110-kenichi/A1200LineDoubler/work/handoff_pending/README.txt

未検証の入力同期候補です。v0.27の基準ファイルではありません。V_IN/H_IN_3V3/V_IN_3V3が未完了。監査は未実行。修正後にwork/route_sync_in.pyで再生成し、.kicad_proを揃えてwork/audit_sync_in.pyで検査してください。
