110-kenichi/A1200LineDoubler/outputs/amiga_scandoubler/fab/v030wip/README.md

# 製造データ v0.30wip（2026-09-29）

**発注用の確定版ではない。** JLC などへのアップロードはしていない（CLAUDE.md の規則）。

## 中身
| ファイル | 内容 | 作り方 |
|---|---|---|
| `gerber/*.gtl .g2 .g3 .gbl` | 銅箔4層（F / In1=GND / In2=3V3 / B） | `kicad-cli pcb export gerbers`（KiCad 7.0.11、Protel 拡張子、Value を除外、シルクからマスク開口を削る） |
| `gerber/*.gts .gbs .gtp .gbp .gto .gbo .gm1` | マスク、ペースト、シルク、外形 | 同上 |
| `gerber/*-PTH.drl`, `*-NPTH.drl`, `*_map.svg` | ドリル（Excellon、mm、PTH と NPTH を分割）と穴位置の図 | `kicad-cli pcb export drill --excellon-separate-th --generate-map` |
| `cpl_raw.csv` | KiCad の部品位置データ（上面139点） | `kicad-cli pcb export pos --side front` |
| `jlc_cpl.csv`, `jlc_bom.csv` | JLC 形式の CPL と BOM（37行） | `work/v030wip/w30/scripts/r10_fab.py` |
| `parts_to_select.csv` | LCSC 番号が未選定の部品（32行、132点） | 同上 |
| `fab_check.json` | ドリルのヒット数と基板の照合結果 | 同上 |
| `preview_top.png` | 上面のプレビュー（gerbv で描画） | gerbv |
| `bitstream/*.fs` | FPGA ビットストリーム（H_SAMPLES 1816 / 2048） | apycula `gowin_pack -d GW1N-4 --sspi_as_gpio`（v0.31 cst で配置配線した結果から） |
| `*SHA256SUMS` | 各ファイルのハッシュ | sha256sum |

## 検査（実測）
- 対象の基板：`hardware/amiga_scandoubler_v030wip.kicad_pcb`。
- DRC：エラー0件、未接続0件。
  - 残っている警告は、ライブラリ設定（lib_footprint_issues、クラウドにライブラリの設定がないため）と、USB コネクタ J3 の外形シルクが基板端にかかる2件。
- 監査 `audit_sync_in_k7.py`：PASS（139部品、600パッドのネット）。
- 回路図とネットリストと基板のネットは一致（接続のある570ノード。未接続ピン25は除く）。
- ドリル：PTH 323 ＝ ビア285 ＋ PTH パッド38、NPTH 2。基板と一致した（J1/J2 をスルーホール品にした後の値）。
- RTL シミュレーション：12本すべて PASS（`work/v031dac/sim/`）。

## 発注前に必要なこと（未完了）
1. ~~**部品選定**~~：完了（全139点に LCSC 番号、2026-09-29。下の「部品選定」の節と `parts_selection.csv`）。
2. **CPL の補正と、JLC の実装プレビューでの確認（必須、利用者側）**
   - EasyEDA（JLC のライブラリ）のフットプリントと照合し、回転と位置の補正を `jlc_cpl.csv` / `jlc_cpl_dnp_J1J2.csv` に入れた（2026-09-30）。U1/U3/U4/U5 +270°、U2 180→90°、U6 180°、J4 90→0°、J3 は位置を 1.571mm 補正。根拠と全数の表は `cpl_rotation_check.md`。
   - これは EasyEDA のデータとの照合結果で、JLC の実装機がどう解釈するかまでは保証しない。**支払いの前に、発注画面の部品配置プレビュー（上面）で次を確認する。**ずれていたら発注画面で直すか、`jlc_rotation_check.json` を直して `r10_fab.py` を再実行する。
     - **J3（USB-C）**：差し込み口が基板の下端に来ること。4本の固定脚が長穴4個（x 43.18 / 51.82、y 88.22 / 92.40）に、2本の位置決めピンが穴2個（44.61 / 50.39, 88.75）に重なること。CPL の座標は KiCad の値から y 方向に 1.571mm 基板の内側へずらしてある（`cpl_raw.csv` の Mid Y −91.350 → `jlc_cpl` −89.779）。脚が長穴から外れていたら、この補正の解釈が違う。
     - **U1（TQFP-100）**：1番ピンが左上（18.35, 36.00）。CPL 回転 270°。
     - **U2（QFN-88）**：1番ピンが**右下**（54.95, 46.20）。基板上で 180° 回転している。CPL 回転 90°。
     - U3（左上）、U4/U5/U6、Y1（**左下**）、J4、U7–U9：`cpl_rotation_check.md` の「JLC のプレビューで確かめること」の表のとおり。
3. **ビアの処理：U1/U2 の中央パッド（EP）内のビアは「Epoxy Filled & Capped」（樹脂充填＋銅キャップ、POFV）を指定する（必須）**
   - 対象：U1 の EP（pad 101、6.2mm 角、中心 26.0, 42.0）に9個、U2 の EP（pad 89、6.8mm 角、中心 50.0, 42.0）に9個、計18個。すべて GND、外径 0.5mm／穴 0.3mm（2026-10-01 に 0.6mm から変更）。
     - U1：(24.0/25.5/27.0, 40.0/41.5/43.0) の 3×3。
     - U2：(48.0/50.0/52.0, 40.0/42.0/44.0) の 3×3。
     - ほかにパッドの中にあるビアはない（全285個を照合、2026-10-01）。
   - JLC の「**Plugged**」は、ソルダーレジスト（インク）でビアを埋める処理で、両面ともレジストの開口がないビアが対象（JLC の PCB capabilities の記載）。EP はレジストが開いているので**使えない**。「Tented」（レジストで覆うだけ）も EP 内では覆えない。どちらを選んでも、リフローではんだがビアに吸い込まれ、EP の接合不良（放熱・GND 不良）の原因になる。
   - JLC の「Epoxy Filled & Capped」は、ビアを樹脂で埋めて銅めっきでふたをする「via-in-pad」用の処理。6層以上では標準だが、この基板は4層なので、**注文画面の Via Covering で明示して選ぶ**。対応する径は「via diameters 0.15–0.55mm」（同じ記載）。JLC は「via diameter」を外径の意味でも使うため、EP 内の18個は外径を 0.5mm に下げた（穴 0.3mm のまま）。穴径・外径のどちらの意味でも範囲内。
     - 注意：外径 0.5／穴 0.3mm はランド幅 0.10mm で、JLC の DFM で「Annular ring」の警告が出る可能性がある（以前の DFM では 0.10mm 以下が危険の表示）。EP の中にあり、銅キャップで覆われるので、機能上は問題ない。
     - ほかのビアは外径 0.55mm（120個）と 0.6mm（146個）。Via Covering が基板全体に効き、かつ上限が外径の意味なら、0.6mm のものが範囲を外れる。発注画面で確認する。
   - 注文画面の Via Covering は基板全体に対する指定と思われる（未確認）。その場合、ほかのビア（267個）も同じ処理になるが、問題はない。費用の増加は発注画面で確認する。
   - 「Copper paste Filled & Capped」（銅ペースト充填）も使えるが、必須ではない。
4. **層構成**：インピーダンス制御は指定していない。JLC の標準4層（1.6mm）を想定。
5. **ビットストリーム**：
   - apycula のオープンソースツールで生成したもので、実機でも Gowin 純正ツールでも未検証。
   - 生成時に apycula が「IOLOGIC の INIT が未処理」と表示した（ODDR の初期値）。
   - H_SAMPLES 1816/2048 は暫定値で、PAL/NTSC の確定値ではない。
6. ~~**ERC**~~：KiCad 9 CLI で実行済み（2026-09-29）。除外（`hardware/erc_exclusions.json`）を適用して残り0件。詳細は revision_0.30wip.md。

## 部品選定（2026-09-29、JLCPCB の部品検索 API で在庫・価格を取得）
- スクリプト：`work/v030wip/w30/scripts/r11_select.py`（選定）→ `r11_apply.py`（manifest、回路図、ネットリストへ反映）。
  - 仕様は `r11_parts_spec.json`。API の呼び出しは `tools/jlcsel.py`（読み取りのみ。注文はしていない）。
- 結果は `parts_selection.csv` / `.json`：LCSC 番号、基本/拡張の区分、在庫、5枚分の数量での単価、代替2件。
- 選定の規則：
  - パッケージと仕様（容量、耐圧、誘電体、抵抗値、許容差、0.1% は薄膜）が一致するもの。
  - 基本部品 → 優先拡張部品 → 在庫の多いもの、の順。
  - 在庫は必要数の20倍以上を優先する。
- 確定したもの：37行中 35行（135点）。
  - 基本部品 15行、拡張部品 22行。
  - 部品代の目安は約 60.7 USD/枚（取得時点の単価。拡張部品の手数料と基板代は含まない）。
- 耐圧：C55/57/59（5V 入力）と C47/C54 は 25V の 10uF（CL21A106KAYNNNE、C15850）。回路図の値の表記「10V」は最低定格の意味として残した。
- **2026-09-29 追記（利用者の判断）**：
  - 製作は **2枚**。選定の数量も2枚分でやり直した（`BOARDS=2`）。
    - JLCPCB の PCBA は Economic・Standard とも最少2枚（公式の capabilities ページで確認）。
  - **Y1 を YXC OT2EL4C4JI-111OLP-27M（C5203549）に置き換えた**（`scripts/r12_y1.py`）。フットプリントは同じ。
  - U1 TVP7002（C3824085）はそのまま使う。在庫4個で、必要数2個に対して余裕は小さい。
  - J1/J2 は CONEC 33DSMT1-E15SNCT（C3146802、在庫0、0.76mm ピッチの SMD）から、**HOAUC HYC06-HDR15B-060（C711364、在庫2230、スルーホール）に置き換えた**（下の節）。
- 全139点の LCSC 番号がそろった。部品代の目安は約 44.6 USD/枚（2枚分の数量での単価。拡張部品の手数料、基板代は含まない。J1/J2 の2点分を含む。置き換え前は約 60.3 USD/枚）。

## J1・J2（DE-15 メス）：HOAUC HYC06-HDR15B-060、手はんだ（2026-09-29、利用者の判断）
- 部品：HOAUC HYC06-HDR15B-060（LCSC C711364、JLC 拡張部品、在庫2230、0.21 USD）。3列 HD-15 メス、90°曲げ、スルーホール。
  - データシート（2013-09-20 版）で寸法を確認：端子穴 φ1.09 の3列が基板の端から 3.08 / 5.06 / 7.04mm、横ピッチ 2.29mm。固定金具の PTH φ3.2 が2つ、25mm 間隔（中段と同じ列）。本体は基板の端から 8.9mm まで、前方に 5.9mm はみ出す。
  - フットプリント：`hardware/Amiga.pretty/DE15_HOAUC_HYC06-HDR15B-060.kicad_mod`（穴 1.1mm／ランド 1.7mm、固定金具 3.2mm／4.0mm、GND ＝ pad16）。
  - ピンの並びは DE-15 の規格どおり（部品面から見て pin1・pin6 が右側。KiCad 標準フットプリントと同じ）。データシートの穴配置図には「Top View」とあり、この並びと一致する。
- 発注：`jlc_bom_dnp_J1J2.csv`（36行）、`jlc_cpl_dnp_J1J2.csv`（137点）で J1・J2 を除き、ほかの部品を JLCPCB で実装する。J1・J2 は LCSC で別に買って手はんだで付ける。
  - JLC にスルーホール実装も任せる場合は、元の `jlc_bom.csv` / `jlc_cpl.csv`（139点）を使う（在庫あり）。
- 付け方の目安（推定）：端子15本・固定金具2本とも、はんだごてで1本ずつ付けられる。固定金具は熱容量が大きいので、こて先は太めを使う。付けたあと、テスターで隣どうしの短絡と、J1/J2 の各ピン ↔ 相手（J1：R15〜R18・R20、J2：R11〜R13・R22・R23）の導通を確認する。
- 旧 CONEC 品は Global Sourcing が必要だったが、その手配は不要になった。

## JLCPCB の DFM と発注画面への対応（2026-09-30）

- 詳細は `revision_0.30.md` の追記。基板を変更し、製造データを出し直した。
- ビアを31個動かした（パッドに近すぎる・パッドの中にあるもの）。J3 の長穴を 0.8mm に広げた。部品番号を50個置き直した。
- L1〜L3 を Taiyo Yuden NRS4018T2R2MDGJ（C92959）に変更（旧品は EasyEDA にフットプリントがなく、配置画面に出なかった）。
- C47/C54/C55/C57/C59 の値を「10uF 25V」にそろえ、BOM を1行にした。
- U1（在庫4）：発注画面の実装数を **2枚** にする。
- DFM で残るもの（対応不要と判断）：U2/U3 のピン間 0.2mm、0.5/0.3mm のビア1個（リング 0.10mm）、C18.1 とビアの隙間 0.05mm（同じネット）、同じネットの配線とマスク開口の近さ、ビアのリング 0.125mm（橙）。
- 2026-09-30 追記：IC のピンとピンの間を通っていた配線（U1 の11組・U3 の3組・U5.5）を撤去し、つなぎ直した。JLC DFM の「Solder mask opening exposing trace」の危険1件（U1.84/85）の原因。
- 2026-09-30 追記：同じネットで重なっていた配線（44組）と行き止まりの配線を削除し、U1.93/94・C27・C28 周りの配線を整えた（電気的な接続は変わらない）。
- 2026-10-01 追記：C27–U1 間の GND の配線、C21 の 3V3 ビアの位置、U4.5–C51 の配線を整えた（電気的な接続は変わらない）。
- 2026-10-01 追記：ルーターが残した細かい段差（短い斜め線と水平・垂直線の繰り返し）をならし、不要な GND の回り込みを削除した（電気的な接続は変わらない）。
- 2026-10-01 追記：EP 内ビアの指定を「Plugged」から「Epoxy Filled & Capped（POFV）」に訂正し、対象18個を明記した。JLC のプレビューで確かめる項目（J3 の位置、U1/U2 の1番ピン）を具体的に書いた（利用者の指摘）。
- 2026-10-01 追記：U1/U2 の EP 内のビア18個の外径を 0.6mm から 0.5mm に変えた（穴 0.3mm のまま、`scripts/ep_via05.py`）。
- 2026-10-01 追記：配線の角のはみ出しを直した（5V 幹線と C55/C57/C59 の縦線の幅をそろえ、C59 側の延び過ぎを削った。U3.31・U1.15 の GND の端）。
- 2026-10-01 追記：JLC の DFM（発注画面）の指摘を直した（シルクとパッド・穴、C27 付近の配線）。U2 の1番ピンの印を少し移し、「REV 0.30」の文字を Y1 の右へ移した。残る危険3項目（Pad spacing・Annular ring・Via to pad）は許容と判断した（revision_0.30.md）。
