110-kenichi/A1200LineDoubler/outputs/amiga_scandoubler/hardware/footprint_review.md

# フットプリントの確認記録

2026-09-09。回路図に対応する部品実装パターンの検討版。配線済み基板ではない。

## FPGA：GW1N-LV4QN88C6/I5

ローカルライブラリー`Amiga.pretty`に`QFN-88_GW1N4_10x10_P0.4_EP6.8`を作成した。GOWIN UG103-2.9.6Eの図4-25・図4-26（冊子108–109ページ、PDF122–123ページ）を確認した。

- 本体10mm角、信号88端子、ピッチ0.4mm。
- メーカー推奨ランドは0.85 × 0.20mm、対向する列の中心間隔9.90mm。
- 中央の銅箔ランドは6.8mm角、回路図の89番（GND）へ接続する。
- 前版の名称にあったEP6.7を訂正した。パッケージ側の公称6.74mmとPCB推奨ランドの6.8mmを区別する。
- ペーストは1.4mm角×16窓、1.6mmピッチの案。中央銅箔に対する面積比は約67.8%。これは製造側と調整する設計値で、メーカー図面の指定値ではない。

## ADC：TVP7002PZP

`TQFP-100_TVP7002_14x14_P0.5_EP6.2`を作成した。TI資料末尾の機械図4146929/Cと放熱パッド図4206333-3/Lを確認した。

- 本体14mm角、端子ピッチ0.5mm、外形はリードを含め約16mm角。
- 放熱パッド図の寸法範囲は4.69–6.20mm。前版で仮指定した9.5mm角はこの図面に一致せず、使用を取りやめた。
- 中央銅箔は6.2mm角、101番（GND）。これは実パッケージの放熱パッドを常に6.2mm角と断定するものではない。
- 外周ランドは1.5 × 0.30mm、対向列の中心間隔15.3mmとした。メーカーのリード寸法から選んだ案で、専用推奨ランドの転載ではない。
- 中央ペーストは1.0mm角×16窓、1.15mmピッチ。窓全体は4.45mm角に収め、最小パッド寸法を考慮した。接合面積、放熱性能、ステンシル厚は実装条件と合わせて確認が必要。

## 電源：TPS62160DSGR

KiCad標準`WSON-8-1EP_2x2mm_P0.5mm_EP0.9x1.6mm`をTIのDSG0008A基板例と照合した。外周8端子は0.5 × 0.25mm、ピッチ0.5mm、対向列の中心間隔1.9mm、中央パッドは0.9 × 1.6mmで一致した。

## DE-15：33DSMT1-E15SNCT

メーカー図C041003Aを確認した。信号パッド15個は単純な1～15順ではなく、図面の左から`6,11,1,7,12,2,8,13,3,9,14,4,10,15,5`となる。固定穴は直径3.05mmが2個、位置決め穴は直径1.50mmが2個。間隔はそれぞれ24.99mm、15.46mm。

v0.4で仮フットプリントを作成した。信号パッドは0.30×3.70mm、穴の中心線に対しパッド中心を0.65mmずらした。0.76mmピッチを採用しているため、信号列の両端中心間は10.64mmとなり、図面の全幅10.68mmとの丸め差は未解決事項として残す。本体の表示は保守的な配置予約範囲。基板端との位置、固定脚の実装は未確定であり、製造承認済みのフットプリントではない。

## v0.4追加：発振器・インダクター・USB

ECS-3225MVLCは推奨ランド1.3×1.1mm、中心間隔2.3×1.9mm、端子1を上面視の左下として専用パターンを作成した。TDK VLS4012CX用には1.3×4.0mmの2ランド、ランド間の空き1.4mmのパターンを作成した。

USBにはKiCad標準のHRO TYPE-C-31-M-12用パターンを使用する。メーカーの2020-12-08図面を参照し、端子の対応を確認した。標準パターンと図面では一部の公称寸法・クリアランスが一致しないため、注文時の図面改版と現物への適合確認を残す。

## 検査と残る作業

作成した2パターンはKiCadの基板ライブラリー読込で検査し、89端子／101端子の番号、ピッチ、中央パッド寸法を照合した。結果は`footprint_report.txt`。

中央パッドにサーマルビアはまだ組み込んでいない。基板の銅箔・電源配置と併せて設計する。v0.4では全134部品に配置用のフットプリントを割り当てたが、全品の実装条件を検証済みという意味ではない。BOM/CPLの発注用出力や配線後の基板DRCも未完了。

資料：

- [GOWIN UG103 Package and Pinout](https://cdn.gowinsemi.com.cn/UG103E.pdf)
- [TI TVP7002データシート](https://www.ti.com/lit/ds/symlink/tvp7002.pdf)
- [TI TPS62160データシート](https://www.ti.com/lit/gpn/tps62160)
- [CONECメーカー図C041003A](https://mm.digikey.com/Volume0/opasdata/d220001/medias/docus/1039/33DSMT1-E15SNCT_Dwg.PDF)
