110-kenichi/A1200LineDoubler/revision_0.28.md

# v0.28 入力同期配線（2026-09-27, Claude）

基準：v0.27 `amiga_scandoubler_sync_out.kicad_pcb` → ChatGPT作業途中の入力同期候補（`work/handoff_pending/`）→ 本版。
成果基板：`hardware/amiga_scandoubler_sync_in.kicad_pcb`（KiCad 7形式 version 20221018 のまま。テキスト編集で追記し、KiCad 10で保存していない）。
**製造可能な完成品ではない。未接続146件。**

## 変更内容

| 対象 | 内容 |
|---|---|
| H_IN, H_IN_BUF, V_IN_BUF, U4/C51電源, R19/R21プルアップ | 候補の生成結果をそのまま採用（独立監査で合格） |
| B_IN | J1.3出口の縦配線をx=7.8→8.6mmへ移動（45°ジョグ）。長さ16.33mmで不変。V_IN引出しの通路確保のため |
| V_IN | J1.14 → F.Cu 2.35mm → ビア(8.0,44.28) → B.Cu → ビア(11.5,58.4) → R20.1。総長18.99mm、ビア2 |
| ADC_1V9PLL | U1上辺内側を囲っていたF.Cu冗長ループ（FB3右側→y=35.4の内周）を削除し、ビア(30.9,32.0)を追加してC25側F.Cuと既存In2.Cu経路を接続。総長51.5→38.6mm。C25→U1.84/85は In2経由 約5.5mm＋ビア2（旧：F.Cu約13mm） |
| H_IN_3V3 | U1.81 → QFP内周F.Cu(x=29.45) → ビア(29.45,45.7) → B.Cu斜行 → ビア(18.75,57.35) → U4.6。28.41mm、ビア2 |
| V_IN_3V3 | U1.78 → QFP内周F.Cu(x=31.0) → ビア(27.65,46.3) → B.Cu斜行 → ビア(17.5,56.45) → U4本体下F.Cu → U4.4。33.20mm、ビア2 |
| In1.Cu GND面 | KiCad 10で再充填した充填形状をKiCad 7形式へ移植（再充填なしのDRCでも同結果） |

配線はクラウドで作成した格子A*ルーター（F/B層＋貫通ビア、0.05mm格子、全層・穴間隔・基板端0.5mmを考慮）で探索し、下記の予約領域を与えた。

## 予約・設計上の配慮

- **REF_27M（U1.80）用の脱出路を予約**：ピン80内側F.Cu x=30.0、ビア候補(30.05,37.1)、B.Cu右向き通路y=37.1。H/Vはこれを避けた。
- **U1露出パッド下（22.4–29.6 × 38.4–45.6mm）のB.Cuとビアを予約**：将来のサーマルビア用。H/VのB.Cu配線は露出パッド外。
- U4本体下へのビア配置、SMDパッド上ビア（via-in-pad）を禁止。
- ADCデータが出る下辺・右辺の外側F.Cuは使わない（下辺外側F.Cuを禁止して探索）。

## 独立検査（KiCad 10.0.4）

- `work/audit_sync_in.py`（KiCad 10対応に最小修正：DRCはkicad-cli `--refill-zones`）：**PASS**。既存57接続、電源75・GND80検査、592パッドのネット照合、PLL 4ネットはF.Cuのみ・ビア0を維持。
- 入力同期6ネット・出力同期6ネットとも全端子導通。
- DRC：短絡・クリアランス・穴間隔・配線端/ビア未接続 **0件**。未接続 160→146（v0.27比で減少のみ、増えたネットなし：3V3 17→13、GND 36→34、入力同期6ネット各0）。
- 残る指摘：シルク関連（文字高さ135、シルクと銅箔103、シルク同士25、基板端2）と `lib_footprint_mismatch` 127。後者はKiCad 10付属ライブラリとの差分照合で、基板の電気的不良ではない。

## 未解決・要再評価

1. ADC_1V9PLLのデカップリング経路が変わった（C25→84/85がIn2＋ビア2）。PLL電源品質は再評価が必要。
2. H/V_IN_3V3のB.Cu斜行はU1左下の下側を通る。下辺ピン（ADC_CLK, ADC_B7–B0）をB.Cuで逃がす場合の制約になる。
3. V_IN_3V3はU4本体下を通過（DRC合格、実装上の問題は想定しないが目視確認推奨）。
4. KiCad 7で開いた際の確認は未実施（形式・構文は既存行と同一）。
