110-kenichi/A1200LineDoubler/outputs/amiga_scandoubler/revision_0.30.md

# v0.30 全配線完了・製造データ一次版（2026-09-29, Claude）

基準：v0.29 `hardware/amiga_scandoubler_u2rot.kicad_pcb`（未接続143件）→ 本版 `hardware/amiga_scandoubler_v030wip.kicad_pcb`（KiCad 7 形式 `(version 20221018)` のまま）。
ファイル名の `v030wip` は作業中の名前をそのまま使っている。**この版の内容が v0.30 である。**
作業の詳細な経過は `revision_0.30wip.md`（日付順の作業ログ）にある。

**発注用の確定版ではない。** 発注・アップロードはしていない。実機での検証もしていない。

## 概要

- 全ネットを配線した。DRC エラー0件、未接続0件（v0.29 は143件）。
- FPGA の DAC 側のピン割当を変えた（v0.31 cst）。U2→U3 のバスが交差なしの扇形になった。
- 全139部品に LCSC 番号を付け、JLC 形式の製造データ一式を出した。
- J1/J2 をスルーホールの DE-15 メスに替えた（利用者が手はんだで付ける）。
- ERC を実行した。利用者が決めた除外を適用すると、残りは0件。

## 変更内容

| 対象 | 内容 |
|---|---|
| U1 周り | U1 下辺のパスコンを並べ直し、EP に GND サーマルビアを追加した |
| ADC バス（24本） | 全部 F.Cu でビアなし（R：45°の入れ子、G/B：U 字の帯）。ADC_CLK はビア2個 |
| ADC_HS/VS | 南回りの B.Cu。各ビア4個 |
| 制御線 | I²C・RESET・PWDN（U1↔U2）、プルアップ R37–R40 を 0402 に変更、POWER_GOOD、DAC_PSAVE_N、JTAG 系・設定ピン（4–10番） |
| 1V2 のリンク | U2 の左右とも、B.Cu から In2.Cu へ移した |
| FPGA のピン割当（v0.31） | DAC R0=47、R1–R7=42–36、G=35–28、BLANK=27、B0/B1=26/25、B2–B7=20–15、H/V_OUT=14/13、DAC_CLK=3（ODDR は X0Y1）。RTL は変更なし |
| DAC バス（24本＋BLANK） | 全部 F.Cu で交差なし。ビアは R0 の2個だけ。C42（COMP）を 0402 に変更 |
| H/V_OUT・DAC_CLK | U5・U6・R41–R43 へ配線 |
| 電源 | 浮いていたパッド28個に面ビアを追加。アナログ電源（ADC_3V3A、ADC_1V9PLL、DAC_3V3）を個別に接続 |
| アナログ入力 | RIN/GIN/BIN/SOGIN の残り7本（実際に使う RIN_1 12.1mm、BIN_1 10.0mm、GIN_1 20.1mm） |
| 配線レビューへの対策 | C70/C71（U2 の VCCO のパスコン）、In2 の引き直し（GIN_1 の基準面の切れ目 4.9→4.5mm）、C72/C73（REF_27M のビアの近くのパスコン） |
| シルク | 部品番号を 0.8mm にそろえ、自動で置き直した。R15 だけ非表示（F.Fab には残る） |
| 部品 | 139点（C70–C73 を追加）。Y1 を YXC OT2EL4C4JI-111OLP-27M（C5203549）に変更 |
| J1/J2 | CONEC 33DSMT1-E15SNCT（SMD、在庫0）→ HOAUC HYC06-HDR15B-060（C711364、スルーホール）。新フットプリント `Amiga.pretty/DE15_HOAUC_HYC06-HDR15B-060.kicad_mod` |
| ERC | 9本の電源ネットに PWR_FLAG を追加（05_power）。U3.27/31/33 は `hardware/erc_exclusions.json` で除外 |

## 検査（実測）

- DRC（KiCad 7.0.11、ゾーン再充填後）：エラー0件、未接続0件。
  - 警告は、J3 の外形シルクが基板端にかかる2件と、ライブラリ設定の lib_footprint_issues（クラウドにライブラリ表がないため）だけ。
- 監査 `audit_sync_in_k7.py`：PASS（既存57接続、電源75・GND80の検査、139部品、600パッドのネット）。
- 回路図から書き出したネットリストと基板：接続のある570ノードで一致（ほかに未接続ピンが25）。
- ERC（KiCad 9.0.9 CLI、読み取りのみ、`tools/erc_k9.sh`）：720件。除外（グリッド外717件、U3 の反転出力3件）を適用して残り0件（`tools/erc_check.py`）。
- 製造データ：ドリルのヒット数は PTH 323（ビア285＋PTH パッド38）、NPTH 2 で、基板と一致した。
- FPGA（nextpnr、v0.31 cst）：1816/2048 とも全クロック PASS（2048：video 89.50MHz、adc 310.75MHz、clk_ref 72.61MHz）。verify_phase180 も PASS。
- RTL シミュレーション（Icarus Verilog 12）：12本すべて PASS（82件）。

## 推定値（合格判定ではない）

- ADC 取り込みの余裕：+4.285ns（High 52%、SDF の欠落分を仮定で補った値）。基板上のずれは −0.11〜+0.15ns。
- DAC：データ線 29.6–48.9mm、クロック経路 32.5mm。基板上の差は −21〜+118ps。U2 のパッド遅延が SDF にないため、確定ではない。
- 部品代：約 44.6 USD/枚（2枚分の数量、取得時点の単価。拡張部品の手数料と基板代は含まない）。

## 製造データ（`fab/v030wip/`、詳細は同フォルダーの README）

- Gerber（4層）、ドリル（PTH/NPTH）、CPL、JLC 形式の BOM/CPL、J1/J2 を除いた BOM/CPL（発注用）、プレビュー、SHA256SUMS。
- ビットストリーム：H_SAMPLES 1816/2048 の2種類（apycula で生成、実機未検証）。
- 基板ファイルの sha256：`c9bbe6a87b095d56ab82b0860cec024ec07e15e6281389af86d80c3ab0d01990`。

## 利用者の判断（この版で決めたこと）

- R37–R40 と C42 を 0402 に変更。C37/C31/R4/R9 の移動。
- DAC 側のピン割当の変更（v0.31）。
- 製作は2枚。U1 TVP7002 は在庫4のまま採用。Y1 を置き換え。
- J1/J2 は HYC06-HDR15B-060 にして手はんだで付ける。U1/U2 は JLC で実装する。
- ERC：PWR_FLAG を追加。U3.27/31/33 は回路をそのままにして除外。

## 残っている作業

発注の前：
1. JLC のプレビューで CPL の回転を全数確認する（利用者側）。特に J3 の位置（1.571mm 補正）と U1/U2 の1番ピン。
2. 発注時に、U1/U2 の EP 内のビア（計18個）を **Epoxy Filled & Capped（POFV）** に指定する。（2026-10-01 訂正：以前は「充填（plugged）」と書いていたが、JLC の Plugged はレジストで埋める別の処理で、EP には使えない。）

未評価・未検証：
- J1/J2 の実物のはまり具合（穴径、固定金具、ケースとの位置）。J1 の H/V は基板の端を回るため長くなった。
- C29/C35/C40 と C42 が電源ピン・COMP ピンから離れている点。DAC バスの信号品質とクロストーク。
- U3 の反転出力を GND に落とす使い方（ADV7125 のデータシートでの再確認ができていない）。
- PLL の実際の位相とジッター、hold と recovery/removal、DAC 端子での setup/hold、PSAVE が Low のときのアナログ出力。
- PAL/NTSC の実入力のプロファイル、長いラインと短いラインが続く場合。H_SAMPLES 1816/2048 は暫定値。
- ADC_1V9PLL のデカップリング経路の品質。V_IN_3V3 が U4 本体の下を通る点の目視確認。

## 追記（2026-09-30）CPL の回転の補正

- EasyEDA（JLC のライブラリ）のフットプリントと KiCad のフットプリントを、パッド番号ごとに照合した（`tools/jlc_rotcheck.py`、結果 `fab/v030wip/jlc_rotation_check.json`）。JLC で実装する137点のうち、L1〜L3 以外はすべて照合できた。
- 補正（`scripts/r10_fab.py` が CPL の出力時に適用）：U1/U3/U4/U5 +270°、U2 180→90°、U6 +180°（x −0.033mm）、J4 90→0°、J3 は位置を 1.571mm 基板の内側へ。2端子部品で 90° ずれるものは0件。
- J1/J2 の EasyEDA フットプリントは、信号ピンの並びがこの基板と同じだった（ピンの左右の向きの裏付け）。
- 基板・回路図は変更していない。プレビューでの確認は `fab/v030wip/cpl_rotation_check.md` の表で行う。

## 追記（2026-09-30）JLCPCB の DFM と発注画面への対応

利用者が JLCPCB の DFM（PCB DFM）と部品の画面で確認した結果への対応。基板を変更した。

### DFM の赤の項目と対応

| DFM の項目 | 原因（基板データで特定） | 対応 |
|---|---|---|
| Pad spacing（表面 赤10） | パッドと同じネットのビアの間隔 0.05〜0.063mm（C11/C18/C34/C43/C46/C5/C54、FB1〜FB4）。JLC はビアのランドもパッドとして数える | ビアを動かした（下記） |
| Via to pad（赤1） | U2.67 と 3V3 ビア (45.6, 47.6)。穴の縁からパッドまで 0.114mm | ビアを動かした |
| Annular ring（赤1・橙98） | 0.5/0.3mm の GND ビア (17.15, 46.45) のリング 0.10mm。橙は 0.55/0.3mm のビア（0.125mm） | 0.55mm に広げると U1.22 と ADC_1V9A の配線とのクリアランスが足りない（0.175mm）ので **そのまま**。JLC の製造能力の範囲内 |
| Slot width（赤4） | J3 の固定用の長穴4個、幅 0.6mm | **幅 0.8mm・パッド 1.2mm に広げた**（JLC/EasyEDA の C165948 のフットプリントと同じ幅）。新フットプリント `Amiga.pretty/USB_C_Receptacle_HRO_TYPE-C-31-M-12_Slot0.8.kicad_mod` |
| Solder mask opening exposing trace（赤7） | パッドにつながる同じネットの配線やビアが、パッドの開口の近くにある。別のネットの銅が開口から 0.15mm 以内にあるものは0件（実測） | 短絡の恐れはないので対応なし。ビアの移動で一部は解消 |
| Silkscreen to pad（赤36）／to hole（赤50） | 部品番号がパッドやビアの穴に近い | 50個の部品番号を置き直した。FB2/R16/R17 は置き場所がなく非表示（F.Fab には残る。R15 と合わせて4個） |

### DFM では出ていなかったが見つけた問題：受動部品のパッドの中のビア

- C56/C58/C60（22µF）、C59（10µF）の GND パッドと、C71（0402）の 3V3 パッドの中に、ビアの穴があった（穴の93〜100%）。はんだがビアに吸われ、C71 では部品が立つ不良（ツームストーン）の原因になる。
- 対応：すべて解消した（U1/U2 の EP 内のビアは意図どおりで対象外）。

### ビアの移動（`scripts/dfm_vias.py`、実測）

- パッドとの隙間が 0.1mm 未満、またはパッドにかかっていたビア36個のうち31個を動かした。つながる配線の端も一緒に動かす。隙間 0.15mm 以上（1個だけ 0.10mm 以上）。
- 動かせなかったもの：C70/C71.2 のビア（穴はパッドの外。ランドが接しているだけ）、C18.1 の ADC_1V9A ビア（隙間 0.05mm、同じネット、周りが混んでいる）。
- C71 は `scripts/dfm_fix2.py` で x を +0.4mm ずらして 3V3 ビアの穴をパッドの外に出した。C29 もコートヤードが重ならないよう +0.4mm。GND ビア (55.55, 36.3) → (55.55, 36.45)。

### 部品（発注画面の指摘）

- **L1〜L3**：C7413169（TDK VLS4012CX-2R2M-1）は EasyEDA にフットプリントがなく、JLC の配置画面に出なかった。→ **Taiyo Yuden NRS4018T2R2MDGJ（C92959）** に変更。2.2µH、Isat 3A、定格 2.2A、DCR 42mΩ、在庫 10,752。EasyEDA のランド（1.2×4.0mm、±1.4mm）は今のランド（1.3×4.0mm、±1.35mm）とほぼ同じで、フットプリントは変えていない。高さが 1.2→1.8mm になる。
- **C47/C54/C55/C57/C59**：同じ C15850 なのに値の表記（「10uF」「10uF 10V」）が違い、BOM の2行に分かれていた。JLC の画面ではこれが数量0・未選択になっていた。→ 値を「10uF 25V」にそろえて1行にした。C15850 の在庫は十分にある（API で確認）。
- **U1（TVP7002）**：在庫4個。発注画面の実装数が5枚になっていたため1個不足。**実装数を2枚にすれば足りる**（PCB を5枚作り、2枚だけ実装することもできる）。部品の変更はしていない。

### 検査（実測）

- DRC：エラー0件、未接続0件（既知の警告のみ）。未接続の比較（`uncmp.py`）：0→0。
- 監査 `audit_sync_in_k7.py`：PASS（139部品、600パッドのネット）。
- ERC（KiCad 9 CLI）：除外を適用して残り0件。回路図と基板のネットは 570 ノードで一致、値とフットプリント名も全部品で一致。
- 製造データを出し直した：BOM 36行（J1/J2 抜きは35行+ヘッダー）、ドリル PTH 323・NPTH 2 で基板と一致。CPL の回転補正を取り直した（L1〜L3 も照合できた）。

### 修正（2026-09-30、利用者の指摘）C59 の GND 配線の切断と、ループの台形

- **不具合**：コミット 41883af の基板で、C59 の GND パッドとビアをつなぐ 0.6mm の配線が長さ0になり、パッドの角をかすめる 0.2mm の配線だけでつながっていた（DRC の未接続には出なかった）。原因は `dfm_vias.py` が、ビアの円の内側に両端がある 0.25mm の短い線まで、ビアと一緒に動かしたこと。
- **対策**（`dfm_vias.py`）：
  - 端がパッドの上にある短い線は動かさない。
  - ビアに接していた同じネットのパッドのうち、移動する配線でつながらないものには、パッドの中心から新しいビアまで、同じ太さの線を新しく引く。
  - ビアの内側だけに収まる極短の線は、長さ0にしてからテキスト編集で削除する（27本）。
  - ビアを動かす方向は、縦・横・45°を優先する。
- **台形**：ビアの移動で斜めになった 0.6mm の配線（レギュレータ周りのループ6か所と USB_VBUS の1か所）は、角の点をビアと同じ座標に動かして、直角に戻した（`dfm_fix2.py`）。
- **検査を追加**：`tools/padconn_cmp.py`。前後の基板で、各パッドに触れる配線の最大幅と、ビアとの接触を比べる。41883af では C59.2 だけが「0.6→0.2mm」と検出され、今回の基板では0件。
- 移動したビアは30個。動かせなかったのは C70/C71.2（ランドがパッドに接するだけ）、C18.1（隙間 0.05mm）、**U2.67/C34 の 3V3 ビア**（西は In2 の 1V2 の配線、ほかに空きがない。穴の縁から U2.67 まで 0.114mm、C34.1 まで銅どうしで 0.05mm。同じネットで蓋あり）。
- 検査（実測）：DRC エラー0・未接続0、未接続の比較 0→0、監査 PASS、回路図と基板は 570 ノード・値・フットプリント名とも一致、ERC は除外を適用して0件。製造データを出し直した（BOM・CPL の内容は変わらない）。

### 修正（2026-09-30、利用者の指摘）IC のピンとピンの間を通る配線

- JLC DFM の「Solder mask opening exposing trace」の危険1件（0.05mm）は、U1 のピン84/85（どちらも ADC_1V9PLL）の 0.2mm の隙間を、0.15mm の配線が通っている箇所だった。
- 同じ形（隣り合うピンの隙間を通る配線）を全 IC で調べると、U1 に11組、U3 に3組あった。いずれも同じネット（GND、ADC_1V9A、ADC_3V3A、ADC_1V9PLL）の隣のピンどうしを、ルーターが隙間を通してつないだもの。ほかに U5.5（3V3）の引き出しが U5.4 との隙間に入っていた（別のネットだがクリアランス 0.2mm は満たしていた）。短絡の恐れはないが、隙間のマスクが残らず、はんだ付けと検査の面で望ましくない。
- 対応：
  - `scripts/dfm_u1pll.py`：U1.85 をパッドの先端からまっすぐビア (27.8, 36.0) へ。
  - `scripts/dfm_gapfix.py`：隙間に入る区間52本と、消したことで浮いた切れ端18本を削除。孤立した12本のピン（U1.6/13/20/42/67/72/77/82/90/91/93、U3.26/40）を、隙間を通らない経路で同じネットの配線やビアへつなぎ直した（ルーター。隙間のマスを通行禁止にした。U1.72 だけは手で配線）。U5.5 の引き出しは曲がり点を動かし、パッドの内側の端から出るようにした。
- 検査（実測）：
  - IC のピンの隙間を通る配線：0本。
  - DRC：エラー0、未接続0。未接続の比較：0→0。
  - 監査：PASS。
  - 回路図と基板：570ノードで一致。
  - パッドの接続の比較（DFM 対応前の基板と比べて、細くなった・失われた接続）：0件。
  - シルク：置き直しは不要（0個）。
  - 製造データを出し直した。BOM・CPL の内容は変わらない。

### 修正（2026-09-30、利用者の指摘）重なった配線・行き止まりの配線

- 指摘の箇所（U1 のピン93/94 と C27 の間、ADC_3V3A）では、U1.93 の 0.2mm の引き出しと C27 への枝が、U1.94 の 45° の配線に中心から約 0.035mm ずれて合流していた。0.05mm の切れ端も残っていたため、2本が重なった Z 字形に見えた。さらに C28 へは、U1.94 からの線（x=21.25）と In2 のビア (20.225, 32.0) からの階段状の線（x≈21.0）の2本が、0.25mm 間隔で並んでいた。
- 基板全体を調べると、同じネット・同じ層で重なる配線が44組あった（主に、配線をやり直した際の残り。0.05mm ずれた写しや、同じ線の重複）。
- 対応：
  - `scripts/dfm_dedup.py`：重なる組のうち短い方を削除した（41本）。削除するのは、そのネットのパッドのつながり方（どのパッドとどのパッドが導通しているか。GND/3V3 のビアは面でつながっているものとして扱う）が変わらない場合だけ。浮いた切れ端も同じ条件で削除し、端がはみ出した線は近くのビアやパッドの中心まで縮めた。ファイル上の削除は50行。
  - `scripts/dfm_spur.py`：どのパッドの間の経路にも乗っていない配線（行き止まり）を削除した。ネットごとに銅の重なりでグラフを作り、二重連結成分に分ける。切断点が1つだけで、ほかにパッドを含まない成分を、なくなるまで繰り返し削除する。GND/3V3 は面を通してもつながるので対象外にした。
    - ADC_1V9PLL（In2）：(29.3, 31.75) から西の (26.3, 31.9) で折り返す約 3mm の行き止まり（12本）。端がすべて自分の銅に触れているため、KiCad の未接続端の検査では出なかった。
    - H_OUT：R22 付近の長さ 0.025mm の重複2本。
  - `scripts/dfm_tidy.py`（手作業）：
    - U1.93 は 45° で U1.94 の角 (23.0, 33.35) に合流させた。C27 への枝は、同じ 45° の線上にある既存の角 (22.0, 32.8) から出した。
    - C28 への線は1本にした。x=21.25 の線と階段状の線をやめ、ビア (20.225, 32.0) から 45° と縦の1本にした。これで ビア→C27、ビア→C28、U1.93/94→C27 の木の形になり、ループはなくなった。
    - ADC_1V9PLL（In2）：行き止まりを消したあとに残った斜めの線 (30.95, 30.15)–(29.35, 31.75) と、それに沿った2本を削除した。
    - H_OUT：R22.2 への斜めの線が合流点 (83.5, 46.6) を 0.28mm 越えていたので、そこまで縮めた。
- 検査（実測）：
  - 同じネットで重なる配線：44組→0組。配線の区間数は 1984→1902。
  - 行き止まり（GND/3V3 以外）：0。
  - DRC：エラー0、未接続0、未接続端（track_dangling）0。未接続の比較：0→0。
  - 監査：PASS。
  - 回路図と基板：570ノードで一致。
  - パッドの接続の比較（DFM 対応前の基板、および今回の修正前の基板と比べて、細くなった・失われた接続）：いずれも0件。
  - シルク：置き直しは不要（0個）。
  - 製造データを出し直した。BOM・CPL の内容は変わらない。
- 残り：0.05mm 格子のルーターが作った、合流点の小さな段差（0.05〜0.2mm）は残した。画像で確認し、2本に見える箇所ではないと判断した（ADC_1V9A の In2、U1.13/14、3V3、1V2 など）。GND の同様の段差は、F.Cu の GND ベタにも埋もれるため手を入れていない。

### 修正（2026-10-01、利用者の指摘）C27 と U1 の間の GND、C21 のビア、U4.5–C51

- C27 と U1 の間（GND）：U1.90 と U1.91 の 0.2mm の線が、0.28mm 間隔の平行な 45° 線になってビア (24.0, 32.95) の手前で階段状に合流し、その隣 0.25mm に C27.2 の線も並んでいた。重なってはいないが、2〜3本が重なったように見えていた。
  - U1.91 は縦に上がって 45° でビアへ。U1.90 は U1.91 の角 (24.5, 33.35) に合流させた（U1.93→U1.94 と同じ形）。C27.2 はビアの中心へ横から入れた。
- C21：ビアは重なっていなかった。GND ビア (27.6, 53.9) と 3V3 ビア (28.35, 54.2) の隙間が 0.26mm で、重なって見えた。3V3 ビアを (28.6, 54.1) へ移し、隙間を 0.47mm にした（引き出しも合わせて変更）。基板全体でもビアの重なりは0（隙間はすべて 0.2mm 以上）。
- 同じ形（同じネットで平行、隙間 0.15mm 未満）を全体で調べると、ほかに U4.5→C51.1（3V3）の1箇所があった。U4.5→C51 の線と、ビア (19.5, 58.775)→C51 の斜めの線が 0.016mm の隙間で並んでいた。y=59.0 の1本（U4.5→ビア→C51）にした。
- スクリプト：`scripts/dfm_tidy2.py`。
- 検査（実測）：DRC エラー0、未接続0。未接続の比較 0→0。監査 PASS。570ノードで一致。パッドの接続の比較 0件。行き止まり0。平行に並ぶ同じネットの線（隙間 0.15mm 未満）0。製造データを出し直した（BOM・CPL は変わらない）。

### 修正（2026-10-01、利用者の指摘）短い斜め線と水平・垂直線を繰り返す配線（ルーターの段差）

- 指摘の箇所（C6・R16・C18・C16 付近）をはじめ、自作ルーター（0.05mm 格子の A*）が引いた配線に、0.05〜0.3mm の斜め線と水平・垂直線を交互に繰り返す段差が残っていた。基板全体で、両端が曲がっている 0.3mm 未満の区間（`tools/jogscan.py` で数えた）は198か所あった。
- 対応（各段は前段の出力を入力にした）：
  1. `scripts/dfm_planeloop.py`：GND／3V3 の線で、段差があり幅 0.2mm 以下のものは、それがなくても各パッドがビア（または貫通パッド）経由で面につながる場合に削除した（長いものから順に。DRC の未接続端の報告も同じ条件で削除）。R16 から C18.2 へビアを回り込んでいた GND の弧（3.35mm）と、U3 右の GND の短い線。幅 0.25mm 以上の電源の線（レギュレーター周りなど）は対象外。
  2. `scripts/dfm_smooth.py`：同じネット・層・幅の線が、パッド・ビア・分岐点・幅の変わり目の間で連なる部分（鎖）について、両端を固定したまま引き直した。今の点から、直線1本か「45°＋直線」の2本で届く、いちばん先の点へ進む。2本の形が2通りあるときは、元の経路に近い方を選ぶ。条件は、他のネットとのクリアランス 0.2mm、同じネットのパッドとビア（鎖の両端を除く）に触れないこと（ピンの隙間に入らない）、同じネットの線と中心線が交差しないこと、NPTH の穴 0.25mm、基板端 0.5mm。2回かけた（63本の鎖、399区間→191区間）。鎖を作る処理は `tools/trackchains.py` に分けた。
  3. `scripts/dfm_dedup.py` をもう一度かけた（重なり1組）。
  4. `scripts/dfm_tidy3.py`（手作業。分岐点があり、自動では鎖にならない箇所）：U1.77/79 の GND、x≈26.9 の GND の縦線、U1.13/14 の ADC_3V3A、FB4–C42–C47 の DAC_3V3、U2 の角の GND（2回目の引き直しでできた平行な斜め線）。
- `tools/pcbedit.py` の `remove_segment` に `dup_ok` を追加した（同じ線が2本重複して登録されている箇所を1本ずつ消すため）。
- 検査（実測）：
  - 短い段差：198→14か所。残りは、角の面取り（BIN_2、PLL_F、1V2 など）、パッドのすぐ手前の段、In2 の太い線の小さな段で、画像で確認した。
  - 配線の区間数：1902→1621。
  - DRC：エラー0、未接続0、未接続端0。未接続の比較：0→0。
  - 監査：PASS。回路図と基板は570ノードで一致。
  - パッドの接続の比較（DFM 対応前の基板、今回の修正前の基板）：いずれも0件。
  - 行き止まり0、同じネットで重なる配線0、同じネットで平行に並ぶ線（隙間 0.15mm 未満）0。
  - IC の隣り合うピンの隙間を通る線：0（放熱パッドとの間は除く）。
  - 製造データを出し直した。BOM・CPL は変わらない。

### 訂正（2026-10-01、利用者の指摘）EP 内ビアの指定と、JLC プレビューでの確認

- **EP 内ビアの指定**：これまで「充填（plugged / via-in-pad）」と書いていた。JLC では、「Plugged」はソルダーレジスト（インク）でビアを埋める処理で、両面ともレジストの開口がないビアが対象。via-in-pad 用の処理は「Epoxy Filled & Capped」（樹脂充填＋銅キャップ、POFV）。いずれも JLC の PCB capabilities の記載で確認した。取り違えると、EP のビアにはんだが吸い込まれる。
  - 対象を数え直した（実測）：U1 の EP（pad 101）に9個、U2 の EP（pad 89）に9個、計18個。すべて GND、0.6/0.3mm。ほかのパッドの中にビアはない（全285個）。
  - JLC の記載では POFV の対応径は「via diameters 0.15–0.55mm」。穴径（0.3mm）なら範囲内、外径（0.6mm）と読むと 0.05mm 超える。→ 同日、EP 内の18個を外径 0.5mm に変えた（下記）。
  - `fab/v030wip/README.md` の「発注前に必要なこと」3、上の「残っている作業」2、CLAUDE.md を訂正した。基板と製造データは変えていない。
- **CPL**：補正は EasyEDA のフットプリントとの照合結果で、JLC の実装機がどう解釈するかまでは保証しない。README の「発注前に必要なこと」2に、プレビューで確かめる項目を具体的に書いた。
  - J3 の位置：差し込み口が基板の下端に来て、固定脚が長穴4個に重なること。CPL の y を 1.571mm 内側へ補正している。
  - U1 の1番ピンが左上。U2 の1番ピンが右下（180° 回転して配置しているため）。

### 変更（2026-10-01、利用者の指示）EP 内のビアを外径 0.5mm に

- U1/U2 の EP 内のビア18個（GND）の外径を 0.6mm から 0.5mm に変えた。穴は 0.3mm のまま。`scripts/ep_via05.py`（テキスト編集で size だけ書き換え、再充填と DRC）。
- 理由：JLC の「Epoxy Filled & Capped」の対応範囲「via diameters 0.15–0.55mm」が外径の意味でも、範囲内に入るようにした。
- 検査（実測）：DRC エラー0、未接続0。未接続の比較 0→0。監査 PASS。570ノードで一致。パッドの接続の比較 0件。ドリルは 323 ＋ 2 で基板と一致。製造データを出し直した（BOM・CPL は変わらない）。
- 注意：
  - 外径 0.5／穴 0.3mm はランド幅 0.10mm。JLC の DFM で「Annular ring」の警告が出る可能性がある（EP の中で銅キャップに覆われるため、機能上は問題ない）。
  - ほかのビアは外径 0.55mm が120個、0.6mm が146個。Via Covering が基板全体に効き、かつ上限が外径の意味なら、0.6mm のものが範囲を外れる。発注画面で確認する。

### 修正（2026-10-01、利用者の指摘）配線の角のはみ出し

- C55・C59 から y=80 の 5V 幹線（幅 0.8mm）へ下りる縦線が幅 0.6mm だったため、角で太い幹線の丸い端が縦線の外へはみ出していた。幹線の右端は、C59 の縦線（x=66.95）を 0.5mm 越えて x=67.45 まで延びていた（先には何もない）。
  - 縦線3本（C55/C57/C59）を幹線と同じ 0.8mm にし、幹線の右端を x=66.95 にした。
- 同じ形を基板全体で調べた（`tools/cornerscan.py`：幅の違う線が角で合流する箇所と、どこにもつながらない端が合流点の先へ延びている箇所）。ほかに見つかったものも直した。
  - GND U3.31：線の端がビア (76.9, 42.25) のランドの 0.008mm 外で止まり、銅の重なりだけでつながっていた。ビアの中心から 45° と水平の線にした。
  - GND U1.15：縦線 (x=19.4) が U1.12 の線 (y=41.45) の中心に 0.1mm 届いていなかった。その線まで延ばした。
  - 残り1か所（U2.1 の 1V2：ピン幅に合わせた 0.15mm の引き出しが 0.25mm の線につながる角）は、意図した太さの変化なのでそのままにした。
- スクリプト：`scripts/dfm_corner.py`。
- 検査（実測）：DRC エラー0、未接続0。未接続の比較 0→0。監査 PASS。570ノードで一致。パッドの接続の比較 0件（DFM 対応前・今回の修正前のどちらと比べても）。行き止まり0、短い段差は 14 のまま。製造データを出し直した（BOM・CPL は変わらない）。

### 修正（2026-10-01）JLC DFM（OSP・Epoxy Filled & Capped で発注画面に上げたときの結果）

利用者が JLC の発注画面で DFM チェックを実行した。赤（危険）の項目を基板と照合した（実測）。

| 項目 | 危険 | 内容（基板との照合） | 対応 |
|---|---|---|---|
| Silkscreen to pad | 36 | 0402 の9個（R37–R40、C42、C70–C73）の外形シルク（短い線）がパッドから 0.101mm。9個×線2本×パッド2個＝36で一致 | 直した |
| Silkscreen to hole | 6 | ビアの穴にかかる・近いシルク：U2 の1番ピンの印（ピン1の 1V2 ビアの真上）、J1・U5・R2・C68・C71 の外形線、基板の文字「REV 0.30 2026-09」（JTAG のビア2個の上） | 直した |
| Solder mask opening exposing trace | 1（0.07mm） | ADC_3V3A のビア→C28 の線（dfm_tidy.py で引いたもの）が C27.1 の開口の角から 0.071mm | 直した |
| Pad spacing | 3（0.1mm） | JLC はビアもパッドとして数える。外径 0.6mm のビアと同じネットのパッドが 0.1mm（R15.2、R11、C31.2、Y1、C69.2 の8か所のどれか）。2026-09-30 の DFM 対応で 0.15mm を確保できず 0.10mm にしたもの | そのまま（同じネット。ビアはレジストで覆われ、今回は樹脂充填＋銅キャップなので、はんだのブリッジにならない） |
| Annular ring | 1（0.1mm） | 外径 0.5／穴 0.3mm のビア (17.15, 46.45)（GND）。EP 内の18個は含まれていない | そのまま（JLC の能力表は「外径は穴より 0.1mm 以上大きく」で、0.2mm 大きいので範囲内） |
| Via to pad | 1（0.1mm） | U2.67 の 3V3 ビア（穴と U2.67 の距離 0.114mm。以前から） | そのまま（ビアは樹脂充填＋銅キャップ） |

- `scripts/dfm_tidy4.py`：ADC_3V3A の線を、ビアから真上に上げ、45° で曲げて y=30.0 で C28.1 へ入れた。C27.1 から 0.475mm 離れた。
- `scripts/dfm_silk2.py`（pcbnew。削除はせず、F.Fab への層の移動・短縮・追加だけ）：
  - フットプリントのシルクの線のうち、パッドから 0.16mm 未満、穴（ビア・PTH）から 0.2mm 未満の部分を切り取った。0.15mm 未満しか残らない線は F.Fab へ移した（C42、C70–C73、C68、C71、R2 の線など）。R37–R40 の線は短くして残した。J1 の外形線はビアの部分だけ切った。
  - U2 の1番ピンの印（円）を (55.95, 46.91) から (56.01, 47.46) へ移した（ピン1の右下、ビアから離れた位置）。
  - 基板の文字「REV 0.30  2026-09」を (47.5, 22.0) から (50.4, 27.0) へ移した（JTAG のビアの列を避けた。Y1 の右、「AMIGA 15k」の左）。
- 検査（実測）：
  - DRC エラー0、未接続0。未接続の比較 0→0。監査 PASS。570ノードで一致。パッドの接続の比較 0件。
  - シルクとパッド（開口）の距離 0.15mm 未満：36→0。シルクとビア・穴の重なり：0（最小は部品番号の外接矩形で 0.15mm）。
  - 角のはみ出し0、短い段差 14（変わらず）。
  - 製造データを出し直した（BOM・CPL は変わらない）。
