110-kenichi/A1200LineDoubler/outputs/amiga_scandoubler/revision_0.30wip.md

# revision 0.30wip（作業中の記録）

## 2026-09-28 C34 の孤立を解消（KiCad 7.0.11、クラウドセッション）

**変更内容**
- C34（100nF、0603。U2 の 3V3 パスコン）を (37,30) から (45.4,49.15) へ移した。
  - 向きは 270° で、pad1（3V3）が上、pad2（GND）が下。
- pad1 から U2.67 の既存 3V3 ビア (45.6,47.6) へ、F.Cu 0.25mm の配線を1本引いた。
- pad2 から F.Cu 0.25mm の配線を引き、GND ビア (45.4,50.875)（0.6/0.3）を追加した。
- リファレンスのシルク文字を (43.5,50.3) の横向きに置いた。C30 の文字とは重ならない。
- In1 と In2 のゾーンを KiCad 7 で再充填して保存した。

**配置の決め方**
- `tools/placesearch_c34.py` で候補を探した。
  - 0.05mm 刻みで位置を振り、向き2通りを試した。
  - F/In1/In2/B の各層について、クリアランス 0.2 と穴間隔 0.25 を確認した。
  - U2 左の制御線の予約領域（F: x41.2–45.5 × y42.1–44.1、B: x32–44.6 × y35.8–44.05）は候補から外した。
- その中から、3V3 の接続点が U2.58 の内周ビア (46.05,43) に最も近い案を選んだ。

**検査結果（実測）**
- KiCad 7 DRC のエラー（短絡、クリアランス、穴間隔、配線端・ビアの未接続）：0件。
- 未接続：112件 → 110件。
  - ネット単位の変化は 3V3（14→13）と GND（31→30）だけ（`uncmp.py`）。
- シルク関係の警告件数は変わらない：silk_overlap 26、silk_over_copper 67、text_height 135。
- 電源監査（`audit_sync_in_k7.py`）：電源75件・GND80件の検査がすべて PASS。
  - 残りの FAIL は U2 の再ピン割当によるものだけ（CLAUDE.md の課題5・課題9）。
    - `circuit_manifest.json` の U2 のピンネットの不一致：33件。
    - `sync_out_progress.json` の旧ピン U2.60/61 → R41/R42：2件。

**未検証**
- パスコンとしての効果。C34 は U2.58 から面経由で約4.6mm 離れている。PDN の評価はしていない。

**基板ファイル**
- sha256（先頭16桁）：6c5330aaddf31f70

## 2026-09-28 課題2：U2 左の制御線（本線）

**変更内容**
- I2C_SDA、I2C_SCL、ADC_RESET_N、ADC_PWDN の4本を配線した（U1.75/74/71/70 ↔ U2.57/59/60/61）。
  - 経路：U1 内周ビア → B.Cu → U2 前面ビア。ビアは各ネット2個。
  - x=35 のビア列（GND 36.225、1V9 37.775、GND 39.725）の隙間を2本ずつ通した。
    - 上の帯：SDA 36.8（0.127mm に細めた区間あり）、SCL 37.16。
    - 下の帯：RESET 38.4、PWDN 38.75。
  - その先は 45° の平行線にした。
- ADC_CLK の B.Cu 回廊の終点を (43.95,45.0) のビアへ移し、U2.60/61 の引き出しの通路を空けた。
- U2.64（3V3）を内周ビア (46.04,45.2) で In2 へつないだ。C38 への F.Cu は撤去した（C38 は自前のビアで面に接続）。
- U2.65（GND）のスタブを短くし、EP の角へ入れた（新しい 3V3 ビアとのクリアランス確保のため）。
- U1 側の SDA ビアを (32.2,36.2) から (31.6,36.25) へ移した。元案では SCL の引き出しとのクリアランスが 0.145mm だった。

**検査結果（実測）**
- KiCad 7 DRC のエラー：0件。
- 未接続：110件 → 106件。変化は ADC_PWDN、ADC_RESET_N、I2C_SCL、I2C_SDA の各 -1 だけ（`uncmp.py`）。
- シルク関係の警告件数は変わらない。
- 導通の確認：U1.75–U2.57、U1.74–U2.59、U1.71–U2.60、U1.70–U2.61、U1.28–U2.63（ADC_CLK）すべて導通。
- 電源監査：電源75件・GND80件 PASS。残りの FAIL は前回と同じ（U2 再ピン由来の35件）。
- スクリプト（`ctl3_rm.py` → `ctl3_add.py` → `ctl3_bcu.py`）を前版に適用し、同じ DRC 結果を再現できることを確認した。

**未完了**
- プルアップ／プルダウン R37–R40 は未接続。0603 では空き領域に4本収まらない（探索では2本まで）。判断待ち（CLAUDE.md 課題2を参照）。

**未検証**
- U2.64 のデカップリングは面経由になった（C38 まで約5mm）。PDN の評価はしていない。

## 2026-09-28 課題2：プルアップ／プルダウン R37–R40（0402 化）

**判断**
- 利用者の判断で、R37–R40 を 0603 から 0402（R_0402_1005Metric）へ変更した。定数は変えていない（R37/R38 2.2k、R39/R40 10k）。
- 理由：信号ビアを置ける F.Cu の空きが x 37.2–39.9 に限られ、0603 では4本中2〜3本しか収まらなかった（`tools/pullsearch.py` の探索結果）。

**変更内容**
- 4本を縦置きにし、0.95mm ピッチで並べた：R40 (37.2,37.7)、R39 (38.15,37.85)、R37 (39.1,37.55)、R38 (40.05,37.05)。pad1（信号）が下。
- 信号ビアは各ネットの B.Cu 斜め配線の上に置き、F.Cu の短い配線でパッドとつないだ。
- 面へのビア：
  - 3V3 は R40 用 (37.2,36.2) と R38 用 (40.05,35.75)。R37 は R38 の 3V3 パッド経由でビアを共用。
  - GND は R39 用 (38.35,36.2)。当初案の (38.15,36.2) は REF_27M のビアとのクリアランスが 0.146mm で違反したため移した。
- 参照番号のシルクは 0.5mm の文字で、右側の空き (41.55, 36.0–38.55) に縦一列でまとめた。
- 回路図 `06_support.kicad_sch`（Footprint 欄とインスタンス行）、`amiga_scandoubler.net`、`circuit_manifest.json` のフットプリントを 0402 に更新した。KiCad 7 の `kicad-cli sch export netlist` で読み込めることを確認した。

**検査結果（実測）**
- KiCad 7 DRC のエラー：0件。
- 未接続：106件 → 98件。
  - 変化：3V3 13→10、GND 30→29、ADC_PWDN / ADC_RESET_N / I2C_SCL / I2C_SDA 各 1→0。
- シルク関係の警告：silk_overlap 26→25、silk_over_copper 67→66。
- 導通の確認：
  - 各プルアップの pad1 と、U1・U2 の該当ピン。
  - R37/R38/R40 の pad2 と 3V3（C56）、R39 の pad2 と GND（U2 EP）。
- 電源監査：電源75件・GND80件 PASS。残りの FAIL は前回と同じ（U2 再ピン由来の35件）。
- `scripts/pull0402.py` を前版に適用し、同じ DRC 結果を再現できることを確認した。

**未検証**
- 0402 の実装性（手はんだでの修正のしやすさ）。JLC の 0402 基本部品の在庫と品番は未確認。

## 2026-09-28 課題3：POWER_GOOD（U2.62）

**変更内容**
- U2.62 から F.Cu で内周ビア (46.04,44.45)（0.55/0.3）へ引き出した。
  - 3V3 の内周ビア (46.04,45.2) とは、中心間 0.75mm、銅間 0.2mm。
- B.Cu の経路：(46.04,44.45) → (46.25,44.65) → EP の下を y=44.65 で東へ → (52.7,44.65) → 45°で (59.075,51.025) → x=59.075 を南下 → (59.075,64.6) → 既存ビア (60.175,65.7)。
- 経路は A* ルーターで求めた。F.Cu 3 倍のコスト、ビア 60 とした。y=41 の通路（課題4の DAC_PSAVE_N 用）は塞がないように予約した。

**検査結果（実測）**
- KiCad 7 DRC のエラー：0件。
- 未接続：98件 → 97件。変化は POWER_GOOD 1→0 だけ。
- 導通の確認：U2.62 ↔ U8.8、U9.8、R34.1。
- 電源監査：電源75件・GND80件 PASS。残りの FAIL は前回と同じ。

**注意**
- 新しい B.Cu（y=44.65 の区間、U2 右下からの斜め区間、x=59.075 の縦区間）は、課題5の右辺の引き出しで B.Cu を使うときの障害になる。

## 2026-09-28 課題4：DAC_PSAVE_N（U2.56）

**変更内容**
- U2.56 から F.Cu で内周ビア (46.04,42.1) へ引き出した。3V3 の内周ビア (46.05,43.0) との中心間は 0.9mm。
- U2 → R44 の区間（B.Cu）：
  - (47.14,41.0) から EP の下を y=41 で東へ通した。
  - (52.65,41.0) から 45°で (55.35,38.3) へ上がり、(56.7,36.6) を経て y=36.6 で 1V2 の壁の北端を回り込んだ。
  - (60.55,36.6) から 45°でビア (63.75,39.8) へ下り、F.Cu で R44.1 (64.675,40) に入れた。
  - ビアは R44 のパッド端から 0.2mm 離した（A* の結果はパッドに接していたため）。
- R44 → U3.38 の区間：
  - B.Cu を y=39.85 で (74.95,39.85) まで東へ通し、U3 の本体の下のビア (75.7,39.1) へ入れた。
  - そこから F.Cu で U3.38 (76.25,37.837) に内側から入れた。
- 経路は A* ルーターで求めた（F.Cu のコスト 5、ビアのコスト 60）。ビアは計3個。

**検査結果（実測）**
- KiCad 7 DRC のエラー：0件。
- 未接続：97件 → 95件。変化は DAC_PSAVE_N 2→0 だけ。
- 導通の確認：U2.56 ↔ R44.1 ↔ U3.38。
- 電源監査：電源75件・GND80件 PASS。残りの FAIL は前回と同じ。

**注意（課題6への影響）**
- PSAVE の B.Cu が、U2 と U3 の間の B.Cu を東西に横切る。DAC バスは F.Cu のリバー配線を前提とする。
- R44 は DAC バスの通り道の中央にある。バスの計画時に移動を検討する。

## 2026-09-28 課題5の準備：1V2 の右側リンクを In2 へ、PSAVE を南回りへ

**変更内容**
- 1V2 の右側リンクを移した。
  - 対象：ビア (58,37.225) ↔ (58,45.225) を結ぶ 0.4mm の B.Cu（x 58–58.75、18区間）。
  - 同じ形のまま In2.Cu へ移した（左側で v0.30 に行ったのと同じ手法）。
- DAC_PSAVE_N の U2 → R44 区間を引き直した。
  - 旧経路（y=41 → 北へ → y=36.6 → R44）を撤去した。
  - 新経路：y=42.75 → 45°で (55.7,46) → y=46 を東へ → 北東へ → (63.75,41.7) → 既存ビア (63.75,39.8)。
  - JTAG を B.Cu で北上させる通り道（x 55.4–60）を空けるため。経路は A* で、通り道を予約して求めた。

**検査結果（実測）**
- KiCad 7 DRC のエラー：0件。未接続は95件で変化なし。
- 導通の確認：U2.56 ↔ R44.1 ↔ U3.38、1V2（U2.22 ↔ U2.1 ↔ C31 ↔ C41 ↔ U9.6）。
- 電源監査：電源75件・GND80件 PASS。残りの FAIL は前回と同じ。

## 2026-09-28 課題5：U2 右辺の JTAG 系・設定ピン（4–10番）

**判断**
- 利用者の判断で、U2 右辺の正面にあった C37・C31・R4・R9 を移動した（案1）。

**変更内容**
- U2 右辺のパッドの接続を付け替えた。
  - pin12（3V3）は面ビアへ、pin2（GND）は EP へ、pin1（1V2）はビア経由で In2 の 1V2 へ。
- 1V2 の右側リンクを In2 の x=55.0 に移した。旧リンク（x 58–58.75）は撤去。
- 引き出し：
  - pin4–9 は 0.55mm ステップの階段状ビアで引き出した。
  - pin10 は内側のビアから右辺パッド列の下を通した。
- 経路：7本とも B.Cu で北上し、y=33.5 で 45°で北西へ曲げた。J4 の列位置で F.Cu に上がり、J4 へ入れた。交差はない。
- プルアップ／プルダウン R4–R9 を各線の脇へ移した。C31・C37 は U2 の南東へ移した（横置き、面ビア接続）。
- シルク：基板タイトルを (73.5,25) へ移し、R4–R9 の参照番号を置き直した。

**検査結果（実測）**
- KiCad 7 DRC のエラー：0件。
- 未接続：95件 → 78件。
  - 変化：JTAG_TMS/TCK/TDI 各 2→0、TDO/JTAGSEL/DONE 各 1→0、RECONFIG 2→0、3V3 10→6、GND 29→27。
- シルクの警告：silk_overlap 25→22、silk_over_copper 66→62。
- 導通の確認（24組）：
  - U2.4–10 ↔ J4.3/5/7/9/10 と R4–R9。
  - 1V2：U2.1 ↔ U2.22 ↔ C29/C31/C41/U9。
  - 3V3：U2.12 ↔ C56/C37/R9/R6。
  - GND：U2.2 ↔ EP/C31/C37/R4。
- 電源監査：電源75件・GND80件 PASS。残りの FAIL は前回と同じ。
- スクリプトを前版に適用し、同じ DRC 結果を再現できることを確認した。

**未検証**
- pin12・pin1 のデカップリングが面経由になった影響（C37 まで約 6mm、C31 まで約 2mm）。

## 2026-09-28 v0.31 DAC 再ピン（FPGA のピン割当変更）

**判断**
- 利用者の判断で、U2→U3（DAC）の配線を交差なしにするため、DAC 側のピン割当を先に見直した。

**割当**
- 出力に使える28ピン（3・13–20・25–42・47）を、U3 の周回順に合わせて並べ替えた。
- R0=47、R1–R7=42–36、G0–G7=35–28、BLANK=27、B0/B1=26/25、B2–B7=20–15、H_OUT=14、V_OUT=13、DAC_CLK=3。
- 制約ファイル：`constraints/amiga_board_top_v031dac.cst`（`amiga_board_top.cst` も同内容に更新）。
- 基板：U2 の28パッドのネットを書き換えた（`scripts/padset.py` + `dac_repin_v031.json`）。

**FPGA の検証（実測は nextpnr の値、それ以外は推定）**
- ツール：クラウドに YoWASP 版を導入（yosys 0.69、nextpnr-himbaechel 0.11.1、apycula）。
- 配置配線：1816/2048 とも全クロック PASS。video は 87.94 / 89.50MHz。
- 同じツールで旧割当を再実行（比較用）：video は 85.98 / 80.17MHz。
- verify_phase180：PASS。DAC_CLK の ODDR は X0Y1/IOLOGICAO（pin3）。
- ADC 取り込み（推定）：High 52% 時の残り +4.285ns。
- DAC 出力の抽出遅延（推定、OBUF・基板を除く）：
  - 1816：1.484–3.931ns（旧割当 1.551–3.605）。
  - 2048：1.648–4.248ns（旧割当 1.715–3.374）。
  - 半周期 8.811ns に対し余裕はあるが、合格判定ではない。
- シミュレーション：未実行（RTL は変更なし）。

**基板の検査（実測）**
- KiCad 7 DRC のエラー：0件。未接続は78件で変化なし（DAC 系は未配線のため）。
- 電源監査：電源75件・GND80件 PASS。`circuit_manifest.json` との U2 ピンネットの不一致は 33→57件（課題9で更新する）。

**未対応**
- 回路図 `02_fpga.kicad_sch` のラベル、`fpga_pin_assignment.json`、`board_port_map.json`、`circuit_manifest.json` の更新（課題9）。

## 2026-09-28 課題5の残り：H/V_OUT_RAW・DAC_CLK_RAW（v0.31 ピン）

**方針**
- 課題6の B バスの予定の通り道（下り x 62.2–64.65、U3 の下の東行き y 46.9–50.1）を空けた。
- G/BLANK の入口（x 64.6–69.4、y 37.5–44.9）も空け、その内側を通した。

**変更内容**
- V（pin13）：F.Cu → ビア (61.15,45.6) → B.Cu を南東へ → 既存の V の B.Cu に (70.45,54.25) で合流。
- H（pin14）：F.Cu → ビア (61.85,44.9) → B.Cu を V と平行に → 既存の H の B.Cu に (72.65,51.25) で合流。
- DAC_CLK（pin3）：F.Cu で U6.2 へ（ビアなし）。R43.1 へ分岐。
- 撤去：旧 R41/R42 付近の H/V のスタブとビア（67.3,48.625 / 65.875,49.8）、B.Cu の先頭部分、R41/R42/C37 の旧面ビア。
- 部品の配置：R41 (76.05,54.0)、R42 (78.3,56.05)、R14 (66.3,45.9)、C37 (70.5,57.6)。R41/R42 は `tools/pullsearch.py` で探索した。

**検査結果（実測）**
- KiCad 7 DRC のエラー：0件。
- 未接続：78件 → 73件（H_OUT_RAW / V_OUT_RAW 各 1→0、DAC_CLK_RAW 2→0、GND 27→26）。
- 導通の確認：11組。R43.2 の GND は以前から未接続（課題7）。
- 電源監査：電源75件・GND80件 PASS。
- スクリプトを前版に適用し、同じ DRC 結果を再現できることを確認した。

**未検証**
- DAC_CLK の配線は約 17mm、ビアなし。波形・反射は評価していない。

## 2026-09-28 課題6 手順1：REF_27M を U2 上辺の下から外す

**目的**
- DAC バスの扇形のため、U2 上辺の下と左上角の B.Cu を空ける。

**変更内容**
- 旧経路を撤去した：F.Cu (39.35,34)→ビア (42,34)、B.Cu の斜め線と y=38.3、ビア (54.05,38.8)、内周の F.Cu。
- 新経路：R36.2 → ビア (40.2,34.0) → B.Cu を (40.2,34.6)→(44.9,39.3) の斜め線で進む → 左辺パッド列の下 x=44.9 を南下 → EP の下の y=41（サーマルビア行 40 と 42 の間）を東へ → 内周ビア (53.96,41.9) → F.Cu で U2.11。
- スクリプト：`scripts/d6_ref_rm.py` → `d6_ref_add.py`。

**検査結果（実測）**
- KiCad 7 DRC のエラー：0件。未接続は73件で変化なし。
- 導通の確認：U2.11 ↔ R36.2 ↔ U1.80。
- 電源監査：電源75件・GND80件 PASS。

## 2026-09-28 課題6 手順2・3：U2 上辺の角の電源、DAC バスの扇形配線

**手順2（`scripts/d6_corner_rm.py` → `d6_corner_add.py`）**
- U2 上辺の両角の電源ピンをつなぎ直し、扇形の通り道を空けた。
  - pin43/24/21（GND）：EP の角へ。
  - pin22（1V2）：ビア (55.9,37.55) で In2 の 1V2 の線へ。
  - pin23（3V3）：面ビア (54.2,36.1)。
  - pin44（3V3）：C36 を (44.4,35.0) へ移動。
- R0（pin47）：内周ビア (46.04,38.95) → B.Cu で北へ → ビア (46.04,29.0)。

**手順3（`scripts/d6_fan_rm.py` → `d6_fan_add.py`）**
- DAC バス24本と BLANK を F.Cu で配線した。交差なし。ビアは R0 の2個だけ。
  - 上辺 pin25–42 は北へ上がり、0.36 ピッチの行で東へ進んで各列を下る。
  - 右辺 pin20–15（B2–B7）は東へ進み、列を下る。
  - B は U3 の下を東へ進み、45°で下辺パッドへ入る。G は U3 左辺へ横から入る。R は上辺パッドの真上から下りる。
- DAC_CLK：U3.24 → R24（(72.6,51.6) に移動）→ U6.4。
- 部品の移動：
  - R10 → (75.7,33.8)。
  - R44 → (62.4,36.95)。PSAVE の B.Cu を北へ延ばし、ビア (63.95,37.9) で接続。
  - R14 → (66.9,45.05)、C44 → (66.9,46.55)。
  - C29 → (57.2,36.3)、C35 → (44.4,33.2)、C40 → (44.4,31.3)。
- U3 の電源ピンを本体の下のビアへつなぎ直した：pin1/2 と pin14/15 は GND、pin13 は DAC_3V3（In2 経由）。
- **C42 を 0603 から 0402（C_0402_1005Metric）に変更した。**
  - 0603 では U3 やほかの部品のコートヤードと重なり、置ける場所がなかった。
  - 位置は U3 の右下角 (77.35,48.12)。
  - 回路図 `03_dac.kicad_sch`、`amiga_scandoubler.net`、`circuit_manifest.json` の footprint も更新した。定数 100nF は変えていない。

**検査結果（実測）**
- KiCad 7 DRC のエラー：0件（コートヤードの重なりも0件）。シルク関係の警告は増えていない。
- 未接続：73件 → 44件。
  - DAC_R0–R7、G0–G7、B0–B7：各 1→0。
  - BLANK_N：2→0。CLK と CLK_BUF：各 1→0。
  - GND：26→25。
- 導通の確認：54組（DAC 27本、PSAVE・BLANK のプルアップ／プルダウン、DAC_CLK/BUF、COMP、DAC_3V3、GND、1V2、3V3）。
- 電源監査：電源75件・GND80件 PASS。FAIL は前版と同じ59件。
  - U2 のピンネット57件は課題9。
  - H/V_OUT_RAW の旧経路2件。
- スクリプトを前版（手順1）に順に適用し、同じ DRC 結果を再現できることを確認した。
- DAC バスの長さ（形状からの実測）：29.6–48.9mm。
  - 最大差約 19mm は約 0.12ns に相当する（推定）。

**未評価**
- C29/C35/C40 はピンから離れた（面経由）。
- C42 は COMP ピンから B.Cu で約 9mm（旧配置も同程度）。
- DAC バスのクロストークと波形。

## 2026-09-28 課題7：電源の未接続

**変更内容（`scripts/p7_power.py`）**
- 面につながっていなかったパッド 28個（GND 22、3V3 6）に、F.Cu の短い引き出し（0.25mm、最長約 1.6mm）と面ビア（0.6/0.3）を付けた。
  - ビアは 27個を新設した。C63.2 は既存の GND ビア (21.775,27) につないだ。
  - 位置は `tools/viastub.py` で探索した。条件は次のとおり。
    - パッドから半径 3mm 以内。
    - 全層で他ネットから 0.2mm、穴間隔 0.25mm を空ける。
    - パッドに重ねない。
    - 1個決めるたびに障害物に加え、ビア同士が干渉しないようにした。
  - 結果は `scripts/p7_viastub_plan.json`。
  - 対象：
    - J1/J2（DE-15）の GND ピン 5/6/7/8/10
    - J4 の GND ピン 2/4/6/8 と 3V3 ピン1
    - Y1、C61、C53、U6 の電源と GND
    - C62/C63/C66/C67/C68/C69 の GND、R43.2
- 手で追加したもの：
  - J1.10 は、パッドの東端を回る配線（0.2mm）で J1.5 へつないだ。
  - J2.7/J2.8 は、周りを R_OUT・H_OUT とピン 14/3/2 の配線に囲まれていて、外にビアを置けなかった。**パッドの上にビア（0.55/0.3）を置いた**（(89.65,45.04) と (87.8,42.76)）。
  - ADC_3V3A：C62.1 → FB1 のビア (13,28.412)。C63.1 → C28.1 は A* ルーターの結果（C10 のパッドの間を通る、0.2mm）。
  - ADC_1V9PLL：C66.1 → 既存線 (30.3,29.95)。C67.1 → C26.1。どちらも A* ルーターの結果、0.2mm。
  - DAC_3V3：
    - C68.1 → C47.1 を F.Cu（0.3mm）でつないだ。
    - C69.1 → ビア (74.8,52.5) → In2 で既存の DAC_3V3 線 (74.65,51.05) へ。

**検査結果（実測）**
- KiCad 7 DRC のエラー：0件。警告の件数は前版と同じ（シルク、ライブラリ）。
- 未接続：44件 → 7件。
  - GND 25→0、3V3 6→0、ADC_3V3A 2→0、ADC_1V9PLL 2→0、DAC_3V3 2→0。
  - 残りはアナログ入力 7件（課題8）。
- ゾーン：In1 GND、In2 3V3 とも充填後の島は1つ（分断なし）。
- 電源監査：電源75件・GND80件 PASS。FAIL は前版と同じ59件（課題9の U2 ピンネット57件、H/V_OUT_RAW の旧経路2件）。

**未評価・注意**
- J2.7/J2.8 のパッド上のビアは、はんだの吸い込みを防ぐため充填（plugged）の指定が必要（課題10）。
- パスコンの GND/電源の引き出しは面までの距離が短いものを選んだが、インダクタンスは評価していない。

## 2026-09-29 課題8：アナログ入力7本

**原因**
- U1 左辺 pin 9–11（RIN_3/2/1）と pin 17/18（BIN_2/1）は、パッドの外側を次の配線がふさいでいた。
  - ADC_1V9A の pin7→C14（x=17.1）。
  - ADC_3V3A の pin13/14→C16（x=17.1）。
- 上辺 pin 98/99（GIN_3/SOGIN_2）は、GIN_4（pin96→C8、y=33.3）がふさいでいた。
- 実際に使う入力 RIN_1・BIN_1 も、ここに含まれていた。

**変更内容（`scripts/p8_rm.py` → `p8_add.py` + `p8_routes.json`）**
- 撤去した配線：
  - ADC_1V9A pin7→C14 と ADC_3V3A pin13/14→C16 の F.Cu。C14・C16 は既存のビアと In2 でネットにつながったまま。
  - GIN_4、BIN_3 の旧経路（C7 を囲んでいた）。
  - GIN_1 の B.Cu。
  - ADC_1V9A の B.Cu（(15,41.775)→(13.925,47.5)）→ In2 へ移した。
  - In2 ADC_3V3A の斜め線 → y=42.4 / x=18.05 へ移した。
- RIN 3本：pin 9–11 の西にビア (16.95, 39.75/40.6/41.45) を置き、B.Cu で各コンデンサのビアへ。
- 残りは A* ルーター（router7）で配線した。
  - 順番：GIN_1（BIN の通り道を予約）→ BIN_2 → BIN_1 → BIN_3 → SOGIN_2 → GIN_3 → GIN_4。
  - GIN_4 は U1 内周のビアから B.Cu で C8 へ回した。
- 実際に使う入力の長さ（U1 パッド→結合コンデンサ、形状からの実測）：
  - RIN_1 12.1mm、BIN_1 10.0mm、GIN_1 20.1mm。いずれもビア2個。
- In2 の 3V3 ゾーンの設定を、孤立した島を常に削除する設定に変えた（以前は削除しない設定）。
  - 新しい In2 の線で、どこにもつながらない小さな島が4つできたため。

**検査結果（実測）**
- KiCad 7 DRC のエラー：0件。警告の件数は前版と同じ。
- **未接続：7件 → 0件。**
- 導通の確認：28組。
  - アナログ入力12本の U1↔コンデンサ。
  - ADC_1V9A・ADC_3V3A の U1 ピン↔パスコン（C14・C16 も含む）。
- ゾーン：In1 GND、In2 3V3 とも1つにつながっている。
- 電源監査：電源75件・GND80件 PASS。FAIL は前版と同じ59件（課題9）。

**未評価**
- アナログ入力の配線インピーダンス、クロストーク（GIN_1 は 20mm で、B.Cu が U1 の下を通る）。
- C14（pin7）・C16（pin13/14）のパスコンが、In2 経由の接続になった影響。

## 2026-09-29 課題9：ドキュメントを v0.31 のピン割当に合わせる

**方針**
- 基板の U2 パッドのネット（= `constraints/amiga_board_top.cst`、v031dac 版）を正とした。
- 設計資料をそれに合わせた。スクリプトは `scripts/p9_docs.py`。

**変更したファイル（U2 の57ピン分）**
- `hardware/02_fpga.kicad_sch`：U2 のピンにつながるグローバルラベル57個の名前を変えた。
  - ラベルの位置と UUID は変えていない。
  - ピンの端点→配線→ラベルの対応をたどって特定した。旧名が想定と違う場合は止める検査付き。
- `hardware/amiga_scandoubler.net`：U2 のノード57個を新しいネットへ移した。
- `hardware/circuit_manifest.json`：U2 のピンのネットと、ネットごとのノード一覧。
- `hardware/fpga_pin_assignment.json`：I/O ピンのネット。
- `constraints/board_port_map.json`：各ポートのピン番号と io_name（cst と一致）。
- `hardware/sync_out_progress.json`：H/V_OUT_RAW の U2 側ピンを 60/61 → 14/13 に変えた。

**検査結果（実測）**
- KiCad 7 で回路図からネットリストを書き出し、基板と照合した。全587ノードでネットが一致した。更新した `.net` も同じ結果。
- `board_port_map.json` の全ポートについて、ポートのネットと基板の U2 パッドのネットが一致した。
- cst の全ポート（20種）が `rtl/amiga_board_top.sv` のトップのポートにあることを確認した。RTL は変更していない。
- 監査 `audit_sync_in_k7.py`：**PASS**（既存接続57件、電源75件、GND80件、パッドネット592件）。
  - 前版まで残っていた FAIL 59件（padnet 57件、H/V_OUT_RAW 2件）は解消した。
- 基板は変更していない（DRC は前版のまま、エラー0件、未接続0件）。

**未対応**
- ERC：KiCad 7 の kicad-cli には ERC がないため、実行していない。

## 2026-09-29 配線レビューへの対策（#1・#2）

- 詳細は `review_v030wip_wiring.md` の6章。
- #1：C70・C71（100nF 0402）を追加し、U2 の VCCO（pin12・pin23）のパスコンを 1.5 / 1.1mm に置いた。回路図、ネットリスト、manifest も更新した。
- #2：In2 の ADC_3V3A・ADC_1V9A の線を引き直し、GIN_1 の基準面の切れ目を 4.9→4.5mm にした。
- #3：GND ビアの追加は効果がないため取り消した（GND 面が In1 だけのため）。
- 検査（実測）：
  - DRC エラー0件、未接続0件。
  - 回路図から書き出したネットリストと基板は 591 ノードで一致した。
  - 監査 PASS（`audit_sync_in_k7.py` の部品数・パッド数の期待値を 137/596 に更新）。

## 2026-09-29 REF_27M のビアの近くにパスコンを追加

- C72・C73（100nF 0402）を追加した（`scripts/r4_refdecap.py`、`r4_refdecap_docs.py`、`r4_refdecap_plan.json`）。
- ビアからパスコンまでの距離（実測）：
  - (37.75,35.6)：5.2→1.6mm。
  - (40.2,34.0)：4.3→0.8mm。
  - (30.4,35.6)：U1 の下にあり、6.2mm のまま。
- 検査（実測）：DRC エラー0件、未接続0件。回路図と基板は 595 ノードで一致。監査 PASS（600 パッド）。

## 2026-09-29 課題10：仕上げ（シルク、製造データ、ビットストリーム）

- シルク（`scripts/r10_silk.py`、結果は `r10_silk_result.json`）：
  - 部品番号139個を 0.8mm・線幅0.15mm にそろえた。
  - パッドの開口、シルク線、ほかの文字、基板端を避ける位置へ自動で移動した。
    - 21個は隣の部品のコートヤードの上。
    - 非表示にしたものはない。
  - 基板上の「PARTIAL ANALOG ROUTING - REVIEW ONLY」を「REV 0.30 2026-09」に変えた。
  - U1/U2 の1番ピンの目印をパッドから外した。
  - シルク関係の警告：約220件 → 2件（USB コネクタ J3 の外形が基板端にかかるもの）。
- 製造データ（`fab/v030wip/`、`scripts/r10_fab.py`）：Gerber、ドリル、CPL、JLC 形式の BOM/CPL、プレビュー。詳細は `fab/v030wip/README.md`。
  - ドリルのヒット数と基板は一致した（実測）。
  - LCSC 番号は 132点が未選定。
- ビットストリーム：H_SAMPLES 1816/2048 の2種類を apycula で生成した。**実機では未検証**。
- 検査（実測）：DRC エラー0件、未接続0件。監査 PASS。

## 2026-09-29 部品選定（LCSC）

- JLCPCB の部品検索 API で、在庫・価格・基本部品かどうかを確認しながら選定した（読み取りのみ）。
- 135点の LCSC 番号と型番を、`circuit_manifest.json`、回路図の MPN/LCSC 欄、`amiga_scandoubler.net` に書き込んだ。
- 未確定は4点：U1（在庫4）、J1/J2（在庫0）、Y1（在庫4。置き換え候補あり）。詳細は `fab/v030wip/README.md`。
- 検査（実測）：回路図と基板のネットは 595 ノードで一致。監査 PASS。基板は変更していない。

## 2026-09-29 Y1 の置き換えと、2枚製作に合わせた選定

- Y1：ECS-3225MVLC-270-CN-TR（在庫4）→ YXC OT2EL4C4JI-111OLP-27M（C5203549）。利用者の承認済み。
  - ピン配置、電源電圧、出力形式、3225 のランド寸法が同じであることをデータシートで確認した。
  - フットプリントと配線は変えていない（基板の値表示だけ変更）。
- 選定を2枚分の数量でやり直した。U1 は在庫4で足りる（余裕は小さい）。
- J1/J2 は Global Sourcing で調達する前提で C3146802 を記入した。
  - **変更（同日、利用者の判断）**：J1/J2 は JLC で実装せず、利用者が手はんだで付ける。
    - `fab/v030wip/jlc_bom_dnp_J1J2.csv`（36行）と `jlc_cpl_dnp_J1J2.csv`（137点）を追加した。発注にはこちらを使う。
    - 誤って作った U1/U2 を除く版は削除した。U1/U2 は JLC で実装する。
    - manifest の J1/J2 の notes を更新した。基板と回路図は変更していない。
- 検査（実測）：
  - DRC エラー0件、未接続0件（警告は既知のみ）。
  - 回路図と基板は 595 ノードで一致した。
  - 監査 PASS。
  - Gerber は再出力して比べ、差分がヘッダーの日時だけだったので、前の出力を残した。

## 2026-09-29 J1/J2 をスルーホール品（HOAUC HYC06-HDR15B-060）に置き換え

- 理由：CONEC 33DSMT1-E15SNCT は LCSC の在庫が0で、端子が 0.76mm ピッチの SMD のため手はんだが難しい。利用者の選択で、在庫のある HYC06-HDR15B-060（C711364、在庫2230）にした。3列 DE-15 メスの方針は変えていない。
- 検討して採らなかった候補：BOOMELE VGA-002（C138387）。本体が基板の端から 16mm 入り、J1 側で28点、J2 側で U3 を含む13点と重なる（データシートの寸法で確認）。
- 寸法（データシート）：端子の3列は基板の端から 3.08 / 5.06 / 7.04mm、ピッチ 2.29×1.98mm、穴 φ1.09。固定金具 PTH φ3.2 ×2（25mm 間隔）。本体は基板の端から 8.9mm。旧品のコートヤード（10mm）の内側に収まり、ほかの部品は動かしていない。
- フットプリント：`hardware/Amiga.pretty/DE15_HOAUC_HYC06-HDR15B-060.kicad_mod`（新規）。J1 (5.06, 42, −90°)、J2 (89.94, 42, 90°)。
- ピンの並び：規格どおり（部品面から見て pin1・pin6 が右）。**旧 CONEC 用フットプリントは、この並びと左右が逆に見えた**（pin6 が左端、pin5 が右端）。CONEC のデータシートとは照合していない。今回の置き換えで、旧フットプリントは使わなくなった。
- スクリプト（`work/v030wip/w30/scripts/`）：
  - `jc_rm.py`（テキスト編集）：旧 J1/J2 と、その引き出し配線137本・ビア13個（J2.7/J2.8 のパッド上ビアを含む）を削除。
  - `jc_add.py`（pcbnew）：新フットプリントを配置し、パッドにネットを付ける（未接続ピン 4/9/11/12/15 はネットなし。旧版と同じ）。
  - `jc_route.py`：`tools/router7.py`（A*、今回リポジトリに追加）で10本を配線。結果は `jc_routes.json`。スルーホールなので、始点と終点の層は F/B のうち安い方を選ぶ。
  - `jc_silk.py`：本体の下になった部品番号を置き直した（J1/J2/C49。R15 は置き場所がなく非表示、F.Fab には残る）。
  - `jc_docs.py`：回路図（04_connectors）、ネットリスト、manifest。`jc_sel.py`：部品選定の記録。
- 配線（形状からの実測）：ビア3個（G_IN、B_IN、H_OUT に各1）。旧版の引き出しにはビア13個があった（GND 9（J2.7/J2.8 のパッド上2個を含む）、V_IN 2、H_OUT 2）。GND の端子と固定金具はスルーホールなので、In1 の GND 面に直接つながる。
- 検査（実測）：
  - DRC エラー0件、未接続0件。警告は既知の2件（J3 のシルク）と lib_footprint_issues だけ。
  - 未接続のネット単位比較（`uncmp.py`）：前 0 → 後 0。
  - 監査 `audit_sync_in_k7.py`：PASS（139部品、600パッドのネット）。
  - 回路図から書き出したネットリストと基板：接続のある 570 ノードで一致。
  - ドリル：PTH 323 ＝ ビア285 ＋ PTH パッド38、NPTH 2。基板と一致。
- 製造データを出し直した：Gerber、ドリル、CPL、JLC BOM/CPL、J1/J2 を除いた BOM/CPL、プレビュー、SHA256SUMS。
- 部品代の目安：約 60.3 → 44.6 USD/枚（取得時点の単価）。
- 未評価：
  - 実物のはまり具合（穴径、固定金具、ケースとの位置）。
  - 映像線の長さの変化（J2 側の R/G/B は短くなり、J1 側の H/V は基板の端を回るため長くなった）。

## 2026-09-29 ERC（KiCad 9 CLI、読み取りのみ）

- KiCad 7 の CLI には ERC がないため、KiCad 9.0.9 の CLI を使った（ppa:kicad/kicad-9.0-releases の .deb を展開しただけで、インストールはしていない。KiCad 7.0.11 はそのまま）。回路図はコピーで検査し、KiCad 9 では保存していない。
  - 手順：`work/v030wip/w30/tools/erc_k9.sh`。結果：`hardware/erc_k9.rpt`。
  - 同じ観点の自作検査（ネットリストとピンの種類から）：`tools/erc_net.py` → `hardware/erc_netlist_report.json`。結果は ERC と一致した。
- 結果（実測、728件）：
  - endpoint_off_grid 717件：ピンや配線の端が 1.27mm グリッドに乗っていない（回路図をスクリプトで生成したため）。接続には影響しない。回路図と基板のネットは一致している。
  - power_pin_not_driven 9件：1V2、1V9、3V3、5V、ADC_1V9A、ADC_1V9PLL、ADC_3V3A、DAC_3V3、GND。電源がインダクタやフェライト経由で、PWR_FLAG がないため。
  - pin_to_pin 2件：U3 の IOR_N/IOG_N/IOB_N（反転側の電流出力、Output 型）を3本とも GND につないでいる。回路の意図どおり。
  - ライブラリ不一致（lib_symbol_mismatch）、フットプリントのリンク切れ、未接続ピン、ラベルの不一致は0件。

## 2026-09-29 ERC の対処（利用者の判断）

- PWR_FLAG を追加した（`work/v030wip/w30/scripts/erc_pwrflag.py`、テキスト編集）。
  - 対象は 5V、3V3、1V9、1V2、ADC_3V3A、ADC_1V9A、ADC_1V9PLL、DAC_3V3、GND の9ネット。05_power シートの y=256.54 に並べ、各 PWR_FLAG のピンに同じ名前の global label を置いた。
  - シンボルは KiCad 7.0.11 の power ライブラリの PWR_FLAG と同じ定義（lib_symbol_mismatch なしを確認）。
  - PWR_FLAG は部品表・基板に出ない。回路図から書き出したネットリストのノードは変わっていない（KiCad 7 で確認）。基板は変更していない。
- U3.27/31/33（IOB_N/IOG_N/IOR_N を GND へ）は回路をそのままにし、ERC の除外として記録した：`hardware/erc_exclusions.json`。
  - このフォルダーには回路図に対応する KiCad のプロジェクトファイルがないため、除外は KiCad ではなくこのファイルに記録し、`tools/erc_check.py` で適用する。
  - ADV7125 のデータシートでの確認はできていない（analog.com と LCSC のデータシートの取得が失敗した）。
- ERC（KiCad 9 CLI、`tools/erc_k9.sh`、KiCad 7 の power ライブラリを登録）：720件 → 除外を適用して **残り0件**（実測）。
  - 除外：endpoint_off_grid 717件、pin_to_pin 3件（U3 の反転出力と、他の出力および GND の PWR_FLAG）。
