110-kenichi/A1200LineDoubler/outputs/amiga_scandoubler/analog_review.md

# アナログ信号の部分配線 v0.23

2026-09-21。95×95mm・4層・135部品を維持。v0.22の電源配線に、アナログ信号22組とGND接続17か所を追加した。回路、部品、FPGAロジックは変更していない。**製造用ではなく、配置・引き回し検討用の部分配線版。**

## 配線と確認

入力RGBコネクタから終端抵抗・結合コンデンサまで、DACのCOMP/VREF/RSET、ADCの未使用入力の一部などを配線。R出力はコネクタまで接続できた。G/B出力とADC入力の一部は未完了であり、RGB全体の配線完了ではない。

KiCadの接続情報で、追加信号22組とGND17か所を独立に検査した。前版の57組の電源部接続、75組の電源接続、80か所のGND接続も維持。135部品・592パッドのネット割り当てを確認した。

対象26ネットのうち、全端子の導通確認ができたものは次の15ネット。

PLL_F, PLL_RC, DAC_COMP, DAC_VREF, DAC_RSET, SOGIN_1, BIN_3, GIN_4, SOGIN_3, GIN_2, GIN_1, R_IN, G_IN, B_IN, R_OUT

未完了の11ネットは次のとおり。部分的に配線されているものを含む。

PLL_FILT1, PLL_FILT2, RIN_3, RIN_2, BIN_2, GIN_3, SOGIN_2, RIN_1, BIN_1, G_OUT, B_OUT

未接続件数は217→178。配線区間1,743本、貫通ビア131本。これはラッツネスト件数であり、未完了ネット数や完成率ではない。DRCでは短絡、銅箔間隔、穴周辺・穴同士の間隔、未接続ビア、コートヤード、ソルダーマスクのブリッジなどの検査項目は0件。規則の緩和や除外追加はしていない。

全体DRCは未合格。未接続178件のほか、文字高さ135件、シルクと銅箔の重なり72件、シルク同士の重なり27件、シルクと基板端の間隔2件が残る。

## 配線品質について残る検討

追加信号は幅0.15mm、主に表面、一部裏面。新規ビアは径0.60mm／穴0.30mmで、部品のパッドを避けている。一部はIC本体下にあるため、最終実装条件に合わせてビアのマスク・はんだ処理を確定する必要がある。

障害物を避けた経路候補であり、アナログ性能を保証する配線ではない。PLL_Fのネット全体の銅箔長は約19.85mm、DAC_COMPは約11.69mm、GIN_1は約19.33mm。特にPLLフィルター周辺は近接配置・短い帰路を優先して再検討する。接続済みの経路も固定せず、ADC付近の電源配線と合わせて配置・引き回しを調整する。

In1.CuのGND面が単一領域であることは確認したが、裏面配線の直下は電源配線を含むIn2.Cuである。連続した信号帰路、結合・反射・インピーダンスは未評価。RGB各経路の伝送品質やPLLノイズ、実機動作の合格を意味しない。

`analog_report.json` の銅箔長は、各ネットの全配線区間の合計で、枝分かれを含み、ビアの垂直長を含まない。生成ログの `length_mm` はその接続で生成した主経路のみで、裏面使用時の端子からビアまでの逃げ配線を含まない。信号の遅延値として使わない。

## ファイル

- 現行基板：`hardware/amiga_scandoubler_analog.kicad_pcb` と同名 `.kicad_pro`
- 独立検査：`hardware/analog_report.json`、`hardware/analog_drc.txt`
- 生成記録：`hardware/analog_progress.json`
- 全体図：`analog_review.png/svg`、拡大図：`analog_detail.png`
- 再生成：`hardware/scripts/build_analog.py`、検査：`hardware/scripts/audit_analog.py`

再生成にはKiCad 7付属Pythonと標準フットプリントの環境設定を使用する。生成処理はv0.22のdistribution基板を読み込み、analog基板を上書きする。後から加えた手配線は保持しない。既存のdistribution基板は履歴として維持した。図の赤は表面、青は裏面、橙はIn2.Cu。In1.CuのGND面は図から省略した。

## 次の作業

ADC周辺とPLLフィルターの配置・配線見直し、残るRGB・クロック・デジタル映像・H/V・制御信号の配線。露出パッド放熱、シルク整理、部品調達・実装条件の確認も残る。FPGAのPAL/NTSC入力条件、長短ライン処理、外部タイミング、実機検証は未完了。製造用Gerber・完成BOM/CPL・実機ビットストリームは未生成。
