110-kenichi/A1200LineDoubler/outputs/amiga_scandoubler/output_stage_review.md

# DAC出力段の同期化 v0.19

2026-09-13。RGB24bit、BLANK、H/V同期を同じ映像クロックで確定する27bitの出力段を追加した。従来の表示許可・マスクの組合せ回路がDAC端子まで直接つながる構成を変更した。追加部品、外部メモリは不要。追加遅延は1映像クロック、56.75MHzで約17.62ns。Bob方式とラインメモリ構成は維持する。

## 動作と検証

RGB、BLANK、H/Vをまとめて1段遅延する。無効画素は黒とBLANKにそろえる。電源・PLL・クロック監視が許可を落とすと、映像クロックが止まっていても出力段を非同期クリアする。PSAVEは既存の独立監視経路を維持する。

初期値はRGB/BLANK=0、H/V=1。初期状態でクリアが既に有効で、映像クロックが一度も動かない場合もシミュレーション上の出力を定義する。合成後はDFFC×25、DFFP×2へマッピングされ、Yosysプリミティブの既定INITが一致することを検査した。実機のコンフィギュレーション中の端子状態・GSRは別途確認する。

- RTL単体：異なるRGB値、BLANK、H/Vの対応、クロック間の安定、停止中の消灯と復帰、516件PASS。
- 合成後の単体：同じ516件PASS。使用ライブラリのSHA-256を報告書へ記録。遅延なしの論理試験であり、SDF付きのタイミング試験ではない。
- 全体：12,261回の可視RGB照合、ADC36件設定、入力停止後の別色復帰、電源断、NACK時消灯をPASS。旧版との照合回数の差は出力段追加による可視期間の境界の違いを含む。
- 1816/2048の2条件で再合成・配置配線完了。27本すべてが出力FFからOBUF入力へ直接接続。62信号、RAM6、PLL180度、DACクロックODDRの16番端子配置を検査。

|サンプル数|LUT4|FF|映像領域内Fmax MHz|DAC出力までの抽出最大 ns|
|---:|---:|---:|---:|---:|
|1816|1105|699|81.62|3.555|
|2048|1144|701|82.49|3.315|

DAC側25出力のデータ経路から組合せ回路がなくなり、前版の表示許可を含む約17.7–18.2nsの推定経路は出力端子へのデータ経路ではなくなった。新値はFFのclock-to-Qと配線、出力バッファ入力まで。OBUF、ODDR、基板、負荷の遅延は含まない。比較用15pF/50pF両ケースで端子別の暫定許容区間は空でなくなったが、最終setup/hold合格ではない。

再配置によるADC側も26経路ずつ再計算。ADC High52%で残る暫定予算は両条件とも約4.269nsで、前版と同じ。挿入LUTの欠落モデルとPLL不確かさは残る。

## 再現

現行の実装結果は `implementation/output_stage/`。以前の `phase180/` は出力段追加前の履歴。`board_1816.ys` と `board_2048.ys` が追加RTLを含む合成入力。使用ツールは前版と同じOSS CAD Suite 2026-09-12のYosys/nextpnr。

`commands.txt` の手順で合成・配置配線・検査・解析を実行する。単体試験は `sim/run_output_stage_tests.py`、全体は `sim/run_system_tests.py`。前者は `--gowin-library <Yosysのgowin/cells_sim.v>` 指定時に合成後の単体を試験する。

## 残る確認

表示許可経路は出力FFの非同期クリア側に残る。解除時のrecovery/removal、配線差、最初の有効クロックとPSAVEの順序は最終タイミング検証が必要。出力FF追加だけでこれらを解決済みとはしない。H/Vはデジタル側でRGBとそろえたが、DAC固有の1段パイプラインとアナログ遅延を含む端子での整列も未完了。

基板は95×95mm、未配線。Gerber、製造用BOM/CPL、実機ビットストリームは完成していない。本版はレビュー用。
