110-kenichi/A1200LineDoubler/outputs/amiga_scandoubler/pll_layout_investigation.md

# PLL配置検討 — 未採用

現行基板・配布ZIPはv0.24のまま。C1・C2・R1を移動し、PLL_FILT1、PLL_FILT2、PLL_RC、PLL_Fの全端子を接続する候補を検討した。

既存の電源・アナログ接続と592パッドのネット定義を維持。候補の短絡・銅箔間隔・部品コートヤードの検査は0件となったが、ビアが131→139個に増え、裏面に0.025mmの未接続端警告も1件残った。未接続は178→176件。PLL_Fの総銅箔長は19.85→13.73mmへ減った一方、PLL_FILT1は8.55mm、PLL_FILT2は12.83mm、PLL_RCは5.82mmとなった。銅箔長には枝分かれを含み、ビアの垂直長を含まない。

電気的な接続成立のみを理由に採用しない。PLLノイズ・帰路の品質は未評価。候補は作業領域へ分離し、現行基板には反映していない。

次の検討は、PLL信号のための短い表面経路を先に確保し、その通り道と競合するC25/C26付近の電源・GND配線を局所的に引き直すこと。再検査は変更部分と既存接続維持、DRCに絞る。FPGAの再合成など、今回と関係のない作業は実行していない。
