110-kenichi/A1200LineDoubler/outputs/amiga_scandoubler/pll_top_review.md

# v0.25 PLLフィルターの表面配線

2026-09-26。95×95mm・4層・135部品を維持。現行の部分配線基板は `hardware/amiga_scandoubler_pll_top.kicad_pcb`。**製造用ではない。**

## 変更

C1・C2・R1と近接する電源コンデンサC25・C26を再配置し、競合する電源・GNDの経路を局所的に引き直した。回路・部品値・FPGAは変更していない。

PLL_FILT1、PLL_FILT2、PLL_RC、PLL_Fの全端子を表面だけで接続。信号側にビアを使っていない。ネットごとの総銅箔長はPLL_FILT1が2.956mm、PLL_FILT2が4.158mm、PLL_RCが4.751mm、PLL_Fが13.956mm。PLL_Fは枝分かれを含む合計で、単一の端子間距離ではない。以前のPLL_Fは19.845mmだったが、以前のフィルター全体は未接続であり、総長の単純比較ではない。

ADC_1V9PLLの既存ビアを(26.225,32.0)から(31.0,30.2)mmへ移動し、同電源のビアを(27.8,36.0)mmに1個追加。PLL信号の経路を確保しつつADC電源端子を接続した。ビア径0.60mm／穴0.30mmを維持。ビア数は131→132個。8個増加した前の未採用候補とは別の構成。

## 検査

追加したPLLの4ネット全端子の導通、全配線がF.Cuであること、PLL信号のビアが0個であることを独立に確認。

以前の電源部57組、電源接続75組、GND接続80か所、アナログ接続22組、追加GND17か所を再確認。全592パッドのネット定義も一致した。

短絡、銅箔間隔、穴周辺・穴同士の間隔、コートヤード、未接続ビア・配線端、ソルダーマスクブリッジなどの検査は0件。配線区間1,706本、ビア132個、未接続178→176件。未接続176件とシルク等の問題が残るため、全体DRCは未合格。文字高さ135件、シルクと銅箔70件、シルク同士25件、基板端シルク2件。

## 未検証事項

配置変更したC25/C26は電源につながっているが、デカップリング経路・帰路の品質は再評価が必要。端子からコンデンサまでの導通確認には、共有する電源経路を含む。短い専用接続を保証しない。以前の最長5.384mmという値は変更前の記録で、現行基板には適用できない。そのため報告中の該当項目を履歴値と明示し、再評価フラグを追加した。

PLLのノイズ・ロック品質、電源インピーダンス、温度・実装条件の合格を示すものではない。信号配線・放熱・シルク・部品調達・FPGA/実機検証なども継続して必要。

## ファイルと再現

- 基板：`hardware/amiga_scandoubler_pll_top.kicad_pcb` と同名 `.kicad_pro`
- 検査：`hardware/pll_top_report.json`、`hardware/pll_top_drc.txt`
- 配置・接続記録：`hardware/pll_top_progress.json`
- 配線図：`pll_top_review.png/svg`、`pll_top_detail.png`
- 生成：`hardware/scripts/route_pll_top.py`
- 独立監査：`hardware/scripts/audit_pll_top.py`

KiCad 7付属Pythonと標準フットプリント環境設定を使用する。生成処理はv0.24のrefined基板を入力とし、pll_top基板を上書きする。後から加えた手配線は維持しない。v0.24の基板は履歴として保持した。R34付近の短縮済み電源配線も維持している。以前の `pll_layout_investigation.md` は未採用候補の調査履歴。
