110-kenichi/A1200LineDoubler/outputs/amiga_scandoubler/r34_review.md

# R34付近の電源配線見直し v0.24

2026-09-21。R34付近で大きく回り込んでいた1.9V配線を短縮した。**部分配線のレビュー版であり、製造用ではない。**

## 原因と修正

以前の経路生成はIn2.Cuで接続できるとその経路を採用し、裏面のより短い経路と比較していなかった。R34へ向かう3.3V配線を避けた結果、1.9Vが上方へ大きく迂回していた。間隔検査に合格していても、良好な引き回しとは限らない例だった。

1.9Vの既存ビア（24.725,52.0mm）から（54.55,72.75mm）までの枝を、In2.CuからB.Cuへ変更した。対象枝は85.170mmから38.427mmへ、46.742mm（約55%）短縮。配線幅0.40mmを維持し、ビアの追加や部品移動は行っていない。R34の機能・接続・位置は変更していない。

変更したのは低電圧の電源配線。回路動作、電圧降下・温度・ノイズの実測合格を示すものではない。ほかの自動生成経路も、接続・DRCだけで確定せず、迂回と帰路を見直す必要がある。

## 検査

前版と同じ57組の電源部接続、75組の電源接続、80か所のGND接続、22組のアナログ接続と17か所の追加GND接続を再検査。全592パッドのネット割り当てと95×95mm・4層・135部品を維持した。

短絡、銅箔間隔、穴周辺・穴同士の間隔、未接続ビア、コートヤード、ソルダーマスクブリッジなどは0件。未接続は178件のまま。シルク等の既知の問題も残るため、全体DRCは未合格。配線区間は1,743→1,683本、貫通ビアは131本のまま。

## 現行ファイル

- `hardware/amiga_scandoubler_refined.kicad_pcb` と同名 `.kicad_pro`
- `hardware/refined_report.json` と `hardware/refined_drc.txt`
- 経路の比較数値：`hardware/r34_refinement.json`
- 配線図：`refined_review.png/svg`
- 再生成：`hardware/scripts/refine_r34.py`（v0.23のanalog基板からrefined基板を上書き生成）
- 独立検査：`hardware/scripts/audit_refined.py`

KiCad 7付属Pythonと標準フットプリント環境設定を使用する。v0.23のanalog基板とv0.22のdistribution基板は履歴として保持した。未完了の信号配線、ADC/PLL周辺の再配置、放熱・実装条件、FPGA・実機検証は引き続き必要。
