110-kenichi/A1200LineDoubler/outputs/amiga_scandoubler/rgb_out_review.md

# v0.26 DACのRGB出力接続

2026-09-27。95×95mm・4層・135部品を維持。**部分配線のレビュー版。製造用ではない。**

緑・青のDAC出力から終端抵抗への接続を追加し、R/G/BすべてについてDAC・終端抵抗・出力コネクタ間の導通を確認した。部品・回路・FPGAは変更していない。同期信号やデジタル映像入力などは未配線で、映像が出る基板として完成したわけではない。

## 配線変更

G_OUTとB_OUTは、端子周辺の表面配線と裏面配線を組み合わせた。G_OUTのビアは(76.3625,41.65)と(82.3,44.125)mm、B_OUTは(76.7625,43.25)と(80.3,47.625)mm。

競合するDACのGND配線を引き直し、GND端子33・31・27には、それぞれ(75.3,40.8)、(76.9,42.25)、(76.9,44.0)mmにビアを設け、連続するIn1.CuのGND面への接続を確認した。DAC_COMPの裏面経路も変更した。追加ビアは計7個で、132→139個。今回追加分は径0.55mm／穴0.30mm、名目環状幅0.125mm。既存ビアの寸法は変えていない。最終的なJLCPCBの製造・実装条件への適合は未確定。

各ネットの銅箔長合計はR_OUT 22.006mm、G_OUT 27.001mm、B_OUT 29.276mm、DAC_COMP 11.892mm。枝分かれを含む合計で、ビアの垂直長は含まない。伝送遅延やインピーダンスの測定値ではない。

## 検査

RGB出力3ネットとDAC_COMPの全端子の導通、以前の電源部57組・電源75組・GND80か所・アナログ22組・追加GND17か所の接続維持、全592パッドのネット割り当てを確認した。PLL4ネットの表面接続と信号ビア0個も維持。

短絡、銅箔間隔、穴間隔、コートヤード、未接続ビア・配線端などは0件。従来の未接続・シルク以外のDRC項目が増えていないことも確認した。未接続176→174件、配線区間1,828本、ビア139個。

全体DRCは未合格。未接続174件、文字高さ135件、シルクと銅箔70件、シルク同士25件、基板端シルク2件が残る。

## 残る評価とファイル

裏面信号の帰路・インピーダンス・クロストーク、補償端子と電源のアナログ品質、IC下のビアのマスク・実装条件は未評価。v0.25で変更した電源コンデンサのデカップリング経路も再評価が必要。今回の導通確認は映像品質の合格を意味しない。

現行基板は `hardware/amiga_scandoubler_rgb_out.kicad_pcb` と同名 `.kicad_pro`。検査結果は `hardware/rgb_out_report.json` と `hardware/rgb_out_drc.txt`、配線図は `rgb_out_review.png/svg` と `rgb_out_detail.png`。

KiCad 7付属Pythonと標準フットプリント環境設定で `hardware/scripts/route_rgb_out.py`、`hardware/scripts/audit_rgb_out.py` を実行できる。生成はv0.25のpll_top基板を入力にrgb_out基板を上書きする。後から加えた手配線は維持しない。以前の基板と配布ZIPは履歴として保持した。
