110-kenichi/A1200LineDoubler/outputs/amiga_scandoubler/sync_out_review.md

# v0.27 出力側H/V同期配線

2026-09-27。95×95mm・4層・135部品を維持。**部分配線のレビュー版。製造用ではない。**

## 変更

FPGAからU5入力、U5出力からR22/R23、出力コネクタまで、水平・垂直同期の6ネットを接続した。H_OUT_RAW、V_OUT_RAW、H_OUT_BUF、V_OUT_BUF、H_OUT、V_OUTの全端子の導通を確認。計8組の信号接続を追加した。RAW信号は主に裏面を使用し、FPGAの隣接端子60/61は互いの通り道を塞がない位置へ引き出した。

未配線だったC52を(22.5,58.0)から(84.4,59.0)mmへ移動し、180度向きにした。U5の電源端子からC52までの表面経路は6.405mm。U5とC52の電源接続、R41/R42の3.3Vプルアップ、U5とC52のGND面への接続も確認した。コネクタの実装用余白を避けた配置。

回路・部品値・FPGAロジックは変更していない。以前のRGB出力、PLL表面配線、R34付近の電源短縮も維持した。

## 検査結果

独立したKiCad接続検査で、追加した信号8組、U5/C52/R41/R42の電源4端子、U5/C52のGND2端子を確認。以前の電源部57組、電源75組、GND80か所、アナログ22組、追加GND17か所と全592パッドのネット定義も再確認。

短絡、銅箔間隔、穴間隔、コートヤード、未接続ビア・配線端などは0件。未接続174→160件。配線区間2,062本、ビア152個（前版139個）。今回追加分は径0.55mm／穴0.30mm、名目環状幅0.125mm。

全体DRCは未合格。未接続160件、文字高さ135件、シルクと銅箔70件、シルク同士25件、基板端シルク2件が残る。

## 残る確認

同期信号の導通確認であり、波形・遅延・リンギング・表示品質の合格ではない。裏面信号の帰路、C52の約6.4mmのデカップリング経路、以前のC25/C26の電源経路、ビアと実装条件は最終評価が必要。C52以外の未配線コンデンサも各対象ICとの配置を見直す。

ADC入力、デジタル映像、クロック、入力同期、制御・設定信号などに未配線が残る。FPGAのPAL/NTSC実入力対応と長短ライン処理、外部タイミング、実機検証、完成Gerber/BOM/CPL/ビットストリームは未完了。

## 現行ファイル

- `hardware/amiga_scandoubler_sync_out.kicad_pcb` と同名 `.kicad_pro`
- `hardware/sync_out_report.json`、`hardware/sync_out_drc.txt`
- `hardware/sync_out_progress.json`
- `sync_out_review.png/svg`、`sync_out_detail.png`
- `hardware/scripts/route_sync_out.py`、`hardware/scripts/audit_sync_out.py`

KiCad 7付属Pythonと標準フットプリント環境設定で再生成・検査できる。生成処理はv0.26のrgb_out基板を入力にsync_out基板を上書きする。後から加えた手配線は保持しない。過去の基板・ZIPは履歴として残している。
