110-kenichi/A1200LineDoubler/outputs/amiga_scandoubler/synthesis_review.md

# 映像処理核の合成確認 v0.5

2026-09-10。対象は `video_core` と配下のライン倍化・フィールド同期。ADC取り込み、PLL、初期化制御、I/Oバッファを含む基板全体の合成ではない。

## 結果

YoWASP Yosys 0.69（git 9f75ca1f9 / パッケージ0.69.0.0.post1233）、`synth_gowin` のgw1n向け処理で確認した。合成中の最終 `check` は両条件とも0 problems。専用RAMへの割り当てと論理セルへの変換まで完了した。

| 入力1ラインのサンプル数 | 専用RAM DPX9B | LUT1～4 合計 | ALU | FF 合計 | LUT拡張MUX |
|---|---:|---:|---:|---:|---:|
|1816|6|268|163|257|35|
|2048|6|297|155|258|65|

LUTとALUの配置上の共有関係は未評価であり、表からFPGA全体の使用率を断定しない。RAMは24bit×2ライン。幅・深さを専用RAMの構成に合わせて分割するため、論理上の2バンクが6セルになる。読み出しレジスターをリセットせず、出力の有効信号で初期値と異常時のデータを隠す記述に変更した。read/write collisionを無視する合成オプションは使用していない。

以前の記述では、分岐した読み出しを専用RAMとして認識できず、分散RAMに展開されていた。変更後も、既存の画素単位試験と新しい統合試験が通過した。

## 再現条件と記録

展開したフォルダーを作業ディレクトリーとして、`yosys -l synthesis/video_1816.log synthesis/video_1816.ys` を実行する。2048条件も同様。使用版によってマッピングは変わり得る。入力の誤ったデフォルト値を先に展開しないよう `read_verilog -defer` を指定する。

`.ys` は合成手順、`.json` は合成ネットリスト、`.log` はツール自身のログ。`summary.json` にセル内訳とRTLのSHA-256を記録した。Windows上の実行では標準出力の転送がABC実行箇所で途切れたため、ツールの `-l` によるログと生成ネットリストで完了を確認した。

HS幅4、水平有効範囲6～N−4、垂直有効範囲8～617は検証専用の値。実機用PAL/NTSC設定ではない。`-noiopads` を使っており、仮ピン配置を検証した結果でもない。

## 未確認

Gowin純正ツールとの互換性、GW1N-LV4QN88への配置配線、RAMプリミティブの実デバイスへの配置、クロック制約とタイミング収束、基板I/Oのセットアップ／ホールド、実測遅延は未確認。ネットリストは書き込み用ビットストリームではない。
