110-kenichi/A1200LineDoubler/outputs/amiga_scandoubler/system_synthesis.md

# 統合回路の合成確認 v0.12

2026-09-12。`amiga_logic_core` を対象に、ADC初期設定、I²C、電源シーケンス、PLL再起動管理、クロック監視、ADC入力取得、同期判定、ライン倍化、RGB・HS・VS出力をまとめて合成した。RTLの変更はない。

## 結果

YoWASP Yosys 0.69（0.69.0.0.post1233、git 9f75ca1f9）の `synth_gowin` で両条件の合成が完了し、最終CHECKは0 problems。フレームメモリーの追加は不要だった。

|1ラインのサンプル数|専用RAM DPX9B|LUT1～4|ALU|FF|LUT拡張MUX|
|---:|---:|---:|---:|---:|---:|
|1816|6|832|452|671|161|
|2048|6|806|430|673|135|

GW1N-4の公称資源はLUT4 4,608、FF 3,456、18Kbit BSRAM 10個（Gowin DS100-3.3.3E、Table 1-1、参照済みメーカー資料）。今回のRAM割り当ては6個。論理規模にも余地が見込まれるが、LUT・ALUの物理配置、共有、配線資源をまだ評価していないため、配置後の使用率や実装成功を示す数値ではない。

合成時の唯一の警告は、I²C送信用3バイト配列 `bytes` がレジスターへ展開されるという通知。3バイトをリセットし、送信開始時に並列に更新する記述に対応した変換であり、映像用RAMの展開警告ではない。映像用RAMは両条件とも6個のDPX9Bとして残る。汎用メモリー、未変換演算、ラッチが最終トップに残っていないこともセル種別で照合した。

## 再現と記録

展開した `amiga_scandoubler` を作業フォルダーとして実行する。

```text
yosys -l synthesis/system_1816.log synthesis/system_1816.ys
yosys -l synthesis/system_2048.log synthesis/system_2048.ys
```

YoWASPの場合はコマンド名を `yowasp-yosys` に置き換える。使用したランタイムはyowasp-runtime 1.96、wasmtime 47.0.1。Windowsの標準出力転送がABC実行時に途切れるため、完了は `-l` のログとJSONで確認した。

`system_*.ys` は全入力ファイルとパラメーター、`.log` は合成ログ、`.json` は合成ネットリスト。`system_summary.json` にセル数とRTLのSHA-256を記録した。制御待ち時間はRTLの既定値（27MHz向け）を使用し、シミュレーション用の短縮値には変更していない。

H_SAMPLESだけ1816/2048を切り替え、VS整列31クロック、HS幅4、水平有効範囲6～N−4、垂直有効範囲8～617を指定した。これらは合成比較用で、実機で検証されたPAL/NTSC設定ではない。

## この結果で確定しないこと

`-noiopads` を使用し、物理I/Oと端子制約は対象外。rPLL本体、DACクロック転送、電源投入リセット生成も今回のトップの外側にある。診断ポートも保持しており、最終的な基板トップとはポート数が異なる。

選定パッケージへの配置配線、ADCクロック入力の専用経路、両エッジを使う入力取得のセットアップ／ホールド、PLL位相、CDC、出力タイミングは未確認。合成成功は波形の等価性試験や実機動作試験ではない。既存シミュレーションのRTLとハードウェアはハッシュで変更なしを確認した。

次は基板トップと実PLL・起動リセット・DACクロックを接続し、端子制約を含む実装可否とタイミングを確認する。長短ラインの連続処理と実入力プロファイルも解決が必要。基板は95×95mmの未配線案のままで、Gerber・完成BOM/CPL・ビットストリームはまだない。

## v0.13追記

基板トップ、起動リセット、実PLL・DDR出力の接続候補を追加し、DACクロックの端子を修正した。`board_integration.md` を参照。上記の合成・機能試験は元の機能回路の範囲であり、新しい基板トップの実装確認ではない。
