110-kenichi/A1200LineDoubler/outputs/amiga_scandoubler/clock_integration.md

# クロック監視とDAC停止制御 v0.6

2026-09-11。デジタルシミュレーションと回路接続を確認した開発版。PLL生成・ADC取り込みはまだ含まない。

## 動作と接続

`video_clock_guard` は常時動作する27MHzの `clk_ref` で、約56～64MHzの `clk_video` を監視する。映像側の8bitカウンター最上位ビットを2段同期し、128映像クロックごとの変化を観測する。多bitカウンターを直接渡さない。

既定値は変化間隔40～80基準クロックを許容し、4区間連続で正常になってから許可する。この幅は停止・大幅な周波数異常を見つける粗い判定であり、入力に対する厳密な2倍比率やPLL位相の検証ではない。同期化による±1基準クロック程度の観測差を見込み、実際の約54～62基準クロック/区間から余裕を取った。極端な高速入力のエイリアシング検出も保証しない。

変化が来なければ監視タイマーが許可を取り消す。最後の映像エッジからの停止検出は、同期パイプラインを含め概ね83基準クロック以内（27MHzで約3.1µs）が設計上の上限。実機のメタステーブル解消時間を保証する値ではない。PLL LOCK低下・設定許可低下は監視タイマーを待たずに停止を指示する。

`qualified_ref` は電源が正常で、今回のADC設定が完了したことを示す安定した27MHzドメインの信号にする。`adc_power_sequence.video_allowed` はロック取得に依存するため、ここへ戻して接続しない。`ready_ref` はクロック監視側の準備完了だけを示し、水平・垂直同期の正常判定を含まない。

`reset_video` はクロック停止中にも非同期で立ち、解除は映像クロック3エッジ後に行う。ADC取り込み・同期正規化前段にもこのリセットを適用し、復帰時にライン先頭から処理を始める。`supervised_video_core` はこの監視回路と前版の映像処理核を接続したもの。FPGA出力RGB、BLANK、H/Vをクロック停止中でも停止側に切り替える。

`dac_psave_n` は監視が正常になった時点でHighになり、映像処理のリセット解除まで3映像クロックの先行時間を取る。その間はRGB=0、BLANK=Lowを維持する。クロックが停止したときはLowへ戻す。映像ライン内の通常ブランキングではPSAVEを切り替えない。

## DACに関する重要な違い

ADV7125のRGBとBLANKはCLOCK立ち上がりで取り込まれる。そのため、FPGA側だけでRGBをゼロ・BLANKをLowにしても、DACクロック停止中の出力更新は保証できない。今回、同期入力レジスターのモデルで「停止直前の非ゼロ画素が残る」ことを確認した。これはPSAVEのアナログ動作を検証したモデルではない。

回路図では、以前3.3Vに固定していたDAC U3 pin 38（PSAVE_N）を、FPGA U2 pin 56へ接続した。R44=4.7kをGNDへ追加し、FPGA設定前は省電力側に置く。以前pin 56へ接続していたTVP7002 pin 22（FIDOUT）は未接続にした。Bob処理は各VSフィールド開始を使い、奇偶IDを使わないため、この端子を転用できる。

メーカー資料はPSAVE Lowでの省電力動作と、3.3V時の復帰時間最大10nsを記載する。一方、停止中の出力電圧・過渡波形の保証としては不足するため、実機でPSAVE Low時のRGB電圧、復帰時のスパイク、映像データとの位相を測定する。現段階で「アナログ消画まで検証済み」と扱わない。

出典：[ADI ADV7125 Rev. D、Table 4・Table 7](https://www.analog.com/media/en/technical-documentation/data-sheets/ADV7125.pdf)。ADCデータ取り込みの極性とRGB/HSOUT遅延は別途 [TI TVP7002 SLES206C](https://www.ti.com/lit/ds/symlink/tvp7002.pdf) に従って設計する。

## 検証範囲

`clock_simulation_report.txt` に停止High/Low、LOCKがHighのままの停止、設定許可喪失、速すぎる/遅すぎるクロック、リセット、再取得の結果を記録。単体1,517項目と統合1,284有効画素の照合が通過。実クロック比から生じる位相のずれも試験した。

新規2モジュールの合成・CDC静的検査・配置配線・タイミング解析は未実施。前版の映像処理核の合成結果を、新規監視回路まで含む結果として扱わない。ASYNC_REG属性だけで配置品質を保証せず、リセットのrecovery/removal、同期レジスター間配線、クロック制約を実装ツールで確認する。新規回路による定常時の追加フレーム遅延はないが、停止・復帰時には再取得待ちが生じる。
