110-kenichi/A1200LineDoubler/outputs/amiga_scandoubler/pll_capture.md

# PLL・ADC取り込み構成候補 v0.9

2026-09-11。`gowin_video_pll.sv` と `adc_rgb_capture.sv` を追加した。Gowin純正ツールでの合成・配置配線を済ませたIPではない。

## クロックと入力レジスター

TVP7002の設定候補はCLK_POL=0なので、RGBとHSはDATACLK立ち上がりで更新される。入力レジスターはDATACLK立ち下がりで25bit（RGB24bit＋HS）を一括取得する。続いて、位相関係を固定した2倍クロックへ、データと更新を示す1bitのトークンを同じ2段のレジスターで渡す。

RGB各bitを独立した非同期信号として同期化する回路ではない。ADCクロックと2倍クロックの関係、および取得レジスターから次段までのsetup/holdが成立することが必須。2段にしただけで不適切な位相や配線遅延が救済されるわけではない。

初期化は非同期でリセットを掛け、ADC側は3回の立ち下がりを待って解除する。更新トークンが届くまで `stream_reset` を有効に保つ。その後はsample_ceを1映像クロックおきに出す。クロック停止時の抑止は前版の常時27MHz監視で行う。

## PLL候補

Gowin rPLLの実分周比IDIV=1・FBDIV=2で2倍周波数を作り、CLKOUTPを映像クロックにする。PSDA_SEL=0100は90度、静的DUTYDA_SEL=1000は50%の設定。90度は2倍クロック自身の周期に対する値なので、ADC周期の1/8に相当する。静的なデューティー設定と、位相値との差分で指定する動的な設定を混同しない。

| ADCクロック例 | 2倍クロック | VCO_DIV | VCO周波数 |
|---|---:|---:|---:|
|24MHz|48MHz|16|768MHz|
|28.375MHz|56.75MHz|8|454MHz|
|28.636MHz|57.272MHz|8|458.176MHz|
|32.258MHz|64.516MHz|8|516.128MHz|

GW1N-4 C6/I5の資料にあるVCO範囲400～1000MHzとの計算照合。24MHz入力でVCO_DIV=8にすると384MHzになり範囲外なので、16に変更する。INPUT_MHZ文字列とVCO_DIVは入力プロファイルごとに指定する。入力が自動で任意周波数へ切り替わっても常に成立する設定ではない。

出典：[Gowin Clock UG286-2.0.2E](https://cdn.gowinsemi.com.cn/UG286E.pdf)、手元のメーカー資料GW1N DS100-3.3.3E Table 3-21。取り込み側は [TI TVP7002 SLES206C Figure 1](https://www.ti.com/lit/ds/symlink/tvp7002.pdf) に基づく。

## 実装時に確認するタイミング

28.375MHz・ADCデューティー50%なら、入力取得の立ち下がりから次の位相付き映像クロック立ち上がりまでの理想時間は約4.41ns。デューティー52%では約3.70nsに縮む。ここからFPGA内部clock-to-Q、クロック経路差、配線遅延、setup時間、ジッターを差し引く。したがって、理想波形での試験が通っても実装可能とはまだ判定できない。

ADC pin 28からFPGA pin 63へ入るクロックを、rPLL入力と取得レジスター用クロックの両方へ配れるか、選定デバイスの配置配線で確認する。pin 63がrPLL入力であることだけを根拠に、全てのクロック配線が可能と断定しない。

ADCクロックを基準クロックとして定義し、2倍・90度の生成クロック、ADC入力遅延の最大/最小、クロック不確かさを与えて解析する。このデータ経路へ非同期クロックグループ指定や一括false pathを設定してはいけない。具体的なSDCは、使用するGowinツールでプリミティブのクロック認識と端点名を確認してから作る。

PLLは入力モード変更時、安定した入力クロックを確認してからリセットし直す必要がある。この起動・再起動管理と、基板用トップへの結線はまだ残っている。DACのクロック転送位相と出力setup/holdも別の確認対象。

## 試験結果の意味

`run_capture_tests.py` はPLLを動作させず、試験側で厳密な2倍・90度の理想クロックを生成する。ADC周期約31～41.667nsの4条件、デューティー48/50/52%、データ更新遅延0/1.5nsの計24条件を確認した。各228画素、合計5,472画素についてRGB各byteとHSの整合、連続性、sample_ce周期、リセット・復帰が通過した。

これは取り込み論理の試験。rPLLのメーカーシミュレーションモデルは使っておらず、`gowin_video_pll` の動作、ロック時間、実装配線、メタステーブル現象や実機入力は検証していない。1.5nsはTI資料の特定負荷・試験条件の値であり、基板配線遅延を含む最悪値として扱わない。

## 後段との接続

`video_clock_guard.reset_video` を取り込み回路のresetへ渡し、その `stream_reset` を `stream_input_video.reset` へ渡す。RGB・HS・sample_ceは取り込み出力を接続し、未加工VSは従来どおり同期前段で処理する。取り込み段の追加によってRGB/HS経路の遅延が増えるので、VS_ALIGN_CYCLESを再計算・実測する。前版の試験値31をそのまま完成設定に採用しない。

基板用トップ、PLL再起動、VS位置校正、長短ラインの連続表示、DAC出力タイミング、新規回路を含む合成・配置配線は未完了。

## v0.10 再起動管理の追加

PLLの起動と再試行を `pll_restart_control` に実装し、既存のクロック監視へ接続した。動作と確認範囲は `pll_restart.md` を参照。PLL本体・全体トップの検証とは区別する。

## v0.17更新

現在の検討RTLは180度設定へ変更した。上記の90度に関する説明は旧設定の履歴。再合成・配置・試験と残る制約は `phase180_integration.md` を参照。
