110-kenichi/A1200LineDoubler/outputs/amiga_scandoubler/pll_restart.md

# PLL起動・再起動制御 v0.10

2026-09-12。27MHz側で動く `pll_restart_control` と、既存監視回路へ接続する `clock_recovery_system` を追加した。アナログPLLのロック特性を確認した回路ではなく、制御論理の検証版。

## 動作

ADC設定の完了許可を受けるまでPLLをリセット状態に保つ。ADCクロックで直接動く8bitカウンターの最上位ビットを、27MHz側へ2段同期して監視する。このカウンターはPLLの出力やリセットに依存しない。

128 ADCクロックごとの変化間隔が許容範囲内で、連続する計測値の差が2基準クロック以内の状態を8区間確認してから起動する。続いてPLLリセットを270基準クロック（27MHzで10µs）保持し、解除後にLOCKと映像クロック監視の準備完了を待つ。

LOCKは、リセット保持中または解除後に一度Lowを観測してからHighを受け付ける。最初からHighに固着している場合を、ロック成功として受け付けない。270,000基準クロック（27MHzで10ms）以内に準備完了にならなければ、再度リセットを保持して試行する。ADCクロックが安定している限り再試行する。

動作中のADC停止・大きな周波数変化・LOCK低下・映像クロック監視の準備完了喪失でも再取得する。設定許可が下がると、次の基準クロックを待たずにPLLリセットを有効にする。ADCのI²C通信エラーを自動再試行する処理ではない。

LOCK固着などが解除されても、Lowをまだ観測できなければ次のタイムアウトと再リセットまで待つ場合がある。障害解除からの復帰時間が常に即時になるわけではない。ここでの待ち時間は起動・復帰時間であり、表示中の画素遅延には追加されない。

## 既存監視との接続

`clock_recovery_system` 内では、PLLリセットを解除した時点で `video_clock_guard` の取得を許可する。映像クロック側の準備完了を受けて再起動制御がRUNへ移る。RUNを待ってから監視回路を許可する接続にはしないため、起動の循環待ちを避ける。

実際のPLLはADCクロックから映像クロックを生成し、`pll_reset` をリセット入力に、LOCKを `pll_lock` に接続する。ADC取り込みと同期前段には、従来どおり `reset_video` と取り込み回路の `stream_reset` を順に渡す。DAC PSAVEと出力許可はクロック監視の出力を使う。

この接続試験では、監視回路は実際のRTLを使用した。PLLのクロック生成とLOCKは試験用の理想クロック・応答モデルで置き換えている。メーカーのrPLL模型を動かした試験ではない。

## 診断と範囲

`fault_history[0]` はRUN中のADCクロック不安定、bit 1はRUN中のLOCKまたは映像クロック監視異常、bit 2はロック待ちタイムアウト。履歴は全体リセットまで残るが、再取得の成功を妨げない。

既定の観測間隔80～170基準クロックは粗い停止・安定性判定である。PLLのVCO範囲や入力モードの適合を保証しない。小さな周波数変化は許容され、PAL/NTSCの切替検出器にはならない。プロファイル変更時は設定・PLLを明示的に再起動する必要がある。極端に速いクロックのエイリアシング検出や、位相ジッターの計測も行わない。

## 検証

- 単体：ADC停止、周波数の段階変化、映像クロック異常、LOCK未成立、LOCK High固着、設定許可低下、リセットと各復帰。
- 短縮時間に加え、RESET保持270・タイムアウト270,000サイクルでも同じ復帰試験を実施。
- 監視回路との接続：初期起動、ADCだけの停止、映像クロックだけの停止、ロックタイムアウト、設定許可の取り直し。

上記3条件が通過。記録は `pll_restart_simulation_report.txt`。試験用の基準周期は37nsで、27MHzの厳密な周期ではないため、時間はサイクル数で確認した。連続安定確認は試験では3区間に短縮している。

新規回路の合成、CDC静的検査、配置配線、rPLL実動作、全体トップでの起動、実機のPAL/NTSC切替は未確認。
