110-kenichi/A1200LineDoubler/outputs/amiga_scandoubler/revision_0.10.md

# v0.10 PLL起動・再起動管理

2026-09-12 / 開発版・製造用ではありません。

ADCの設定完了とクロックの安定を待ち、PLLのリセット保持・ロック待ち・失敗時の再試行を行う回路を追加した。以前作成した映像クロック監視と接続し、互いの準備完了を待って起動できなくなる循環がないことを試験した。

単体の短縮時間条件と実用サイクル数条件、監視接続の計3条件が通過。CLOCK停止、周波数変化、LOCK固着・タイムアウト、設定許可喪失と復帰を含む。PLL本体のメーカー模型や実デバイスを用いた検証ではない。

追加ファイルは `pll_restart_control.sv`、`clock_recovery_system.sv`、試験、`pll_restart.md`。既存RTLと基板データは変更していない。基板案は95×95mm・135部品・129ネット、未配線。

全体トップへの統合、レジスター読み戻し、VS位置の校正、長短ラインの連続表示、DACクロック転送、FPGA実装の成立確認が残る。その後に部品確定・基板配線・Gerber・製造BOM・CPLの作成、実機試験を進める。
