110-kenichi/A1200LineDoubler/outputs/amiga_scandoubler/revision_0.12.md

# v0.12 統合回路の合成確認

ADC初期設定から映像出力までを含む `amiga_logic_core` を、1816/2048サンプル条件でGowin向けに合成した。両方とも検査エラー0、専用RAM6個。詳細と限界は `system_synthesis.md`、再現手順・ネットリスト・ログ・セル集計は `synthesis/system_*` を参照。

RTL、回路図、配置基板はv0.11から変更していない。新しいハードウェア動作保証や製造承認を意味しない。95×95mm・135部品・129ネットの基板は未配線で、製造用データは未完成。
