110-kenichi/A1200LineDoubler/outputs/amiga_scandoubler/revision_0.13.md

# v0.13 基板接続案と端子修正

DACクロックの旧端子57はGW1N-4でIO logic非対応だったため、16へ移動し、ADC_PWDNを57へ移した。回路図、ネットリスト、配置基板、PDF、端子表を更新した。

基板用トップ、起動リセット候補、62信号のCSTと対応表を追加。接続検査25項目、基板592パッドの照合、起動条件の試験が通過。詳細・試験限界は `board_integration.md` を参照。

既存の機能RTLは変更していない。95×95mm・135部品・129ネットの未配線基板。専用ツールによる基板トップの合成・配置配線・タイミング確認、製造データと実機検証は未完了。
