110-kenichi/A1200LineDoubler/outputs/amiga_scandoubler/revision_0.14.md

# v0.14 基板用トップの合成確認

PLL・ODDR・I/Oバッファを含む合成が1816/2048条件で完了。合成後のI²C・クロック・リセット配線を照合し、リセット長2/32/65の合成後回路試験を通過した。詳細は `board_synthesis.md`。

RTLと基板はv0.13から変更なし。物理配置・タイミング・基板配線・製造データは未完了。
