110-kenichi/A1200LineDoubler/outputs/amiga_scandoubler/revision_0.2.md

# v0.2 回路図作成の記録

2026-09-09。製造前の検討版。

## 今回の成果

6機能シートからなる編集可能なKiCad回路図を作成した。ADC、FPGA、DAC、VGA入出力、USB・電源、発振器・電源フィルター・起動時抵抗を含む。部品は134点、名前付き接続は129本。回路図はローカルの専用シンボルを内包する。

FPGA候補をGW1N-LV4QN88C6/I5に絞り、メーカーのQN88端子表に基づいて全端子を割り当てた。ADCのRGB各10bitから上位8bitを取り出す。ピン表上のR信号に電源端子が挟まる箇所も反映した。端子割り当ては合成・配置配線で未検証であり、確定ではない。

入出力のDE-15メスはCONEC 33DSMT1-E15SNCTを候補とした。信号端子はSMT、機械固定部は別途処理が必要。専用フットプリントの寸法確認とJLCPCBでの調達・固定脚実装の確認を残す。

UNBUFFEREDアダプターのH/V入力はSN74LVC2G17を3.3Vで使用する構成。RGBは75Ω終端とAC結合。入力9番ピンは未接続で、基板側のUSB電源に接続しない。既存ケーブルについては標準VGAのRGB/H/V接続を前提とする。

電源はTPS62160を3個使用する案とし、3.3V、1.9V、1.2Vを生成する。3.3VのPGでFPGAコア用1.2VのENを制御する。電源の部品定格、実消費電流、USB入力容量・突入電流の確認は残る。現在の案はUSB充電用5V電源を想定し、PCのUSB-Aポートとの列挙を実装していない。

DACのCOMPコンデンサーをVAAへ、PLLフィルターをTVP7002のPLL_Fへ接続した。DAC電流設定抵抗は536Ω、出力の並列終端は75Ω。LCD側75Ωとの並列負荷で約0.69Vを狙う案で、実測値ではない。

## 検査結果

KiCad 7.0.6による読み込み、PDF出力、ネットリスト出力が成功した。PDFは全7ページを描画して確認し、コンデンサーの表示間隔と図枠への重なりを修正した。

KiCadのXMLネットリストを用いた検査では、134部品・129接続が定義と一致した。これに加えてADC/DACのRGB端子、FPGAの電源・GND・PLL入力、VGA端子、DACのCOMP接続、電源シーケンスの接続を照合し、20項目が合格した。

これは接続の検査であり、電気的な設計承認ではない。電源出力を含むシンボルの電気属性を整理したERC、フットプリント検査、DRCは未完了。前版のRTLテスト結果は同梱するが、今回はRTLを変更していない。

## 製造データまでの残作業

1. USBコネクター、発振器、受動部品の具体的注文型番・定格を選定し、JLCPCBの調達番号を確定する。
2. QN88、TVP7002の放熱パッド、DE-15の固定脚を含む全フットプリントを図面と照合する。
3. ADCのI²C初期化、クロック生成、同期正規化、有効画面範囲、DAC出力をRTLへ統合し、FPGAのメモリ使用量とタイミングを確認する。
4. 電源・起動・USB給電条件を確定し、ERCを実行する。
5. 基板配置・配線とDRCを完了し、実基板からGerber・ドリル・BOM・CPLを出力する。
6. 製造ファイル、部品の向き、配置座標を相互照合する。試作後にAmigaとGW2780で映像・同期・遅延・発熱を測定する。

現在は部品表の元データをJSONで保持している。未確定型番を含むため完成BOMとして出力していない。基板が未配置のためCPLは存在しない。
