110-kenichi/A1200LineDoubler/outputs/amiga_scandoubler/revision_0.21.md

# v0.21 電源部を部分配線

95×95mm、135部品を維持。USB入口・3系統の電源局所配線・起動制御を追加。57組の電源接続、6組のGND帰路、592パッド割り当てを確認。未接続365件とシルクの問題は残る。詳細は `power_routing_review.md`。製造用ではない。
