110-kenichi/A1200LineDoubler/outputs/amiga_scandoubler/revision_0.22.md

# v0.22 主要ICへの電源分配

ADC・FPGA・DACの電源端子とコンデンサ30組を配線。75組の電源接続と80か所のGND接続を確認。未接続は217件。主要IC周辺の配線図とKiCad基板を追加。詳細は `distribution_review.md`。製造用ではない。
