110-kenichi/A1200LineDoubler/outputs/amiga_scandoubler/revision_0.23.md

# v0.23 アナログ信号の部分配線

信号22組・GND17か所を追加。未接続217→178件。95×95mmを維持。アナログ経路の最終品質は未評価で、PLLフィルターとADC周辺は配置見直しが残る。詳細は `analog_review.md`。製造用ではない。
