110-kenichi/A1200LineDoubler/outputs/amiga_scandoubler/revision_0.24.md

# v0.24 R34付近の迂回配線修正

1.9V電源の一枝を裏面へ変更し、85.2→38.4mmへ短縮。配線幅0.4mm、ビア数131、未接続178を維持。詳細は `r34_review.md`。製造用ではない。
