110-kenichi/A1200LineDoubler/outputs/amiga_scandoubler/revision_0.26.md

# v0.26 DACのRGB出力接続

緑・青を追加しRGB3色のDACから出力コネクタまでの導通を確認。GND・COMP経路も調整。未接続174件、ビア139個。詳細は `rgb_out_review.md`。製造用ではない。
