110-kenichi/A1200LineDoubler/outputs/amiga_scandoubler/revision_0.27.md

# v0.27 出力側H/V同期配線

出力同期6ネット・8組を接続。U5/C52とプルアップの電源・GNDも接続。未接続160件。詳細は `sync_out_review.md`。製造用ではない。
