110-kenichi/A1200LineDoubler/outputs/amiga_scandoubler/revision_0.4.md

# v0.4：95×95mmの配置検討

2026-09-10。未配線の配置検討版。

## 基板サイズと配置

100×100mm以内を目標に、95×95mmの外形で全134部品を配置した。VGA入力を左、ADC・FPGA・DACを中央に横並び、VGA出力を右に置く。USB電源を下辺、3系統の電源回路を下側に配置した。部品の配置面は表面で、銅箔層数は4層の候補として設定した。

95×95mmは基板材料の外形。コネクター先端とケーブルの張り出しは含まない。DE-15の本体表示は余裕をみた仮の占有範囲で、メーカーの3Dモデルではない。端面・固定脚の位置はさらに確認する。

電源入力・出力コンデンサーとインダクターを電源ICの近くに置き、ADC・FPGAの電源コンデンサーは対応する電源端子を基準に配置した。現在の位置は配線前の出発点であり、電源ループやクロック・映像信号を配線しながら修正する。

## 今回の部品更新

- USBコネクター候補をHRO TYPE-C-31-M-12（C165948）とし、KiCadの対応フットプリントを割り当てた。シェル端子名をフットプリントと一致するS1へ変更した。データ端子は未接続のまま。
- 27MHz発振器候補をECS-3225MVLC-270-CN-TRとし、メーカー推奨のランド寸法で専用フットプリントを作成した。JLCPCBの調達番号は未確定。
- 電源用インダクターをTDK VLS4012CX-2R2M-1（C7413169）の候補に更新した。4×4mm、2.2µHの部品。メーカーの推奨ランドに基づくフットプリントを追加した。
- DE-15の信号パッドと固定・位置決め穴を持つ仮フットプリントを作成した。固定脚の実装工程と本体の基板端位置は未確定。
- 4.7µF、10µF、22µFの電源コンデンサーには0805の配置領域を確保した。具体的な注文型番とDCバイアスによる実効容量の確認は残る。

## 検査

保存したKiCad基板を再読込し、全134部品の存在と590個のパッドの接続名を回路定義に照合した。不一致は0件。USBの重複した電源・GNDパッドと複数のシェルパッドも検査対象に含む。

部品の外形・ランドを囲む矩形同士の重なりは0件。これは配置の粗い検査であり、配線クリアランス、シルク文字、はんだ付け、差し込み・ねじ締め作業の検査に代わるものではない。

回路図からKiCadが出力したネットリストも再照合し、134部品・129接続の一致を確認した。RTLは前版から変更していない。

## 未完了

基板上の配線数は0本。GND・電源の銅箔面、サーマルビア、配線後のDRCは未完了。FPGAへの合成・配置配線と映像処理全体の統合も残る。全注文型番の確定、JLCPCBの実装条件確認後に、最終基板からGerber・BOM・CPLを生成する。

現段階では「95×95mmに部品を置けた」ことまで確認している。このサイズで配線・動作が成立したとはまだ判断していない。必要なら100×100mmまで広げるか、それ以上のサイズを再検討する。

参照：

- [HRO TYPE-C-31-M-12のメーカー図面](https://datasheet.lcsc.com/datasheet/pdf/9e56b777c022540fcce7c7f67825f55e.pdf?productCode=C165948)
- [ECS-3225MVLCのメーカー資料](https://ecsxtal.com/store/pdf/ECS-3225MVLC.pdf)
- [TDK VLS4012CX-2R2M-1の寸法・仕様](https://product.tdk.com/en/search/inductor/inductor/smd/info?part_no=VLS4012CX-2R2M-1)
