110-kenichi/A1200LineDoubler/outputs/amiga_scandoubler/revision_0.6.md

# v0.6 クロック停止監視・DAC省電力制御

2026-09-11 / 開発版・製造用ではありません。

映像クロックが止まると映像処理そのものも動けなくなるため、常時動く27MHz側でクロックを監視する処理を追加した。停止時のリセットとFPGA出力抑止、復帰時の同期したリセット解除を映像処理核へ接続した。

DACのBLANKはクロック同期入力なので、停止中のアナログ出力対策としてPSAVE端子を制御する回路に変更した。Bobで不要な奇偶ID入力を省き、FPGA pin 56を転用。抵抗R44を1個追加した。フレームメモリーや追加ICは増やしていない。

基板案は95×95mm、135部品、129ネット。未配線のまま。回路図・ネットリスト・端子表・配置図を更新し、23項目の接続照合と592パッドの接続確認が通過。部品外形の重なり検査も通過した。ERC/DRCの合格ではない。

新規デジタル試験は通過したが、PLL・ADC取り込みの実装、監視回路を含む合成とタイミング確認、PSAVEによるアナログ停止動作の実測が残る。詳細は `clock_integration.md`。

v0.5の映像処理RTLは変更しておらず、その単体・統合・合成記録は前版の記録を引き継ぐ。新規回路の合成を試みたが、以前使用したYoWASP実行環境を読み込めず、新しい合成結果は得ていない。

次の作業はADC設定・PLL・取り込み位相・同期判定の統合。その後に製品用FPGA実装確認、部品確定、基板配線と製造データ生成を行う。Gerber、製造BOM/CPL、ビットストリームはまだ含まれない。
