110-kenichi/A1200LineDoubler/outputs/amiga_scandoubler/revision_0.15.md

# v0.15 FPGA配置配線の試行

選定FPGAとCSTを指定し、1816/2048サンプル条件で配置配線が完了した。実装結果・ログ・周期指定の修正と検証限界は `implementation_review.md`。

RTLとプリント基板は変更なし。FPGA内部配線の結果であり、95×95mmのプリント基板は未配線。タイミングの最終承認と製造データ作成は未完了。
