110-kenichi/A1200LineDoubler/outputs/amiga_scandoubler/revision_0.16.md

# v0.16 クロック間受け渡しの調査

配置後SDFから計52経路を抽出した。現行90度設定は2048サンプル・High 52%条件で余裕不足の懸念がある。挿入LUTのSDF遅延欠落も見つかり、完成タイミング判定は保留。

180度候補の理想クロック試験を追加し、90度と合わせ48条件・10,944画素を確認した。製品側RTLと基板は変更なし。詳細は `capture_timing_review.md`。
