110-kenichi/A1200LineDoubler/outputs/amiga_scandoubler/revision_0.17.md

# v0.17 PLL位相を180度へ更新

PLL位相設定、取り込み側コメント、試験側位相を更新し、全体試験・合成・配置配線・暫定遅延解析を再実行した。`phase180_integration.md` が最新結果。180度の実装データは `implementation/phase180/`。

理想時間不足の懸念は暫定計算上改善したが、欠落遅延モデル・PLL実位相・入出力setup/holdの最終確認は未完了。基板は変更なし・未配線。
