110-kenichi/A1200LineDoubler/outputs/amiga_scandoubler/revision_0.18.md

# v0.18 DAC出力タイミング調査

2プロファイル各25出力を追跡。RGB画素経路と表示許可経路を区別し、端子別setup/hold条件、欠落モデルを記録した。詳細は `dac_timing_review.md`。回路・RTL変更なし。製造用ではない。
