110-kenichi/A1200LineDoubler/outputs/amiga_scandoubler/revision_0.25.md

# v0.25 PLL表面配線

PLL4ネットを表面で接続、信号ビア0個。電源ビア1個追加。未接続176件。変更した電源コンデンサの経路品質は再評価が必要。詳細は `pll_top_review.md`。製造用ではない。
