110-kenichi/A1200LineDoubler/outputs/amiga_scandoubler/revision_0.5.md

# v0.5 映像処理の統合・専用RAM合成確認

2026-09-10 / 開発途中・製造用リリースではありません。

## 今回の変更

- ライン倍化とフィールド同期を `video_core` に接続し、RGB、HS、VS、有効映像範囲を同じ画素位置に揃えた。
- 同期処理の登録出力に合わせてフィールド開始信号を遅延させ、RGBに2クロックの整列段を追加した。フレーム保存は追加していない。
- フィールド信号だけが消えた場合は垂直カウンターを上限で止め、周回して古い表示範囲を再表示することを防いだ。
- ラインRAMの読み出し記述を変更し、Gowin向け合成で専用RAM 6セルへの割り当てを確認した。

## 検証

既存のライン倍化試験は32・1816・1820・2048サンプルの全条件で通過（合計125,752サンプル）。フィールド同期も524・525・624・625・626ラインの全条件で通過。

統合試験は出力時刻から独立に期待値を計算し、RGB・HS・VS・画素位置・フレーム開始を7,367,444回照合した。全6条件で通過。半ライン位相を含むフィールド開始、水平同期消失時の消画、リセット後の復帰、フィールド信号消失時のカウンター飽和を確認した。大きいライン長での統合試験は1816/625条件。2048条件は単体試験と合成で確認した。

合成結果は `synthesis_review.md` を参照。既存の制御回路・基板は変更していない。制御系の試験結果と回路・配置の確認結果は前版のものを同梱。

## 基板と残作業

配置案は引き続き95×95mm、134部品、未配線。今回の変更は映像処理と合成検証に限る。

次に必要なのはADC設定・取り込み位相・PLL・実入力の同期判定を接続した基板用トップ回路と、そのタイミング検証。続いて部品調達と実装寸法の残確認、基板配線、ERC/DRC、製造BOM/CPL/Gerber生成を行う。実機での映像・起動・消費電力の確認も残る。

この版の資料や合成ネットリストを、JLCPCB発注用データまたはFPGA書き込みデータとして使用しないこと。
