110-kenichi/A1200LineDoubler/outputs/amiga_scandoubler/revision_0.9.md

# v0.9 PLLとADC取り込みの構成候補

2026-09-11 / 開発版・製造用ではありません。

Gowin rPLLで2倍・90度のクロックを作る設定候補と、ADC立ち下がりでRGB/HSをまとめて取得する回路を追加した。更新トークンでサンプル有効周期を作り、初期化中は後段をリセットする。

理想クロックを使う取り込み試験24条件が通過し、5,472画素のRGB/HS整合と周期を照合した。PLLそのもののメーカー模型による試験、合成・配置配線・実機確認はまだ行っていない。詳細は `pll_capture.md`。

今回の追加は `rtl/gowin_video_pll.sv`、`rtl/adc_rgb_capture.sv`、試験と説明資料。既存RTL、回路、未配線の配置基板は変更していない。基板案は95×95mm、135部品、129ネットを維持。

次に必要なのは基板用トップ回路への接続と、PLL再起動管理・VS位置の校正・長短ラインへの対応。FPGA実装の成立確認、部品確定と基板配線、その後のGerber・製造BOM・CPL生成も残る。
