110-kenichi/A1200LineDoubler/outputs/amiga_scandoubler/analog_detail.png

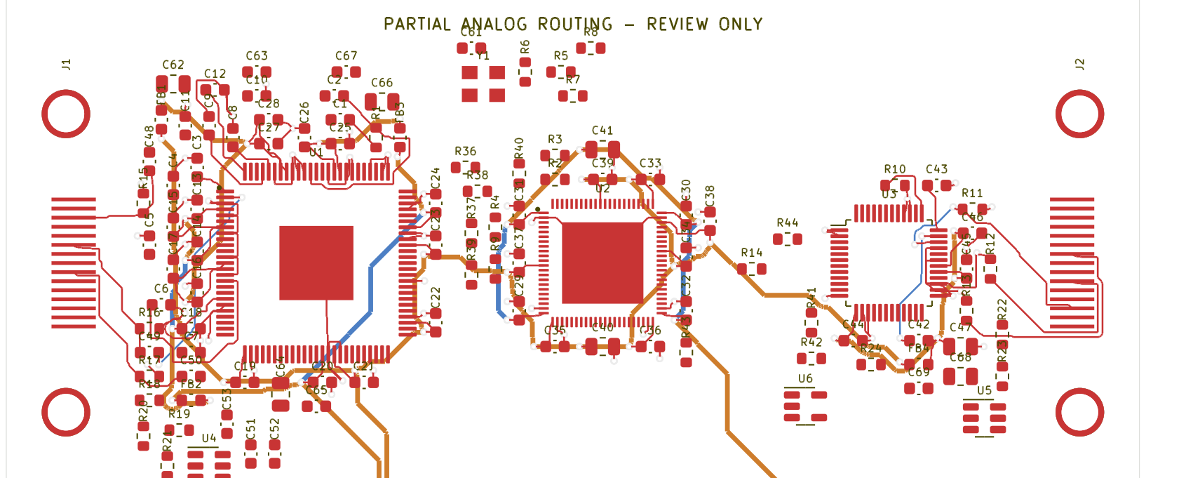
outputs/amiga_scandoubler/analog_detail.png
