110-kenichi/A1200LineDoubler/outputs/amiga_scandoubler/analog_review.png

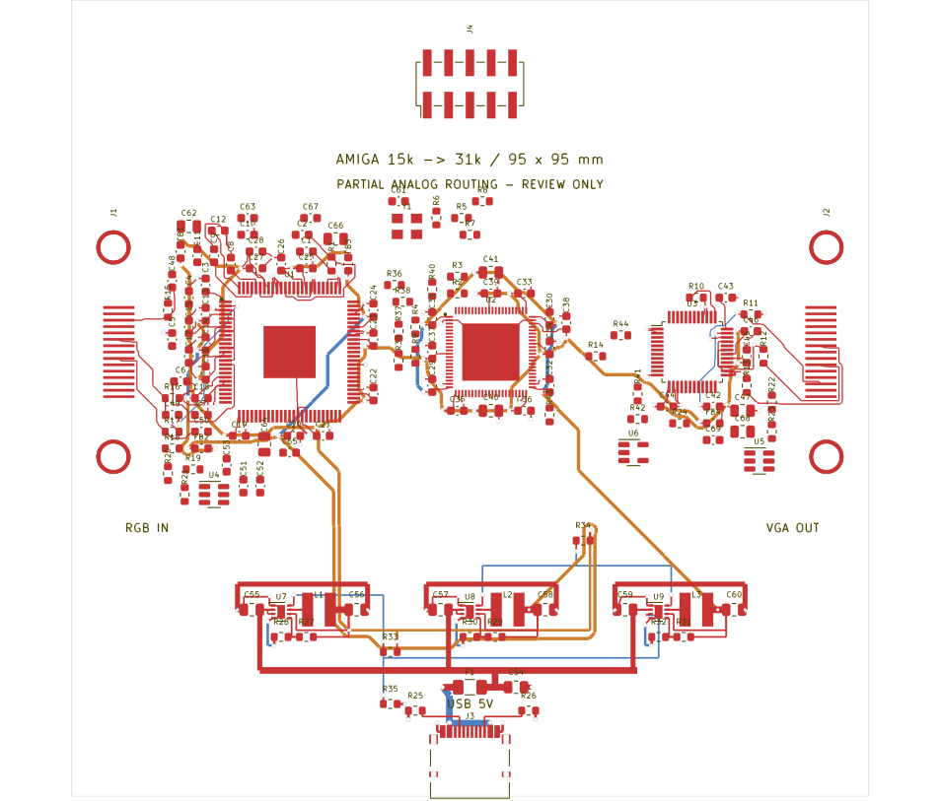
outputs/amiga_scandoubler/analog_review.png
