110-kenichi/A1200LineDoubler/outputs/amiga_scandoubler/fab/v030wip/preview_top.png

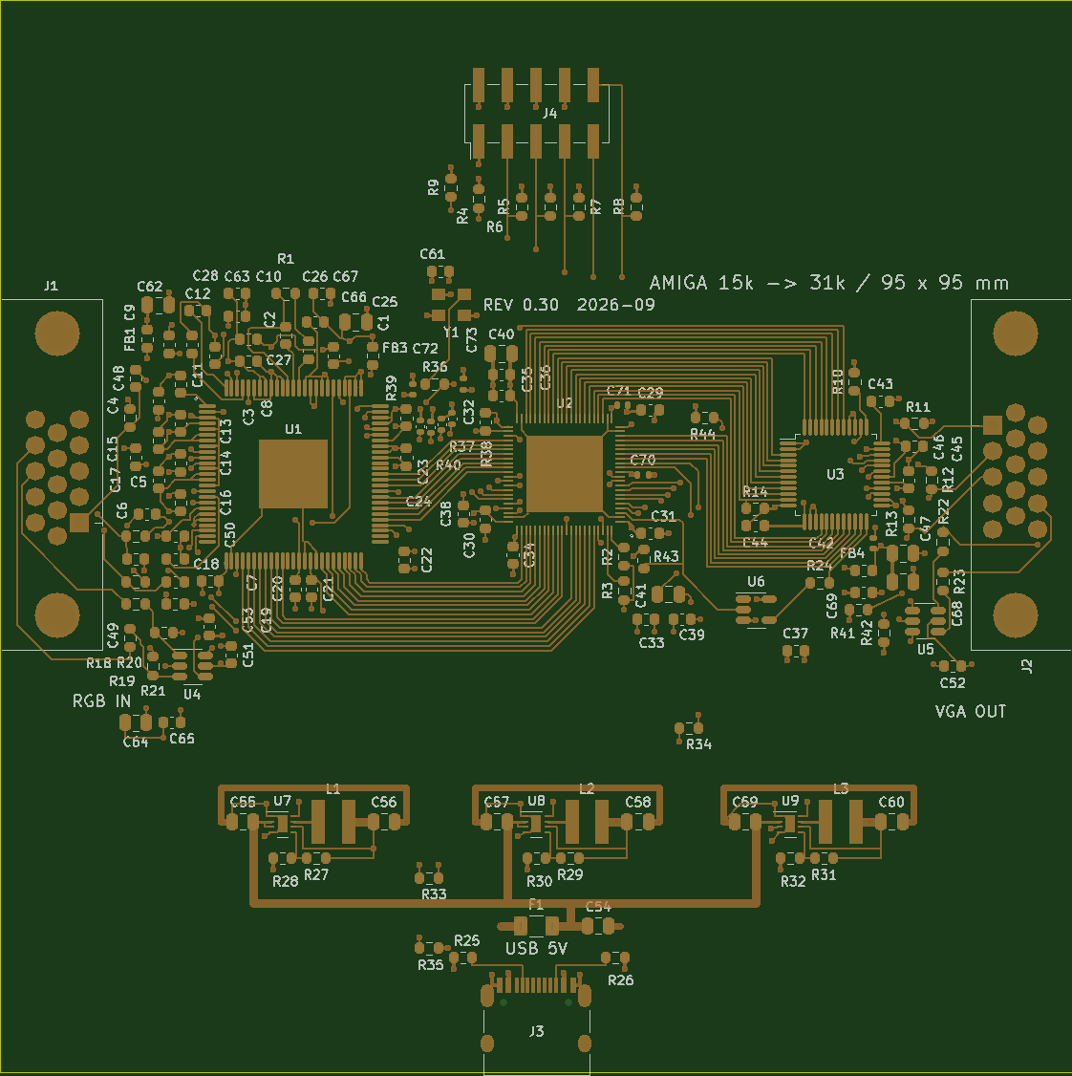
outputs/amiga_scandoubler/fab/v030wip/preview_top.png
