110-kenichi/A1200LineDoubler/outputs/amiga_scandoubler/placement_review.png

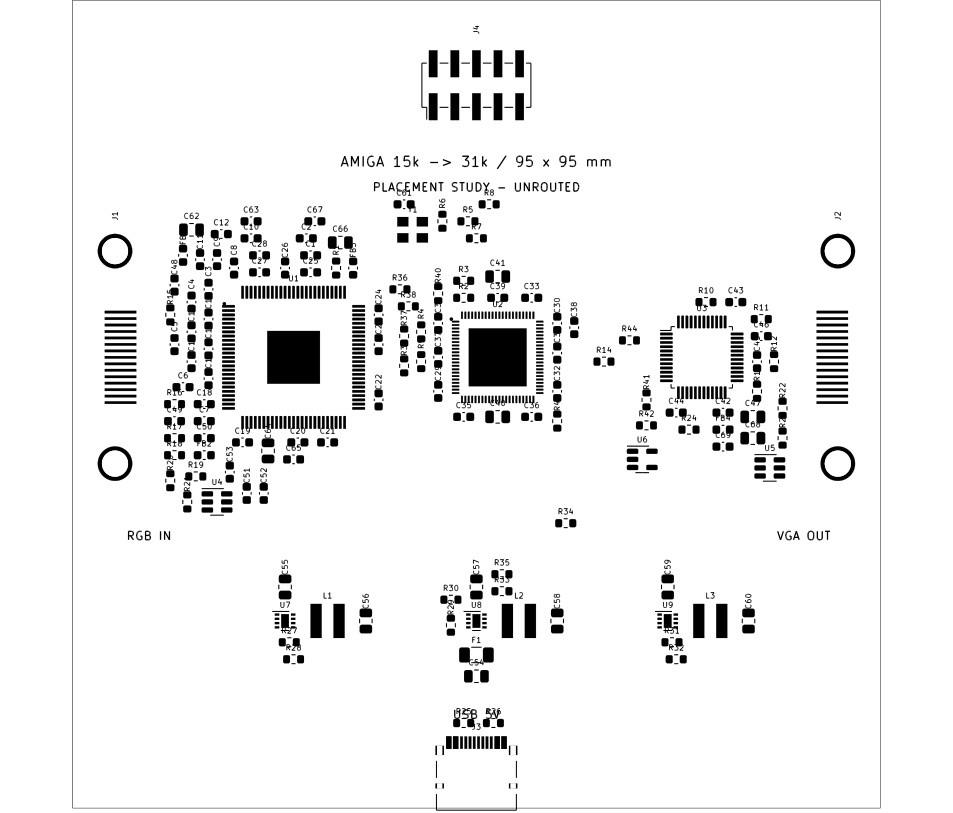
outputs/amiga_scandoubler/placement_review.png
