110-kenichi/A1200LineDoubler/outputs/amiga_scandoubler/power_routing_detail.png

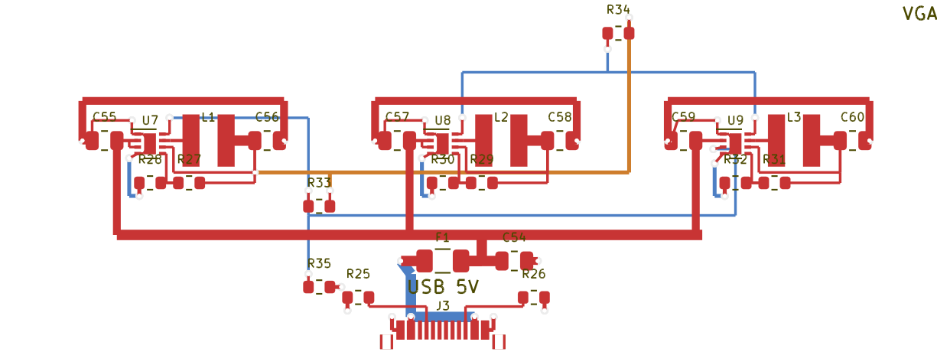
outputs/amiga_scandoubler/power_routing_detail.png
