110-kenichi/A1200LineDoubler/outputs/amiga_scandoubler/power_routing_review.png

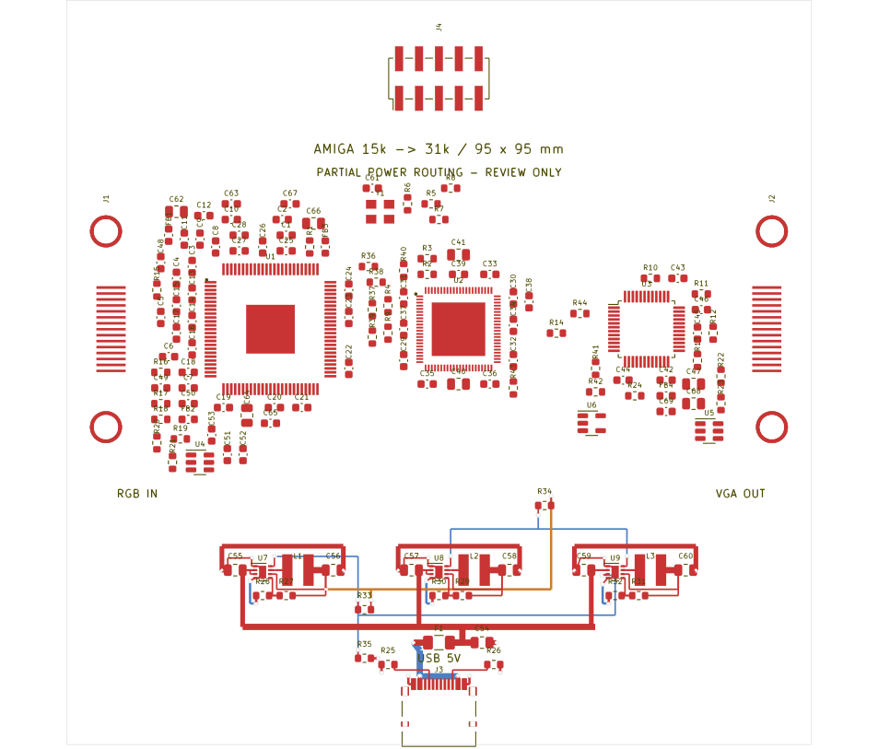
outputs/amiga_scandoubler/power_routing_review.png
