110-kenichi/A1200LineDoubler/outputs/amiga_scandoubler/sync_in_preview.png

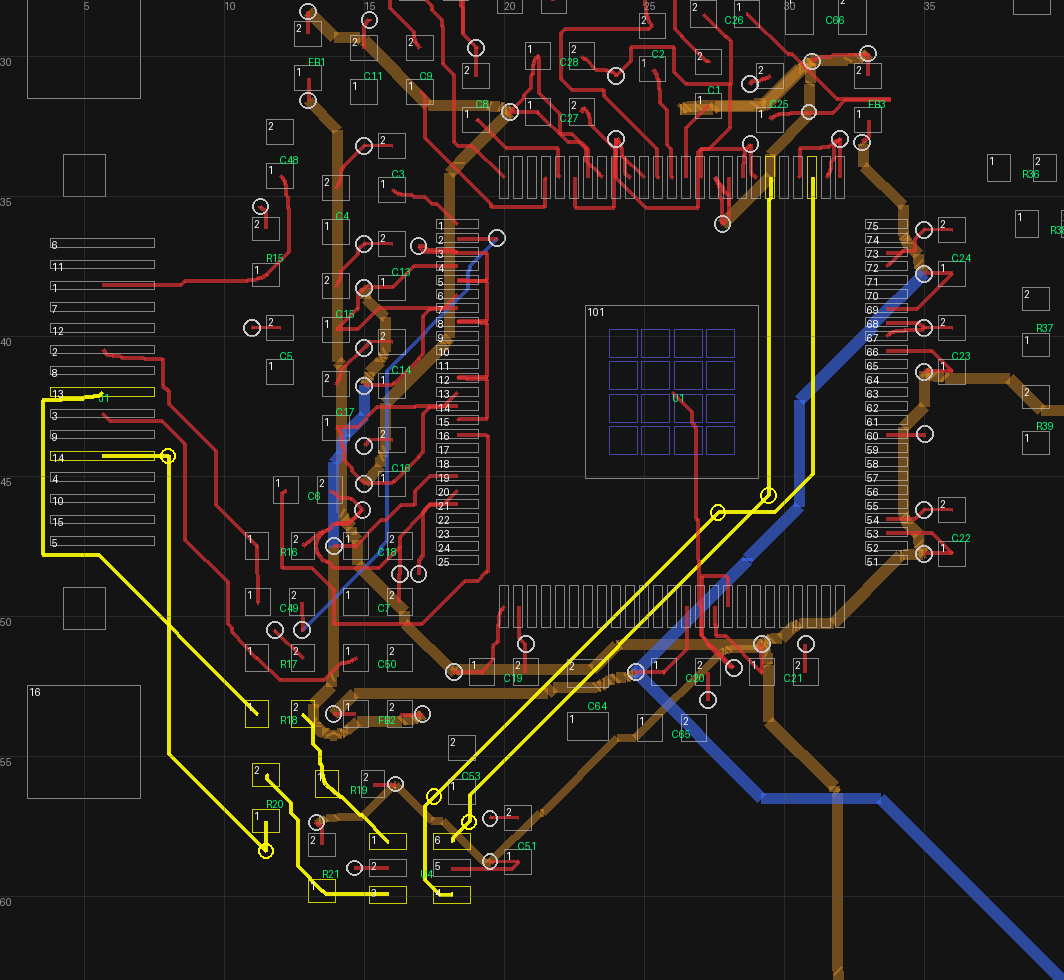
outputs/amiga_scandoubler/sync_in_preview.png
