110-kenichi/A1200LineDoubler/outputs/amiga_scandoubler/u2rot_preview.png

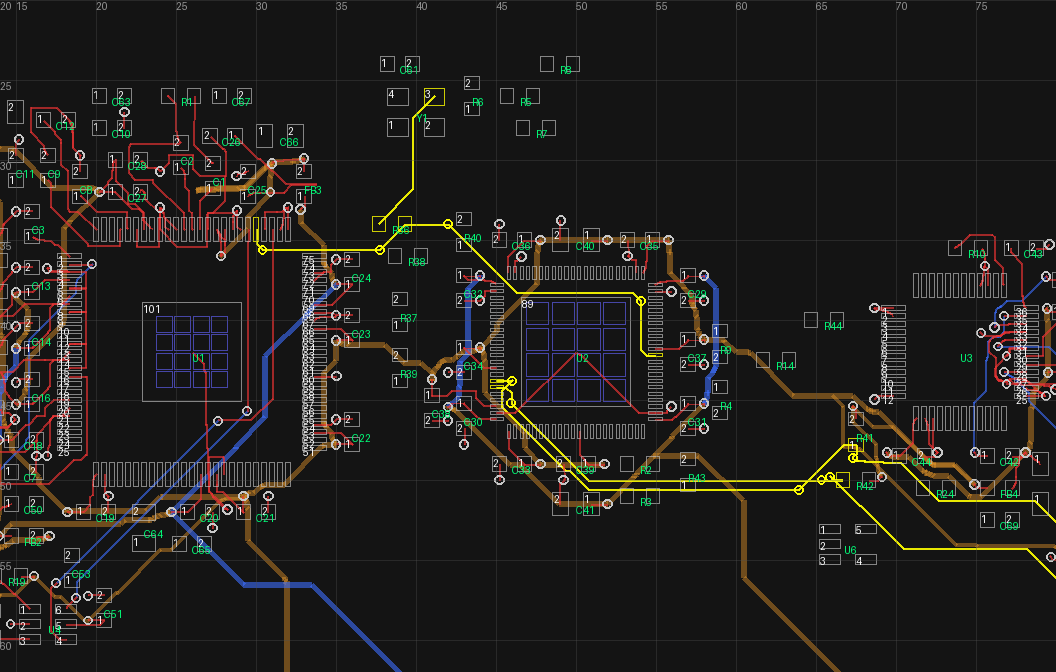
outputs/amiga_scandoubler/u2rot_preview.png
