110-kenichi/A1200LineDoubler/outputs/amiga_scandoubler/fab/v030wip/jlc_bom_dnp_J1J2.csv

Comment | Designator | Footprint | LCSC Part # | MPN
100nF | C1,C13,C14,C15,C16,C17,C18,C19,C20,C21,C22,C23,C24,C25,C26,C27,C28,C29,C30,C31,C32,C33,C34,C35,C36,C37,C38,C39,C43,C44,C45,C46,C48,C49,C50,C51,C52,C53,C61,C63,C65,C67,C69 | C_0603_1608Metric | C14663 | CC0603KRX7R9BB104
4.7nF | C2 | C_0603_1608Metric | C576818 | CC0603JRNPO9BN472
1nF | C3,C9,C11 | C_0603_1608Metric | C106246 | CC0603JRNPO9BN102
10nF | C4,C5,C6,C7,C8,C10,C12 | C_0603_1608Metric | C85973 | GRM1885C1H103JA01D
4.7uF | C40,C41,C62,C64,C66,C68 | C_0805_2012Metric | C1779 | CL21A475KAQNNNE
100nF | C42,C70,C71,C72,C73 | C_0402_1005Metric | C1525 | CL05B104KO5NNNC
10uF 25V | C47,C54,C55,C57,C59 | C_0805_2012Metric | C15850 | CL21A106KAYNNNE
22uF 10V | C56,C58,C60 | C_0805_2012Metric | C45783 | CL21A226MAQNNNE
1A hold - select | F1 | Fuse_1206_3216Metric | C269119 | SMD1206B110TFT
220R@100MHz | FB1,FB2,FB3,FB4 | L_0603_1608Metric | C304314 | HCB1608KF-221T20
TYPE-C-31-M-12 | J3 | USB_C_Receptacle_HRO_TYPE-C-31-M-12_Slot0.8 | C165948 | TYPE-C-31-M-12
JTAG 2x05 2.54mm | J4 | PinHeader_2x05_P2.54mm_Vertical_SMD | C32713285 | HX PZ2.54-2x5P TP
2.2uH | L1,L2,L3 | L_TDK_VLS4012CX | C92959 | NRS4018T2R2MDGJ
1.5k | R1 | R_0603_1608Metric | C22843 | 0603WAF1501T5E
4.7k | R2,R3,R4,R5,R6,R7,R8,R9,R44 | R_0603_1608Metric | C23162 | 0603WAF4701T5E
536R 0.1% | R10 | R_0603_1608Metric | C861466 | RT0603BRD07536RL
75R 0.1% | R11,R12,R13,R15,R16,R17 | R_0603_1608Metric | C319466 | AR03BTCX0750
10k | R14,R33,R34,R41,R42,R43 | R_0603_1608Metric | C25804 | 0603WAF1002T5E
33R | R18,R20,R22,R23 | R_0603_1608Metric | C23140 | 0603WAF330JT5E
100k | R19,R21,R35 | R_0603_1608Metric | C25803 | 0603WAF1003T5E
22R | R24,R36 | R_0603_1608Metric | C23345 | 0603WAF220JT5E
5.1k 1% | R25,R26 | R_0603_1608Metric | C23186 | 0603WAF5101T5E
312k 0.1% | R27 | R_0603_1608Metric | C861315 | RT0603BRD07312KL
100k 0.1% | R28,R30,R32 | R_0603_1608Metric | C122538 | RT0603BRD07100KL
137k 0.1% | R29 | R_0603_1608Metric | C861114 | RT0603BRD07137KL
49.9k 0.1% | R31 | R_0603_1608Metric | C705780 | RT0603BRD0749K9L
2.2k | R37,R38 | R_0402_1005Metric | C25879 | 0402WGF2201TCE
10k | R39,R40 | R_0402_1005Metric | C25744 | 0402WGF1002TCE
TVP7002PZP | U1 | TQFP-100_TVP7002_14x14_P0.5_EP6.2 | C3824085 | TVP7002PZP
GW1N-LV4QN88C6/I5 | U2 | QFN-88_GW1N4_10x10_P0.4_EP6.8 | C31900351 | GW1N-LV4QN88C6/I5
ADV7125KSTZ140 | U3 | LQFP-48_7x7mm_P0.5mm | C9668 | ADV7125KSTZ140
SN74LVC2G17DBVR | U4,U5 | SOT-23-6 | C19829674 | SN74LVC2G17DBVR
SN74LVC1G17DBVR | U6 | SOT-23-5 | C7836 | SN74LVC1G17DBVR
TPS62160DSGR | U7,U8,U9 | WSON-8-1EP_2x2mm_P0.5mm_EP0.9x1.6mm | C324077 | TPS62160DSGR
27MHz OT2EL4C4JI-111OLP-27M | Y1 | OSC_ECS-3225MVLC_3.2x2.5 | C5203549 | OT2EL4C4JI-111OLP-27M
