110-kenichi/A1200LineDoubler/work/v031dac/sim/run_capture_tests.txt

PASS adc_rgb_capture PERIOD_PS=41667 DATA_DELAY_PS=0 DUTY=48 PHASE=180: 228 coherent RGB/HS samples, every-other-cycle cadence, asynchronous reset/restart
/home/user/A1200LineDoubler/outputs/amiga_scandoubler/sim/tb_adc_rgb_capture.sv:52: $finish called at 10145081 (1ps)
PASS adc_rgb_capture PERIOD_PS=41667 DATA_DELAY_PS=1500 DUTY=48 PHASE=180: 228 coherent RGB/HS samples, every-other-cycle cadence, asynchronous reset/restart
/home/user/A1200LineDoubler/outputs/amiga_scandoubler/sim/tb_adc_rgb_capture.sv:52: $finish called at 10145081 (1ps)
PASS adc_rgb_capture PERIOD_PS=41667 DATA_DELAY_PS=0 DUTY=50 PHASE=180: 228 coherent RGB/HS samples, every-other-cycle cadence, asynchronous reset/restart
/home/user/A1200LineDoubler/outputs/amiga_scandoubler/sim/tb_adc_rgb_capture.sv:52: $finish called at 10146158 (1ps)
PASS adc_rgb_capture PERIOD_PS=41667 DATA_DELAY_PS=1500 DUTY=50 PHASE=180: 228 coherent RGB/HS samples, every-other-cycle cadence, asynchronous reset/restart
/home/user/A1200LineDoubler/outputs/amiga_scandoubler/sim/tb_adc_rgb_capture.sv:52: $finish called at 10146158 (1ps)
PASS adc_rgb_capture PERIOD_PS=41667 DATA_DELAY_PS=0 DUTY=52 PHASE=180: 228 coherent RGB/HS samples, every-other-cycle cadence, asynchronous reset/restart
/home/user/A1200LineDoubler/outputs/amiga_scandoubler/sim/tb_adc_rgb_capture.sv:52: $finish called at 10146748 (1ps)
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
/home/user/A1200LineDoubler/outputs/amiga_scandoubler/sim/tb_adc_rgb_capture.sv:52: $finish called at 7579500 (1ps)
PASS adc_rgb_capture PERIOD_PS=31000 DATA_DELAY_PS=1500 DUTY=50 PHASE=180: 228 coherent RGB/HS samples, every-other-cycle cadence, asynchronous reset/restart
/home/user/A1200LineDoubler/outputs/amiga_scandoubler/sim/tb_adc_rgb_capture.sv:52: $finish called at 7579500 (1ps)
PASS adc_rgb_capture PERIOD_PS=31000 DATA_DELAY_PS=0 DUTY=52 PHASE=180: 228 coherent RGB/HS samples, every-other-cycle cadence, asynchronous reset/restart
/home/user/A1200LineDoubler/outputs/amiga_scandoubler/sim/tb_adc_rgb_capture.sv:52: $finish called at 7580120 (1ps)
PASS adc_rgb_capture PERIOD_PS=31000 DATA_DELAY_PS=1500 DUTY=52 PHASE=180: 228 coherent RGB/HS samples, every-other-cycle cadence, asynchronous reset/restart
/home/user/A1200LineDoubler/outputs/amiga_scandoubler/sim/tb_adc_rgb_capture.sv:52: $finish called at 7580120 (1ps)
