110-kenichi/A1200LineDoubler/work/v031dac/sim/run_system_tests.txt

PASS amiga_logic_core: 12261 visible RGB checks; 36-write ADC start, input capture, clock/sync acquisition, stopped ADC recovery with new color, power loss and startup NACK
/home/user/A1200LineDoubler/outputs/amiga_scandoubler/sim/tb_amiga_logic_core.sv:106: $finish called at 70529457500 (1ps)
