110-kenichi/A1200LineDoubler/outputs/amiga_scandoubler/verification.md

# 検証状況と完成条件

## 今回の検証

Icarus Verilog 14.0開発版でSystemVerilogのコンパイルとシミュレーションを実施。詳細は`simulation_report.txt`。

- N=32、1816、1820、2048について、12入力ラインを処理し、先行ライン11本×2回の出力画素を期待値と逐次照合。
- 合計125,752画素でRGB値、水平画素位置、出力ライン開始が一致することを検査。
- 起動後に未初期化メモリを出力しないこと、ライン開始の欠落を異常にすること、サンプル間隔違反を検出すること、リセットで状態を消去することを検査。
- 垂直同期は524/525/624/625/626出力ライン間隔の合成フィールドイベントを入力し、各イベントから1入力ライン後に1フレームが開始することを検査。奇数間隔は全ライン/半ライン位相が交互になるケース、偶数間隔は同じ位相が続くケース。
- 垂直同期幅を5出力ラインとして検査。この値は実際の最終モード設定を保証するものではない。

## この検証が含まないもの

実際のAmiga波形、ADCの量子化・ゲイン・クランプ・PLL、実機でのモード切替、FPGAメモリへの推論、クロック制約とタイミング収束、DAC出力の電圧、GW2780表示、USB消費電流、基板のERC/DRC。

`line_double`の入力契約は厳密で、H_SAMPLES個の入力サンプルと、ちょうど2×H_SAMPLESクロックごとの正規化済みライン開始を要求する。これは同期回復回路ではない。実入力の長短ラインやPLLロック中の変動を扱う前段は未実装。`field_sync`との直列接続時には、登録出力の1クロック遅延も合わせて検証する必要がある。

## 製造データを完成させるための残作業

1. ADC/DAC/FPGA/コネクターの正確な型番とJLCPCBの調達経路を確定。
2. 電源回路の最大電流、効率、起動順、USB給電条件を確定。
3. 全端子と全受動部品を含む回路図を作成し、メーカー資料と照合、ERC。
4. ADC初期化・同期正規化・PLL・有効画面範囲・H/V出力・DAC駆動を統合。電源投入、同期断、PAL/NTSC切替を含むシミュレーション。
5. 選定FPGAへの合成、メモリ使用量、I/Oバンク電圧、PLL対応ピン、JTAG保持、タイミング制約を確認。書き込みデータを生成。
6. 回路とFPGAピン割り当てから基板配置・配線。全ネットの接続とDRC、電源・帰路・アナログ配線を確認。
7. その同一基板リビジョンからガーバー、ドリル、BOM、CPLを生成。部品参照名、パッケージ、位置、回転角、表裏が一致することを確認。
8. 実装プレビューで極性・1番ピン・コネクター方向を確認し、試作向け製造パッケージとしてリリース。

## 試作後の実機確認

電源のみで全レール・消費電流・発熱を測定し、FPGA設定とADCのI²C読み戻しを確認。既存アダプターの配線を確認してAmigaを接続する。

PAL/NTSC各々について非インターレースとインターレースを表示し、黒・白・RGBランプ・1画素縞・細線・スクロールを観察。SuperHiresやオーバースキャンを含む実使用モードでクロック位相と有効範囲を調整。GW2780のVGA入力でロック、画面位置、欠け、Bobのフィールド境界を確認する。

入力と出力の対応するRGB遷移をオシロスコープで測定し、1回目・2回目の出力それぞれの最大遅延が0.2ms以内か確認する。LCD内部遅延はこの測定に含めない。

## v0.6で追加した確認項目

- 映像クロック停止中のDAC PSAVE Low時のアナログRGB電圧。
- PSAVE復帰時の過渡波形とBLANK・DACクロックの関係。
- 監視回路のCDC・非同期リセット解除・実装タイミング。
- 起動許可とロック通知の循環依存がないこと。
