110-kenichi/A1200LineDoubler/outputs/amiga_scandoubler/schematic_review.pdf

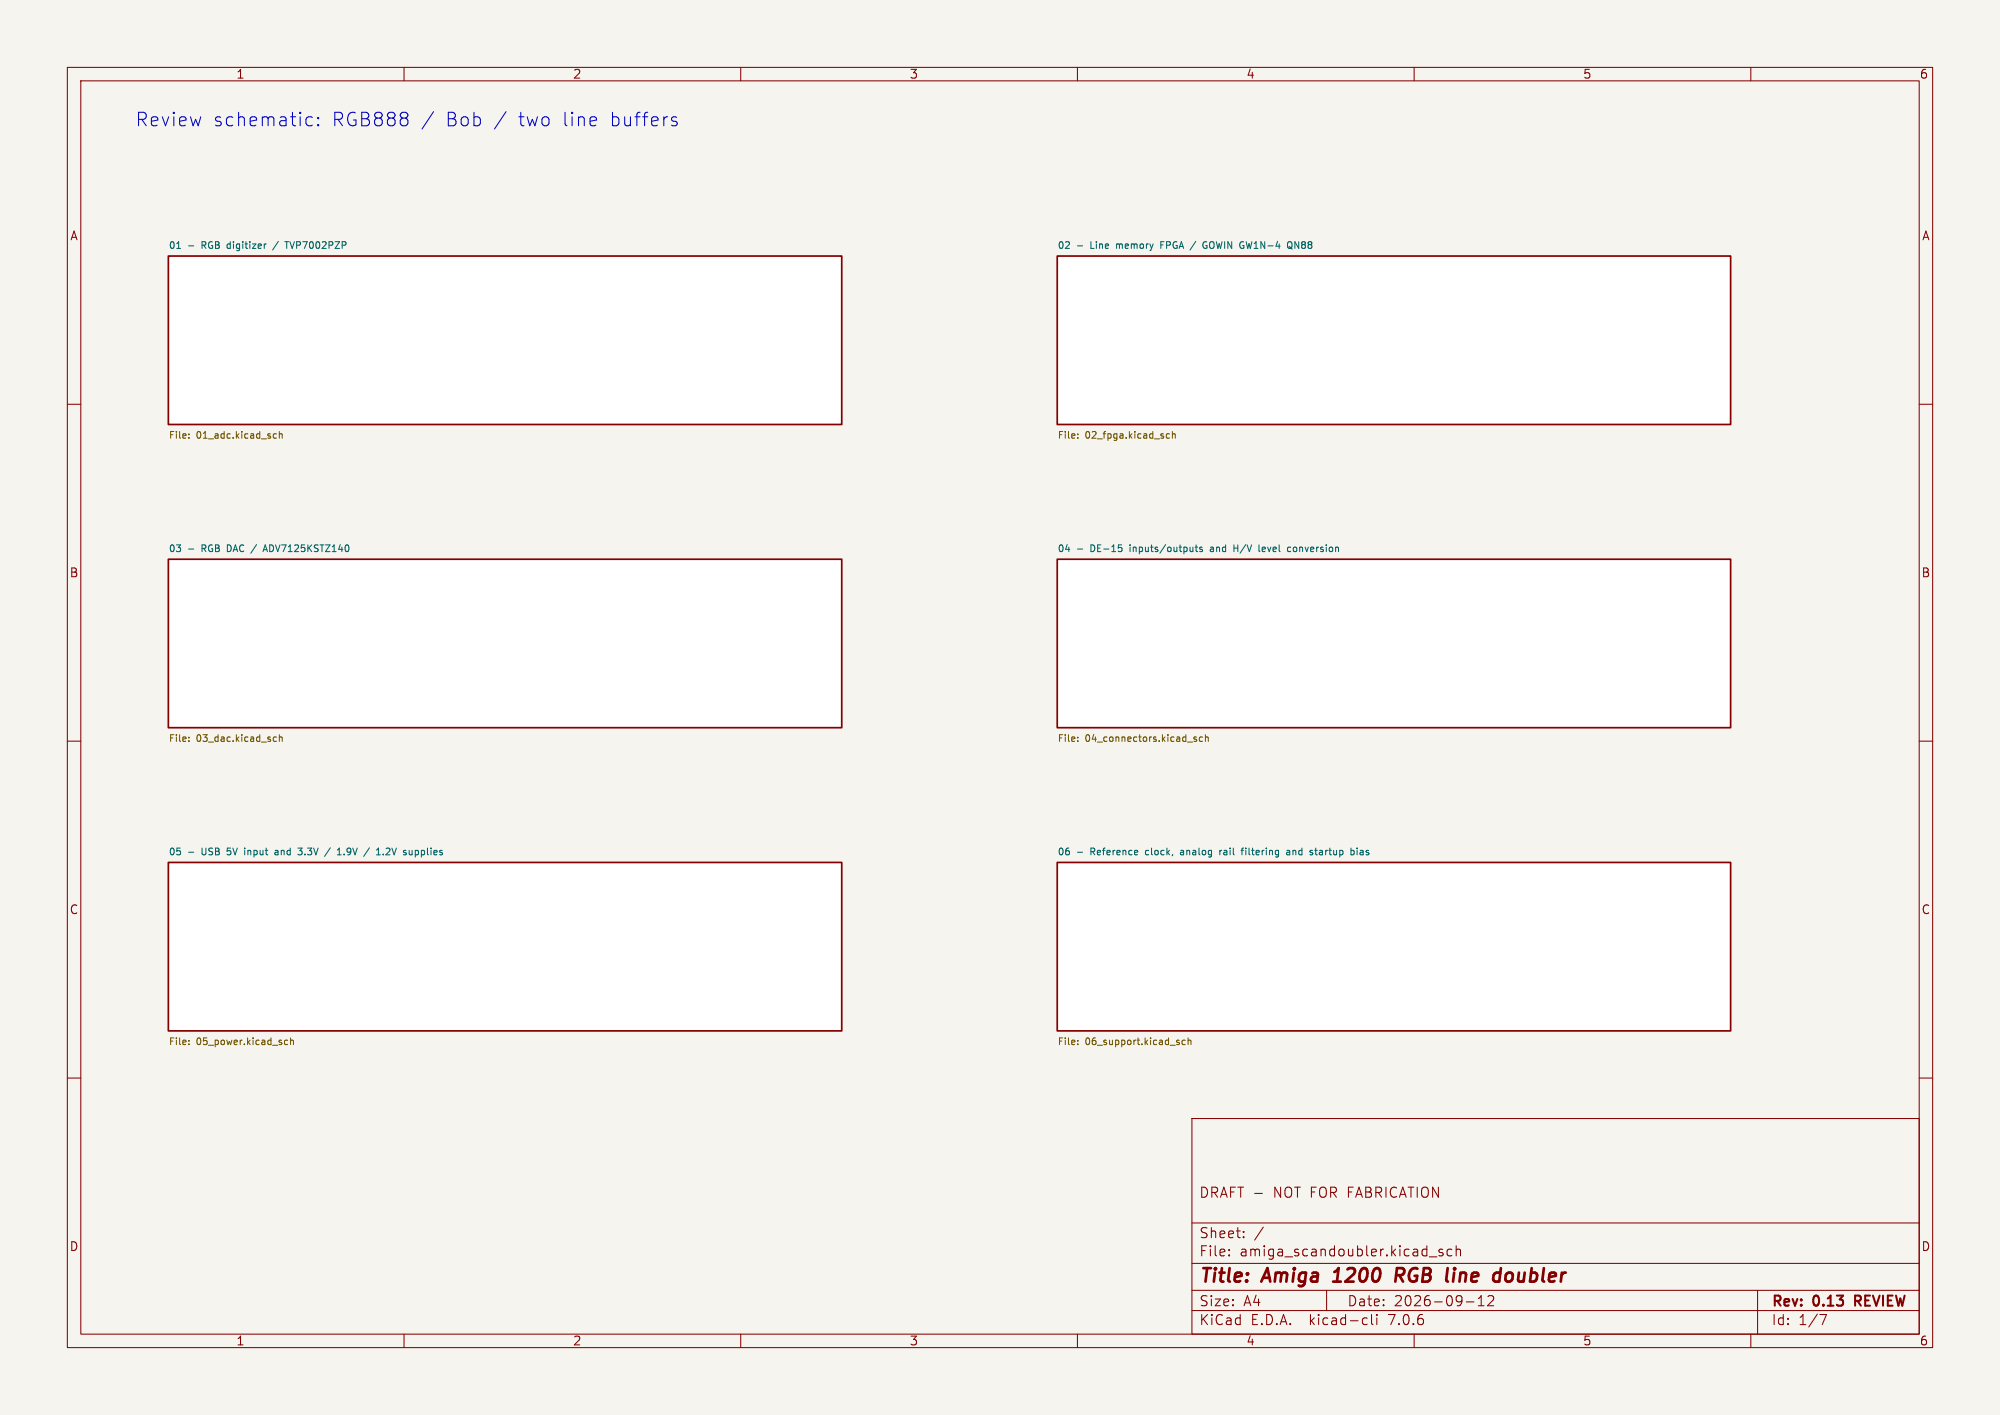
[picture p9: page 1]

02 - Line memory FPGA / GOWIN GW1N-4 QN88 File: 02_fpga.kicad_sch

05 - USB 5V input and 3.3V / 1.9V / 1.2V supplies File: 05_power.kicad_sch

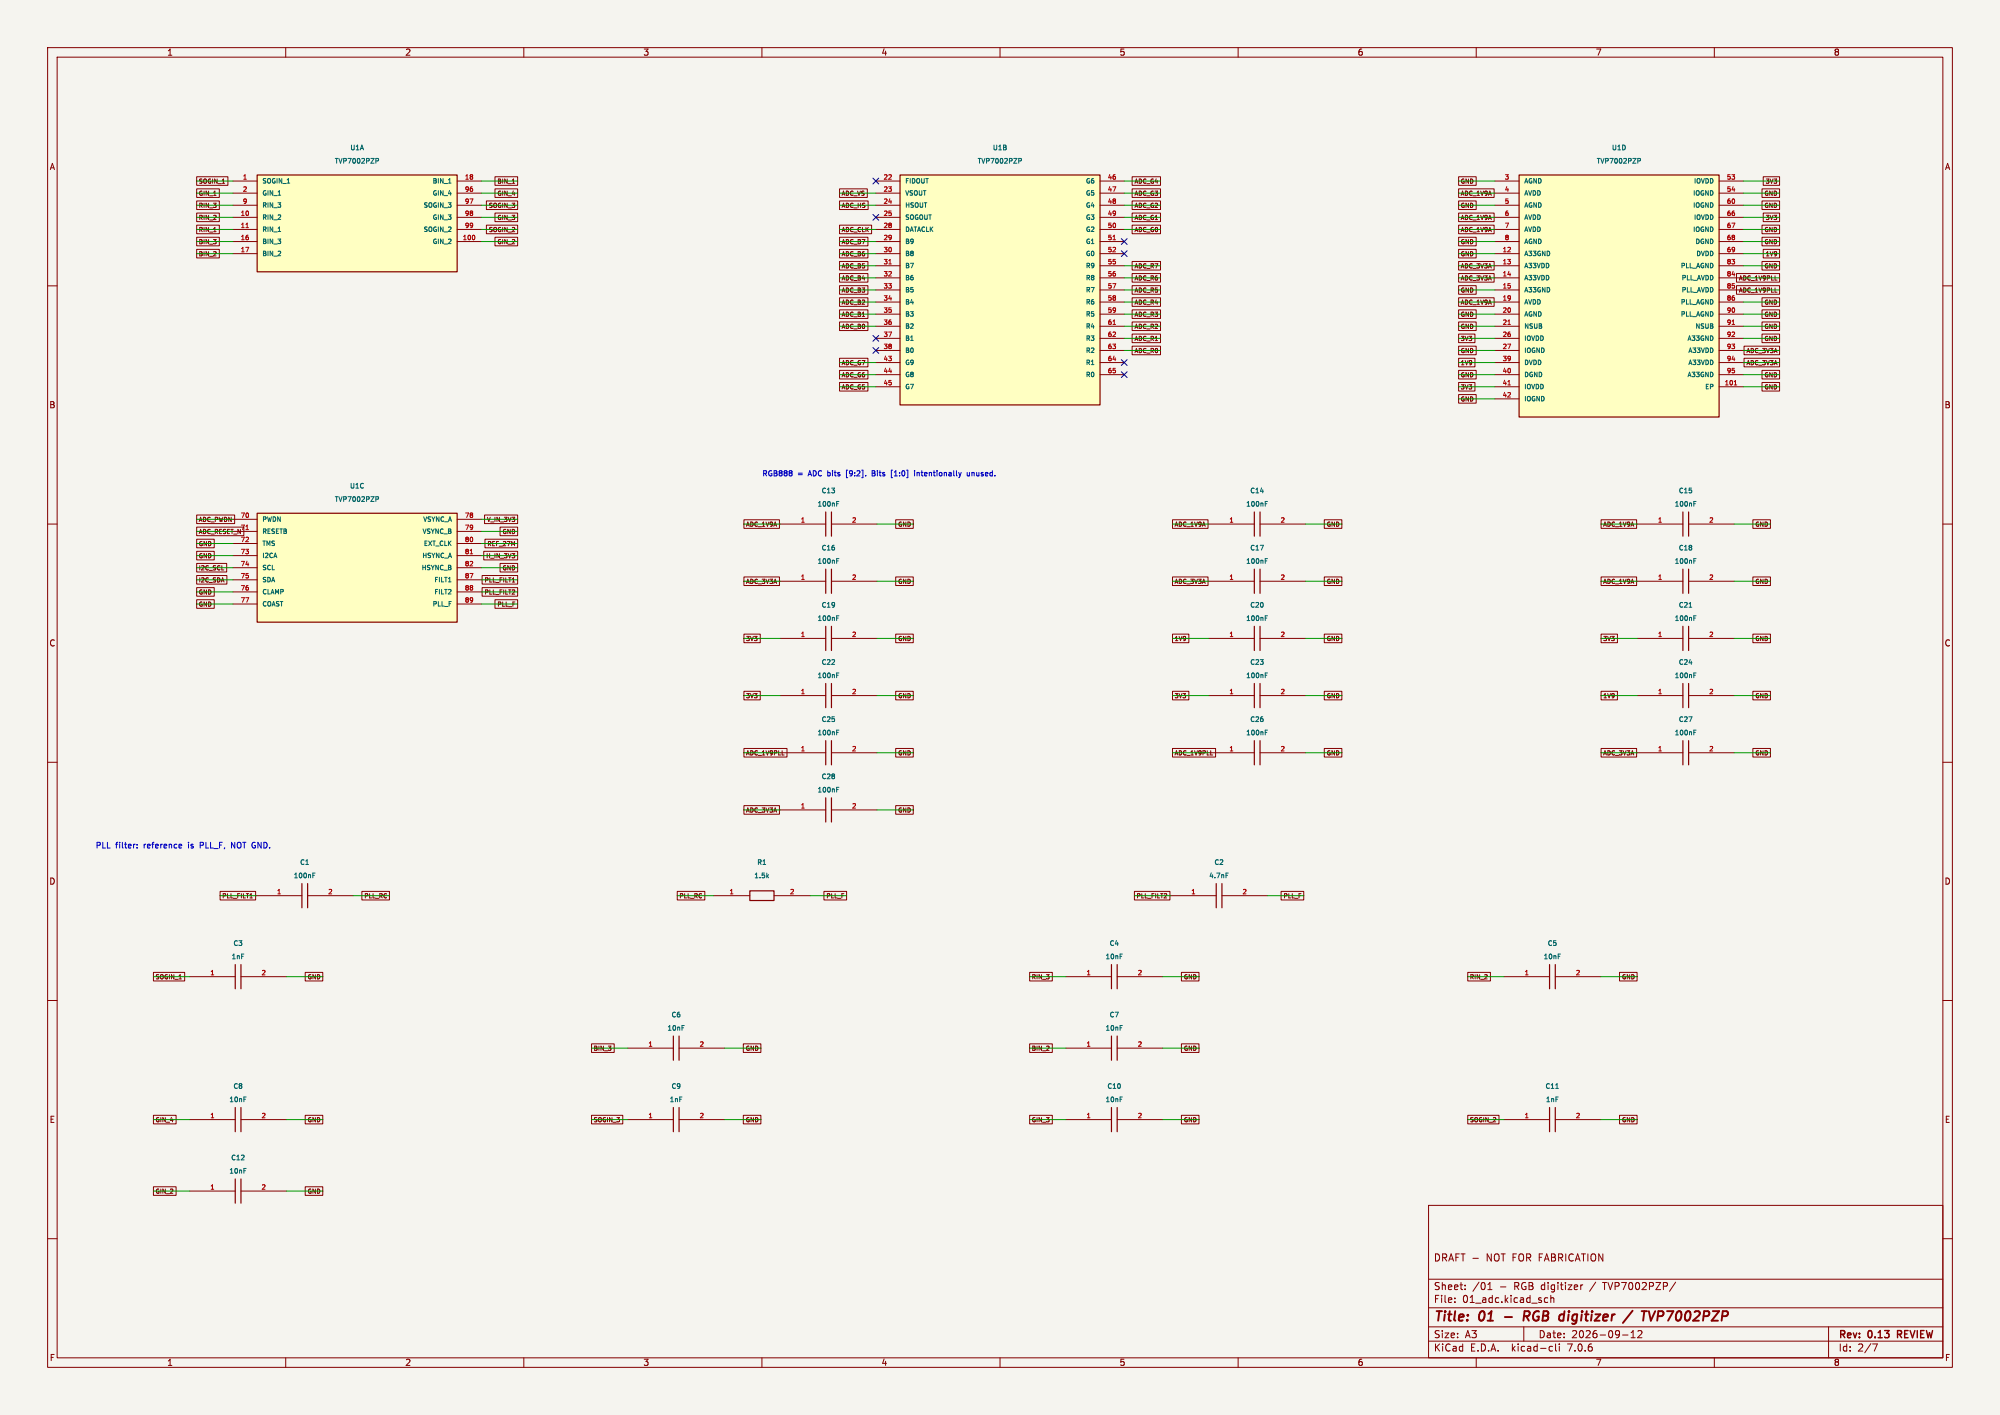
[picture p10: page 2]

Id: 2/7 Title: 01 - RGB digitizer / TVP7002PZP

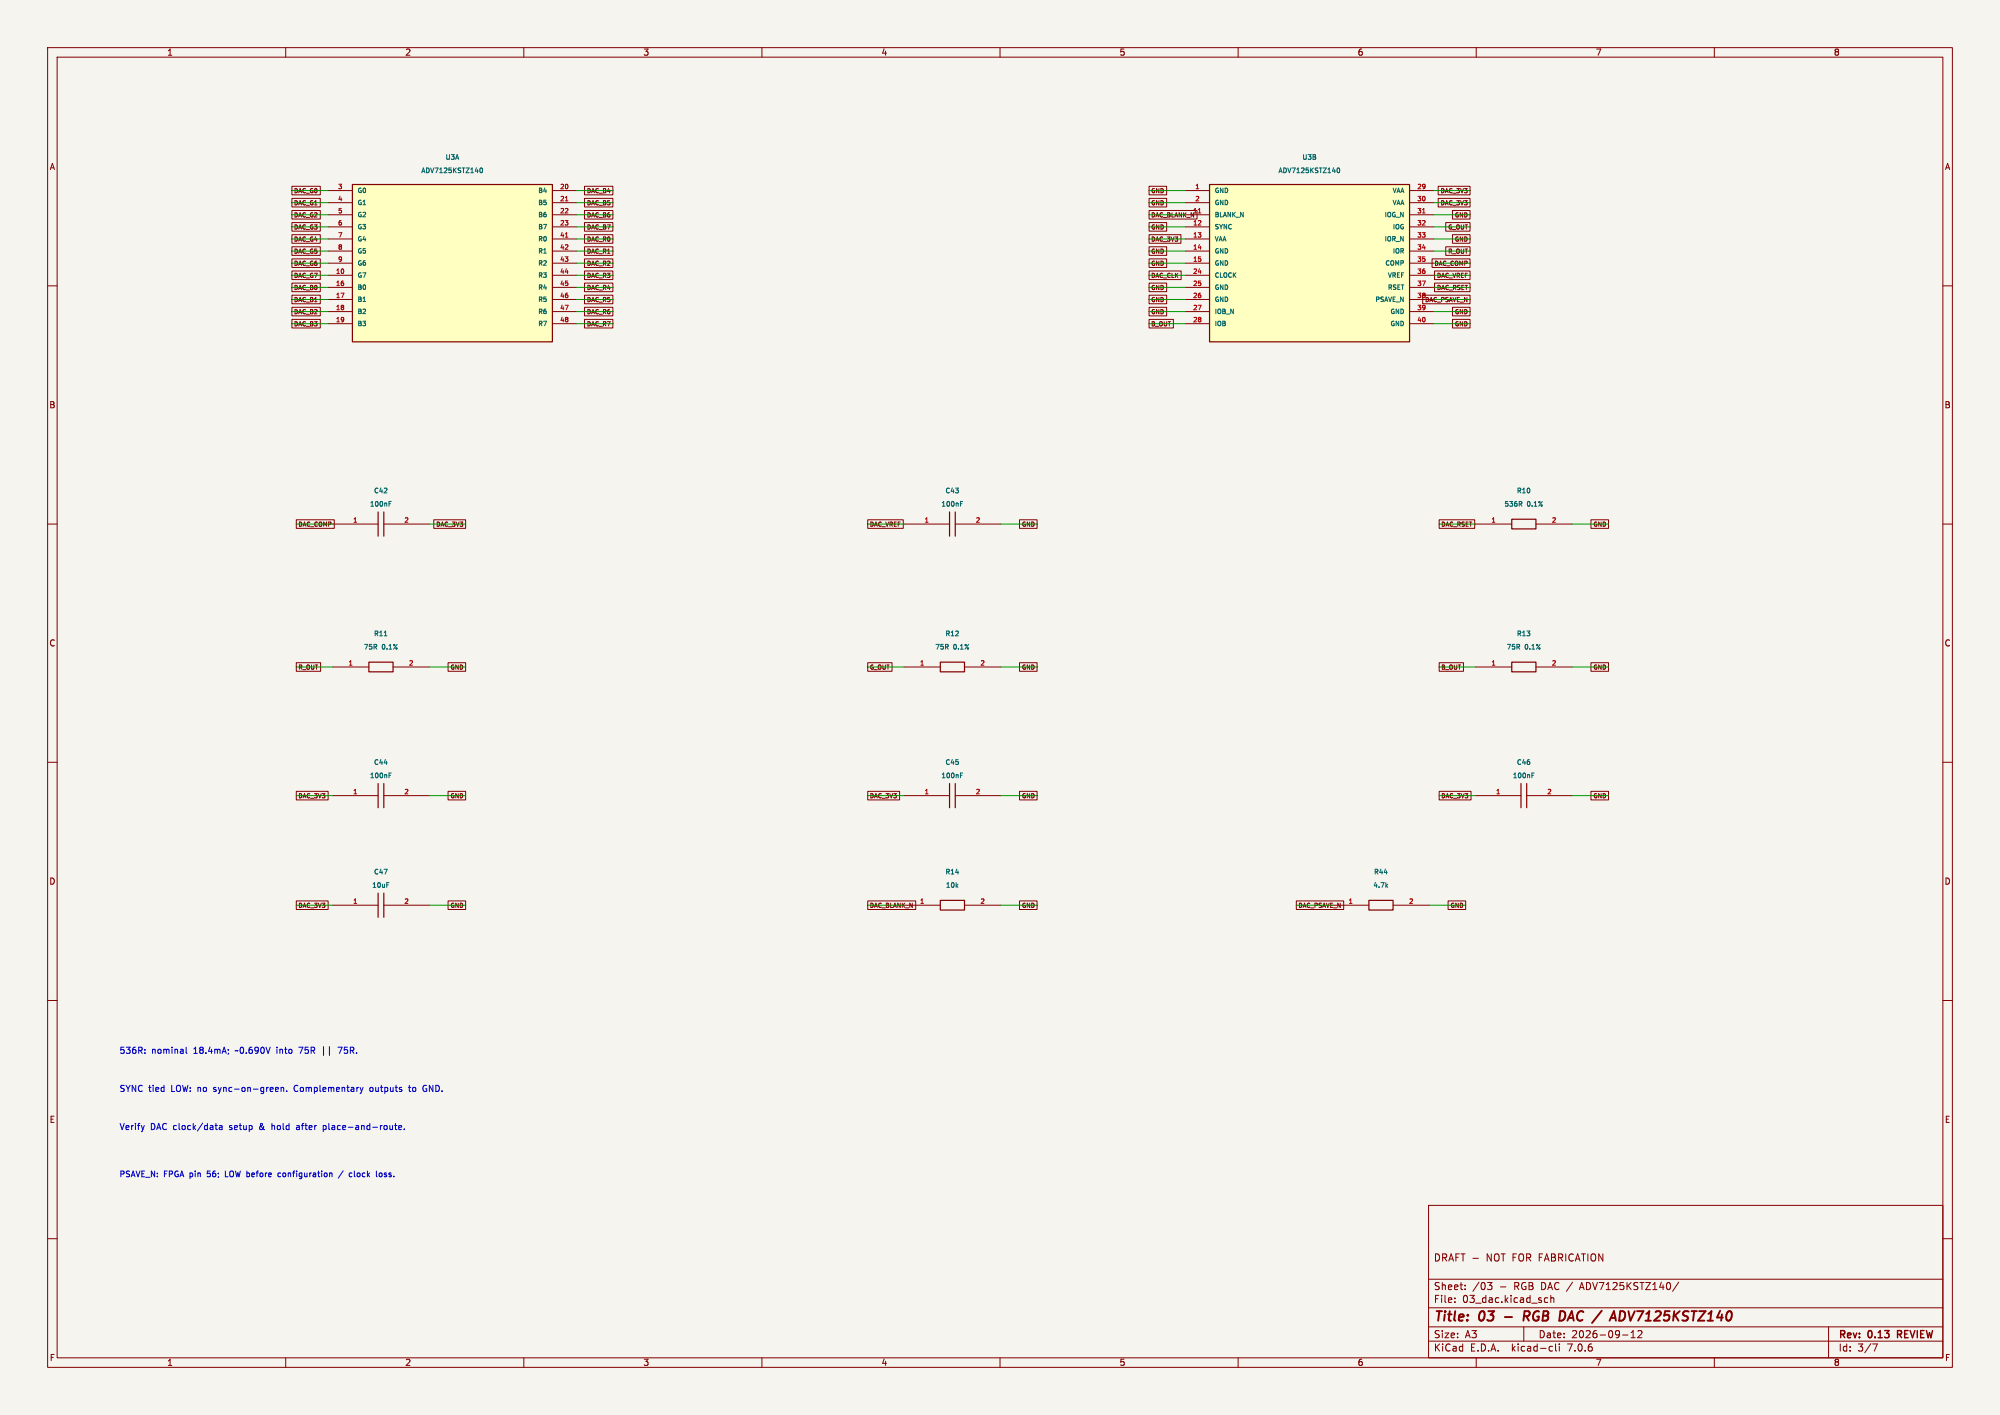
[picture p11: page 3]

Id: 3/7 Title: 03 - RGB DAC / ADV7125KSTZ140

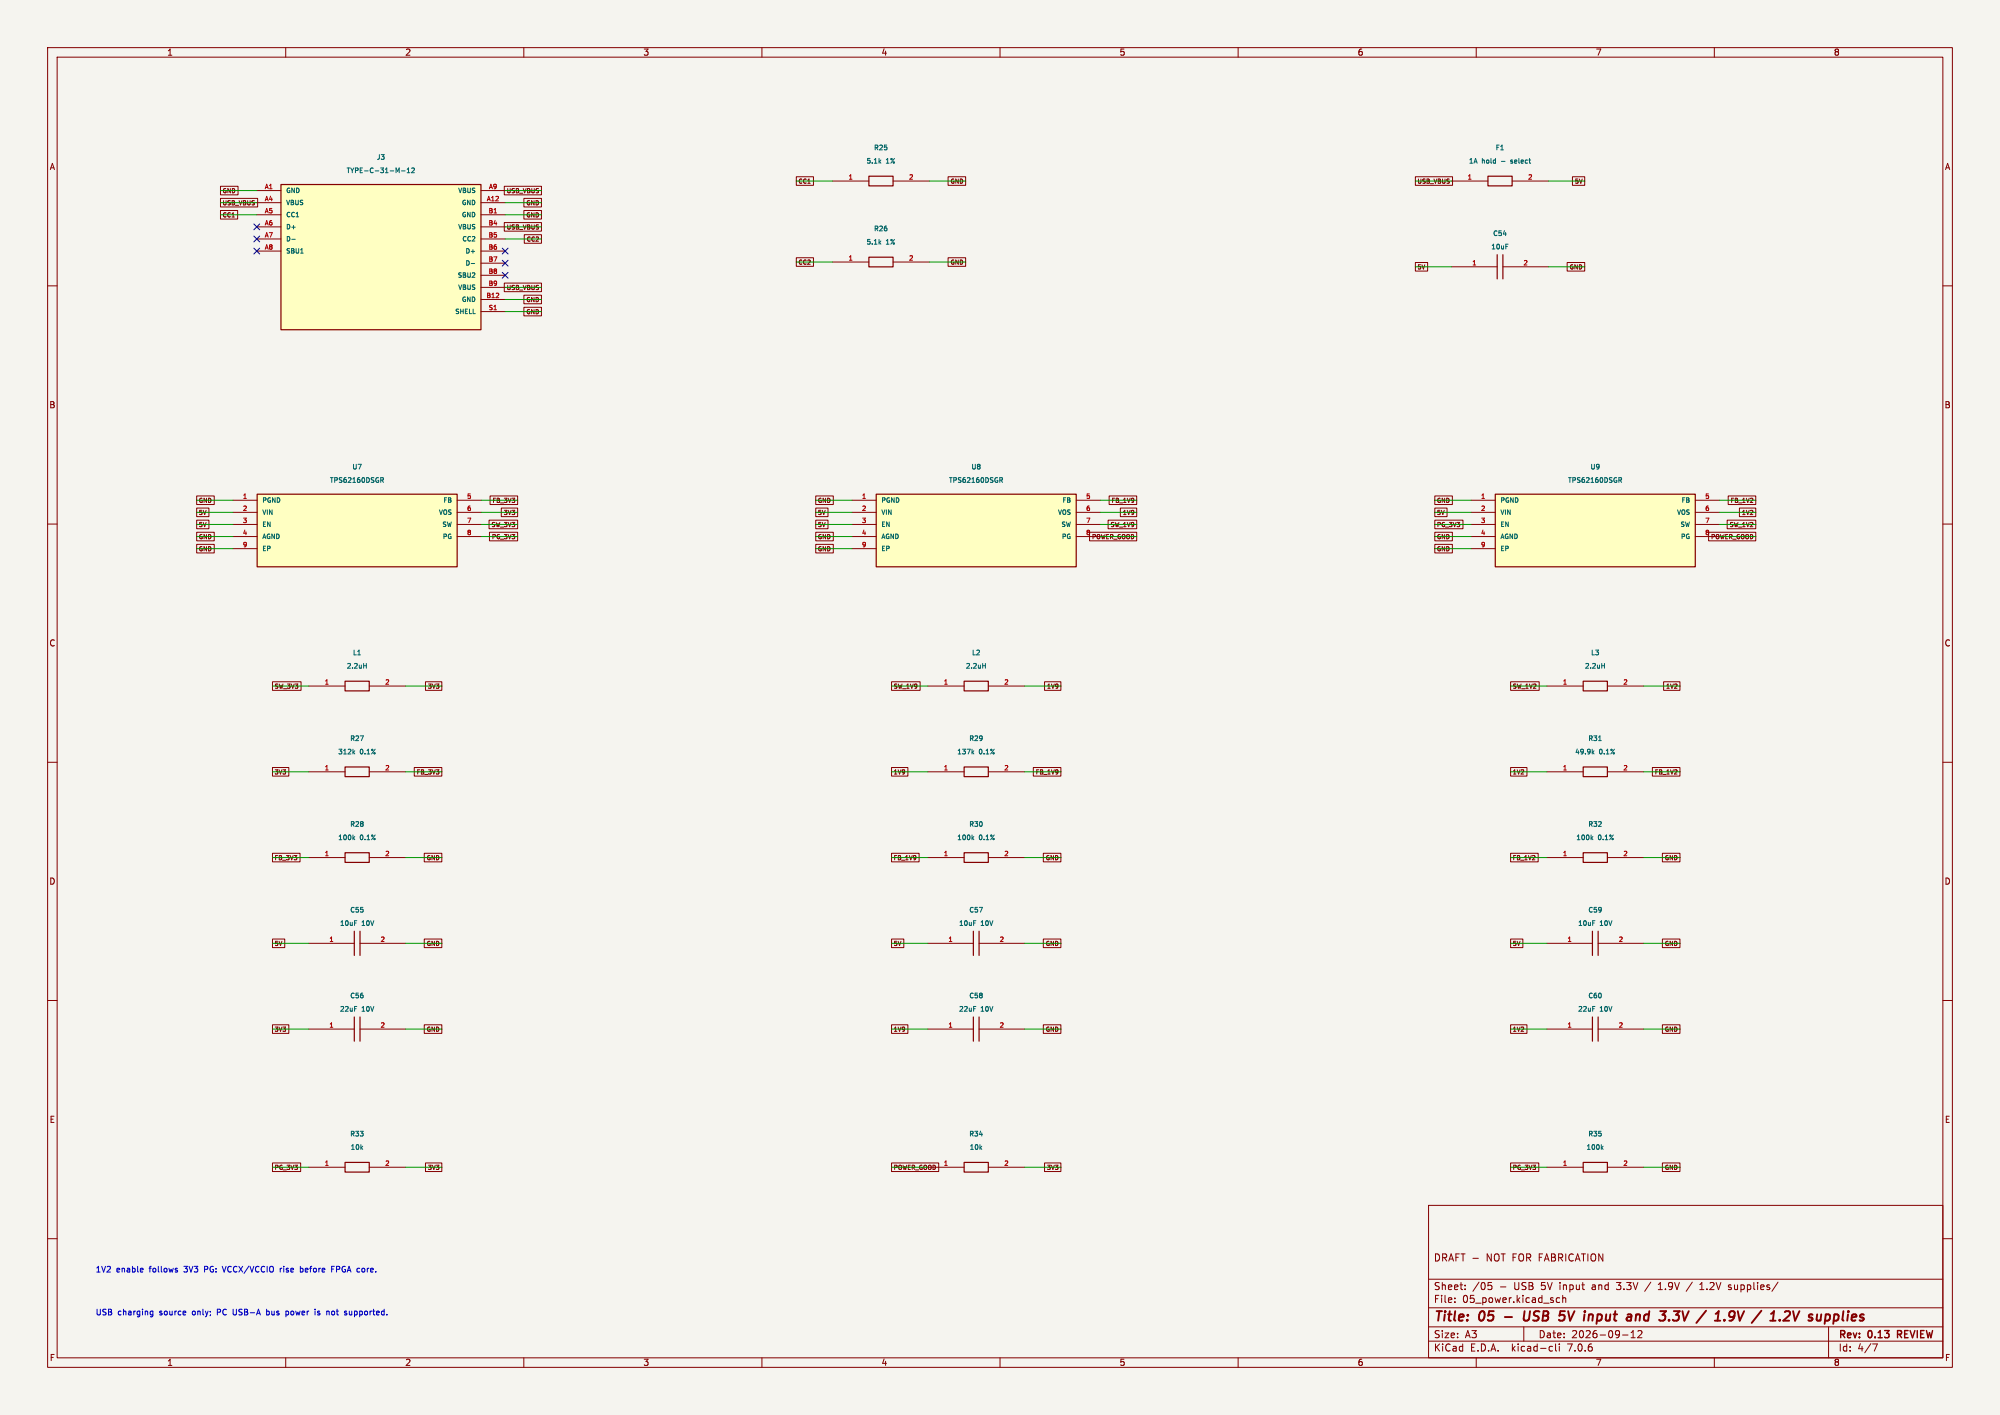
[picture p12: page 4]

Id: 4/7 Title: 05 - USB 5V input and 3.3V / 1.9V / 1.2V supplies

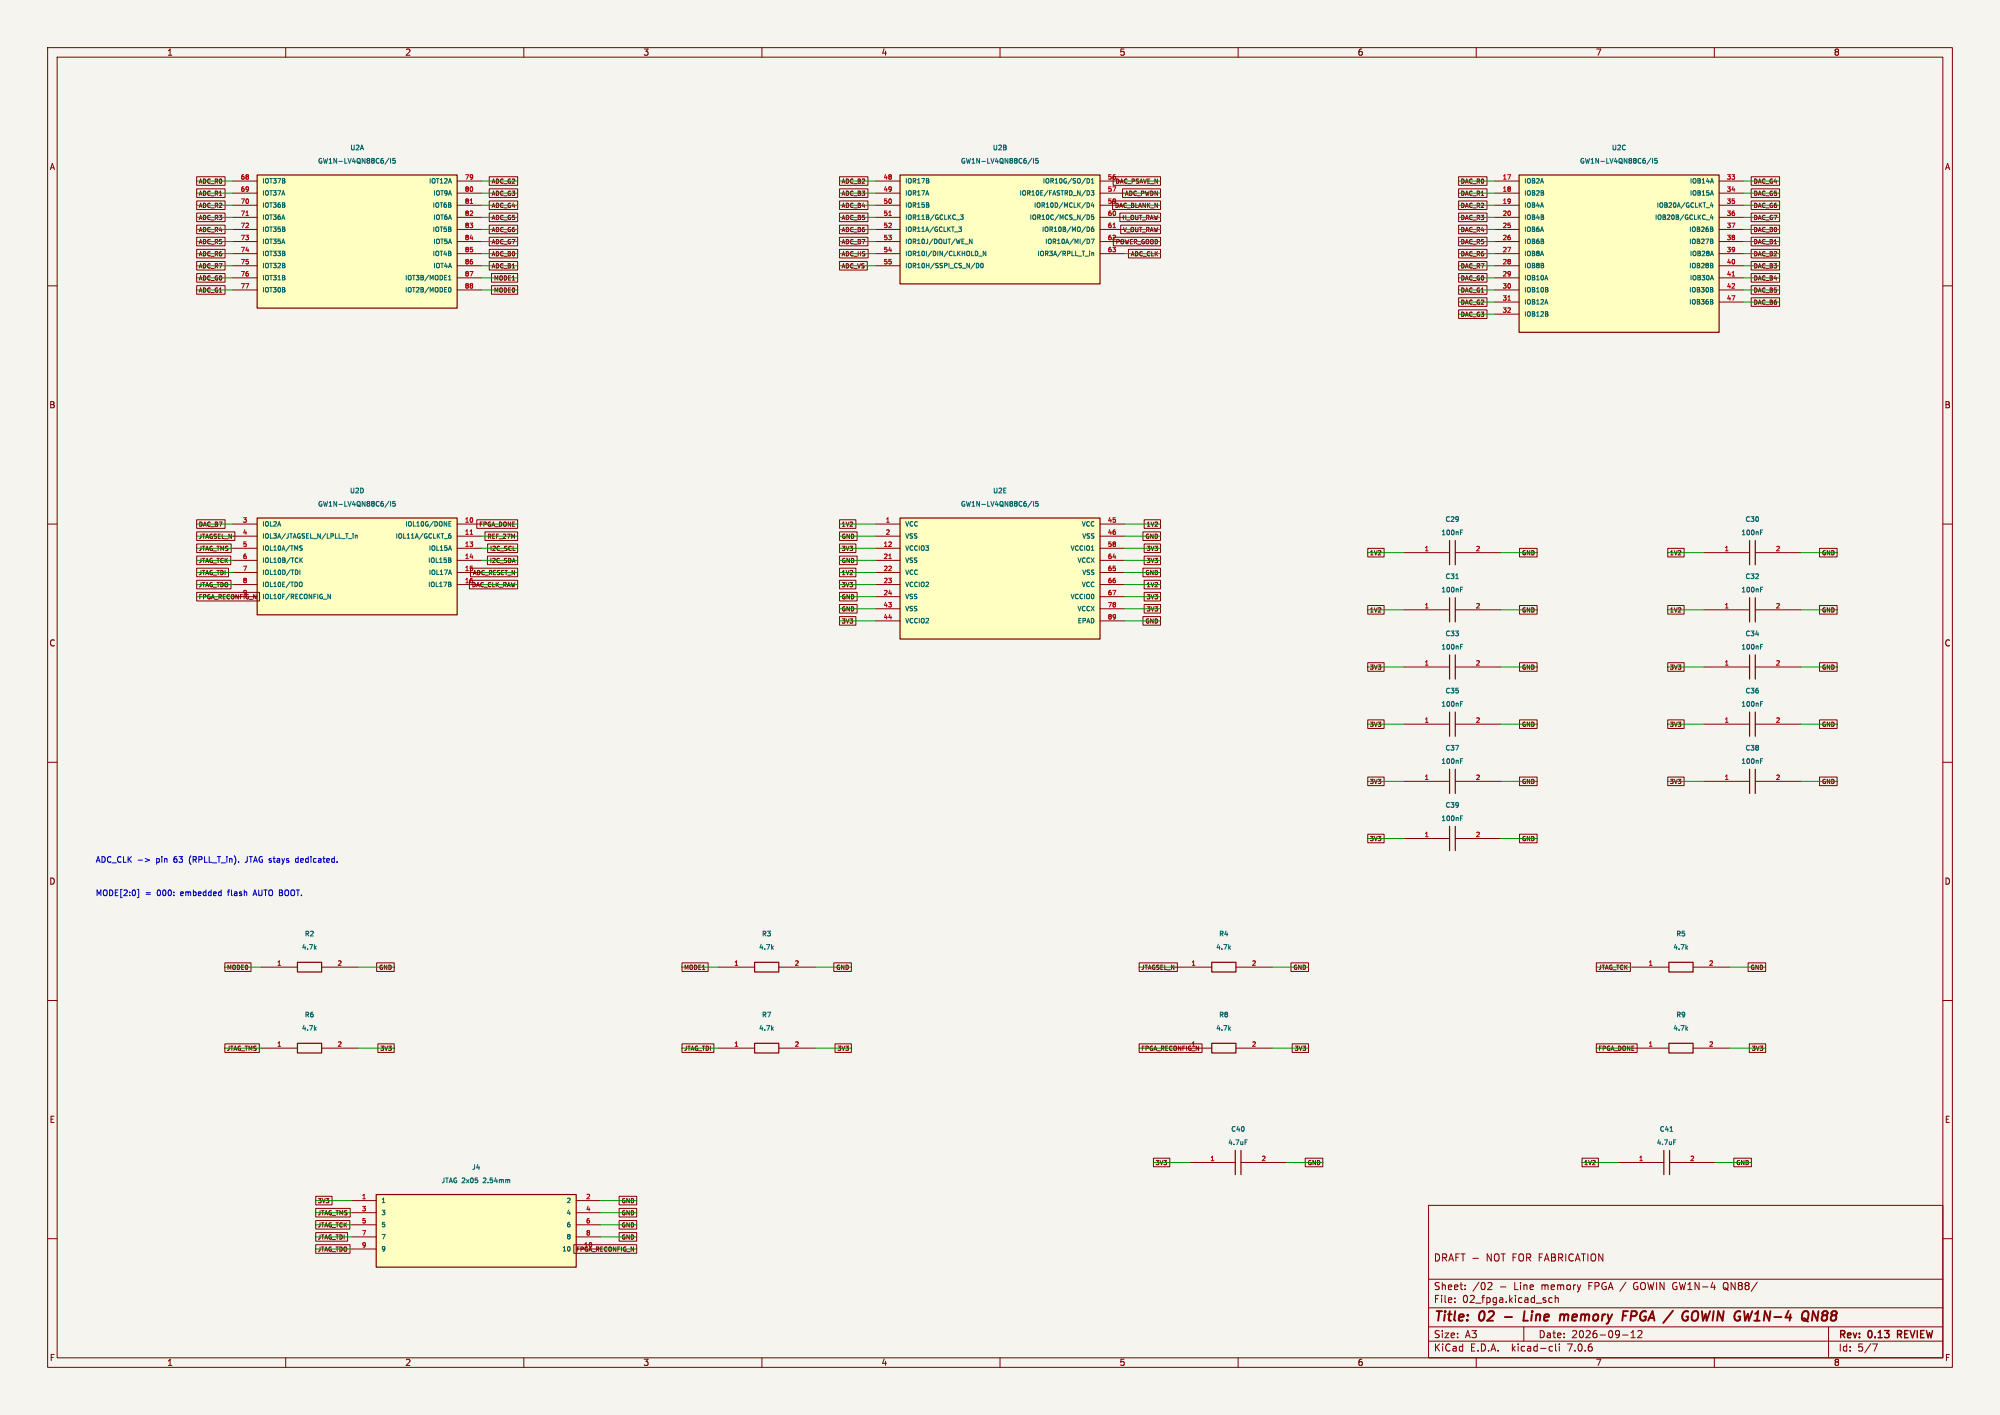
[picture p13: page 5]

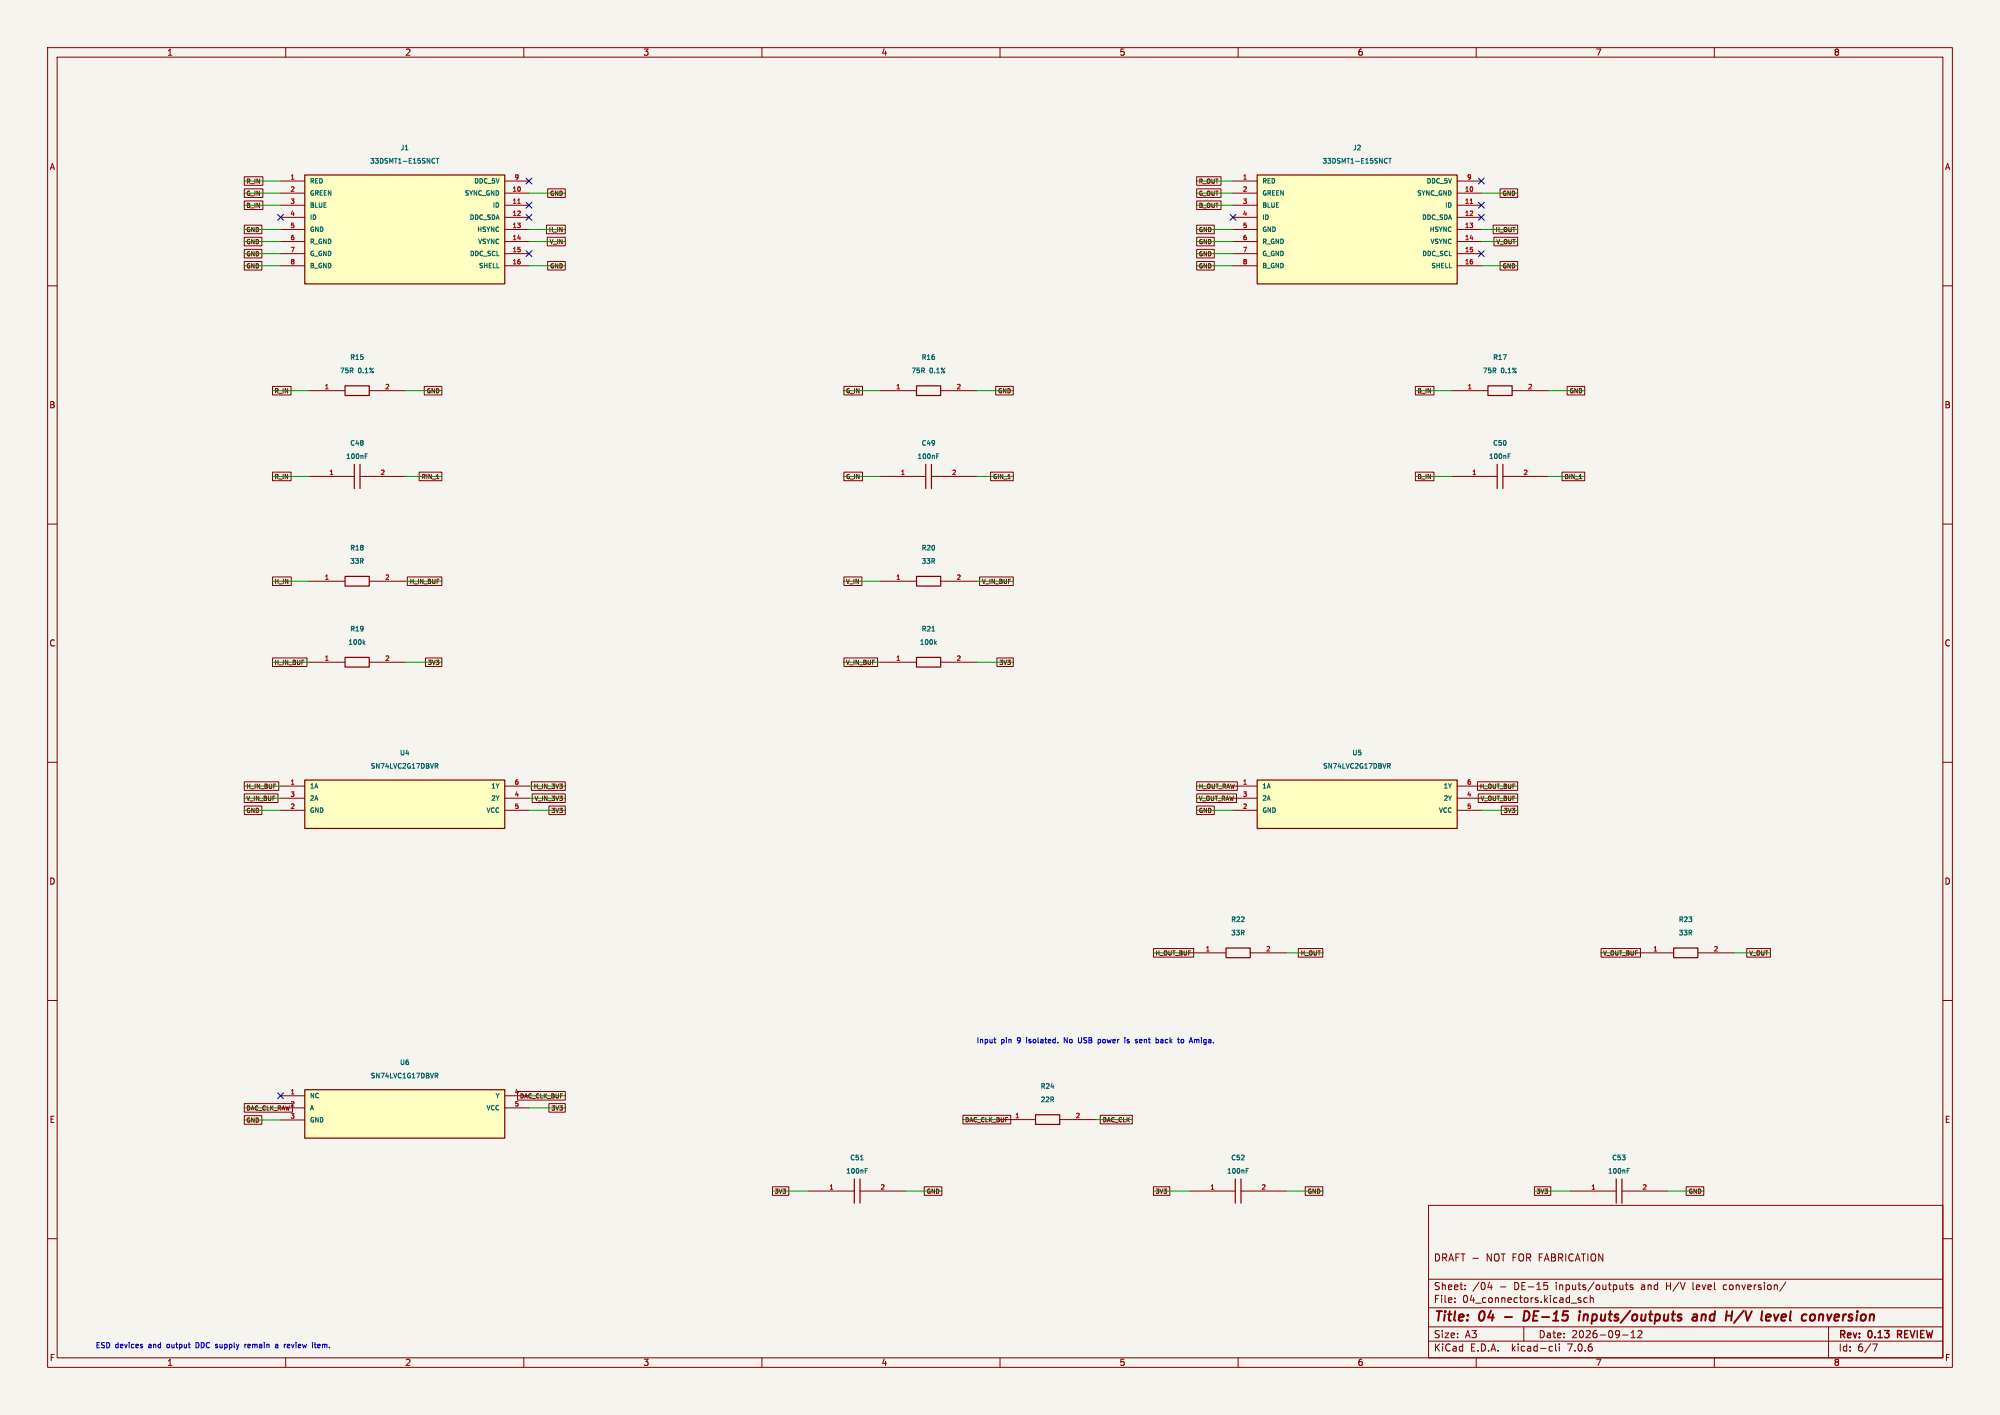
[picture p14: page 6]

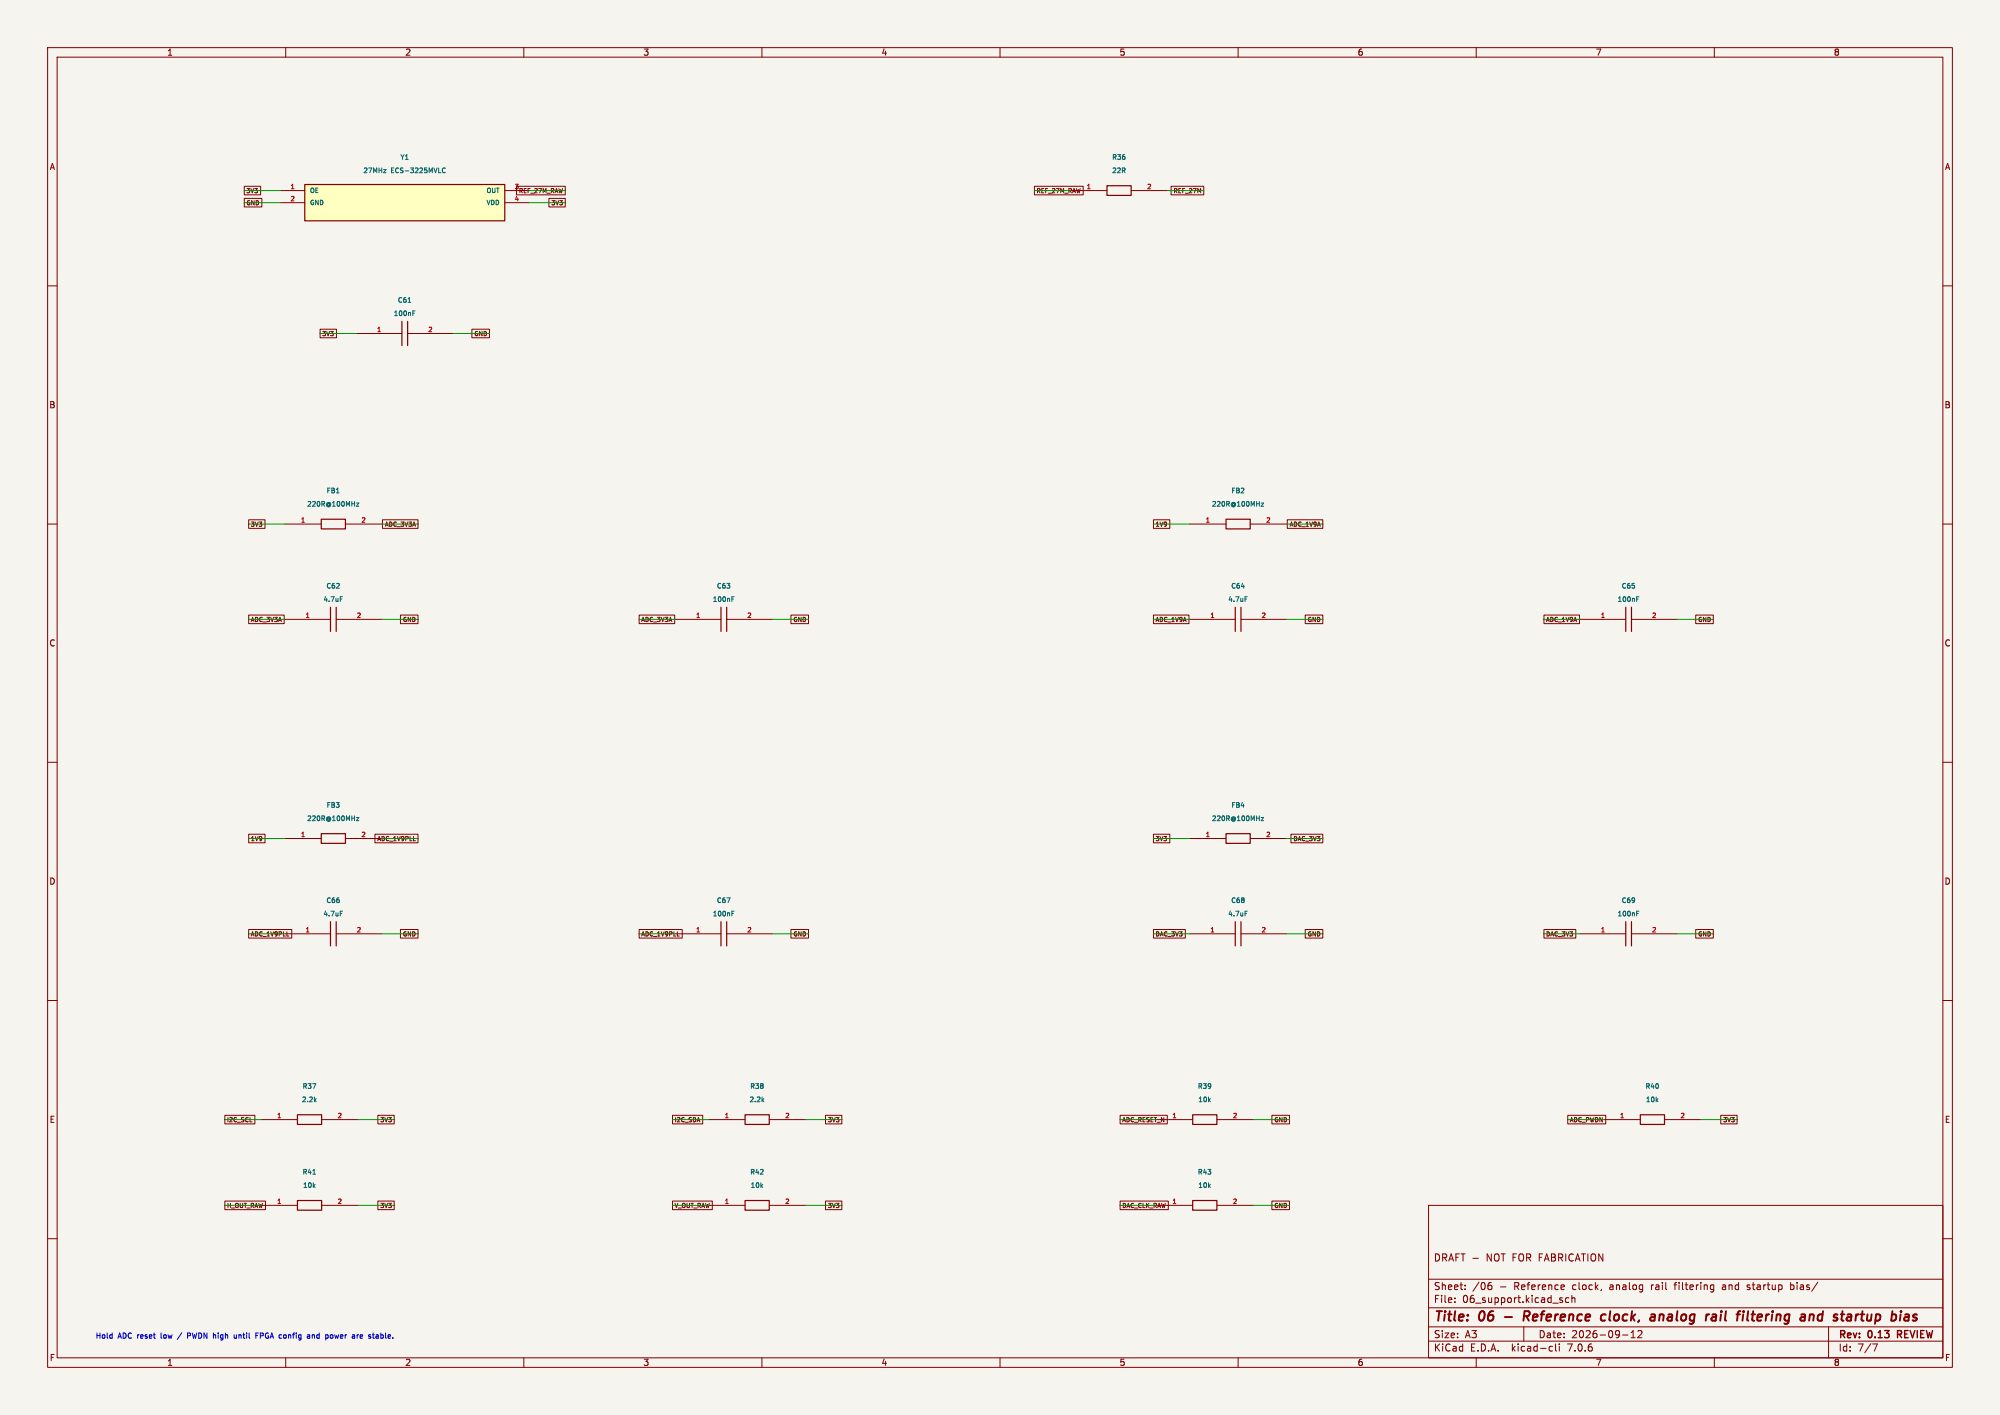
[picture p15: page 7]

3V3 Hold ADC reset low / PWDN high until FPGA config and power are stable.

Id: 7/7 Title: 06 - Reference clock, analog rail filtering and startup bias
