110-kenichi/A1200LineDoubler/outputs/amiga_scandoubler/hardware/amiga_scandoubler_v030wip.kicad_pcb

## KiCad design outputs/amiga_scandoubler/hardware/amiga_scandoubler_v030wip.kicad_pcb (2026-10-01)

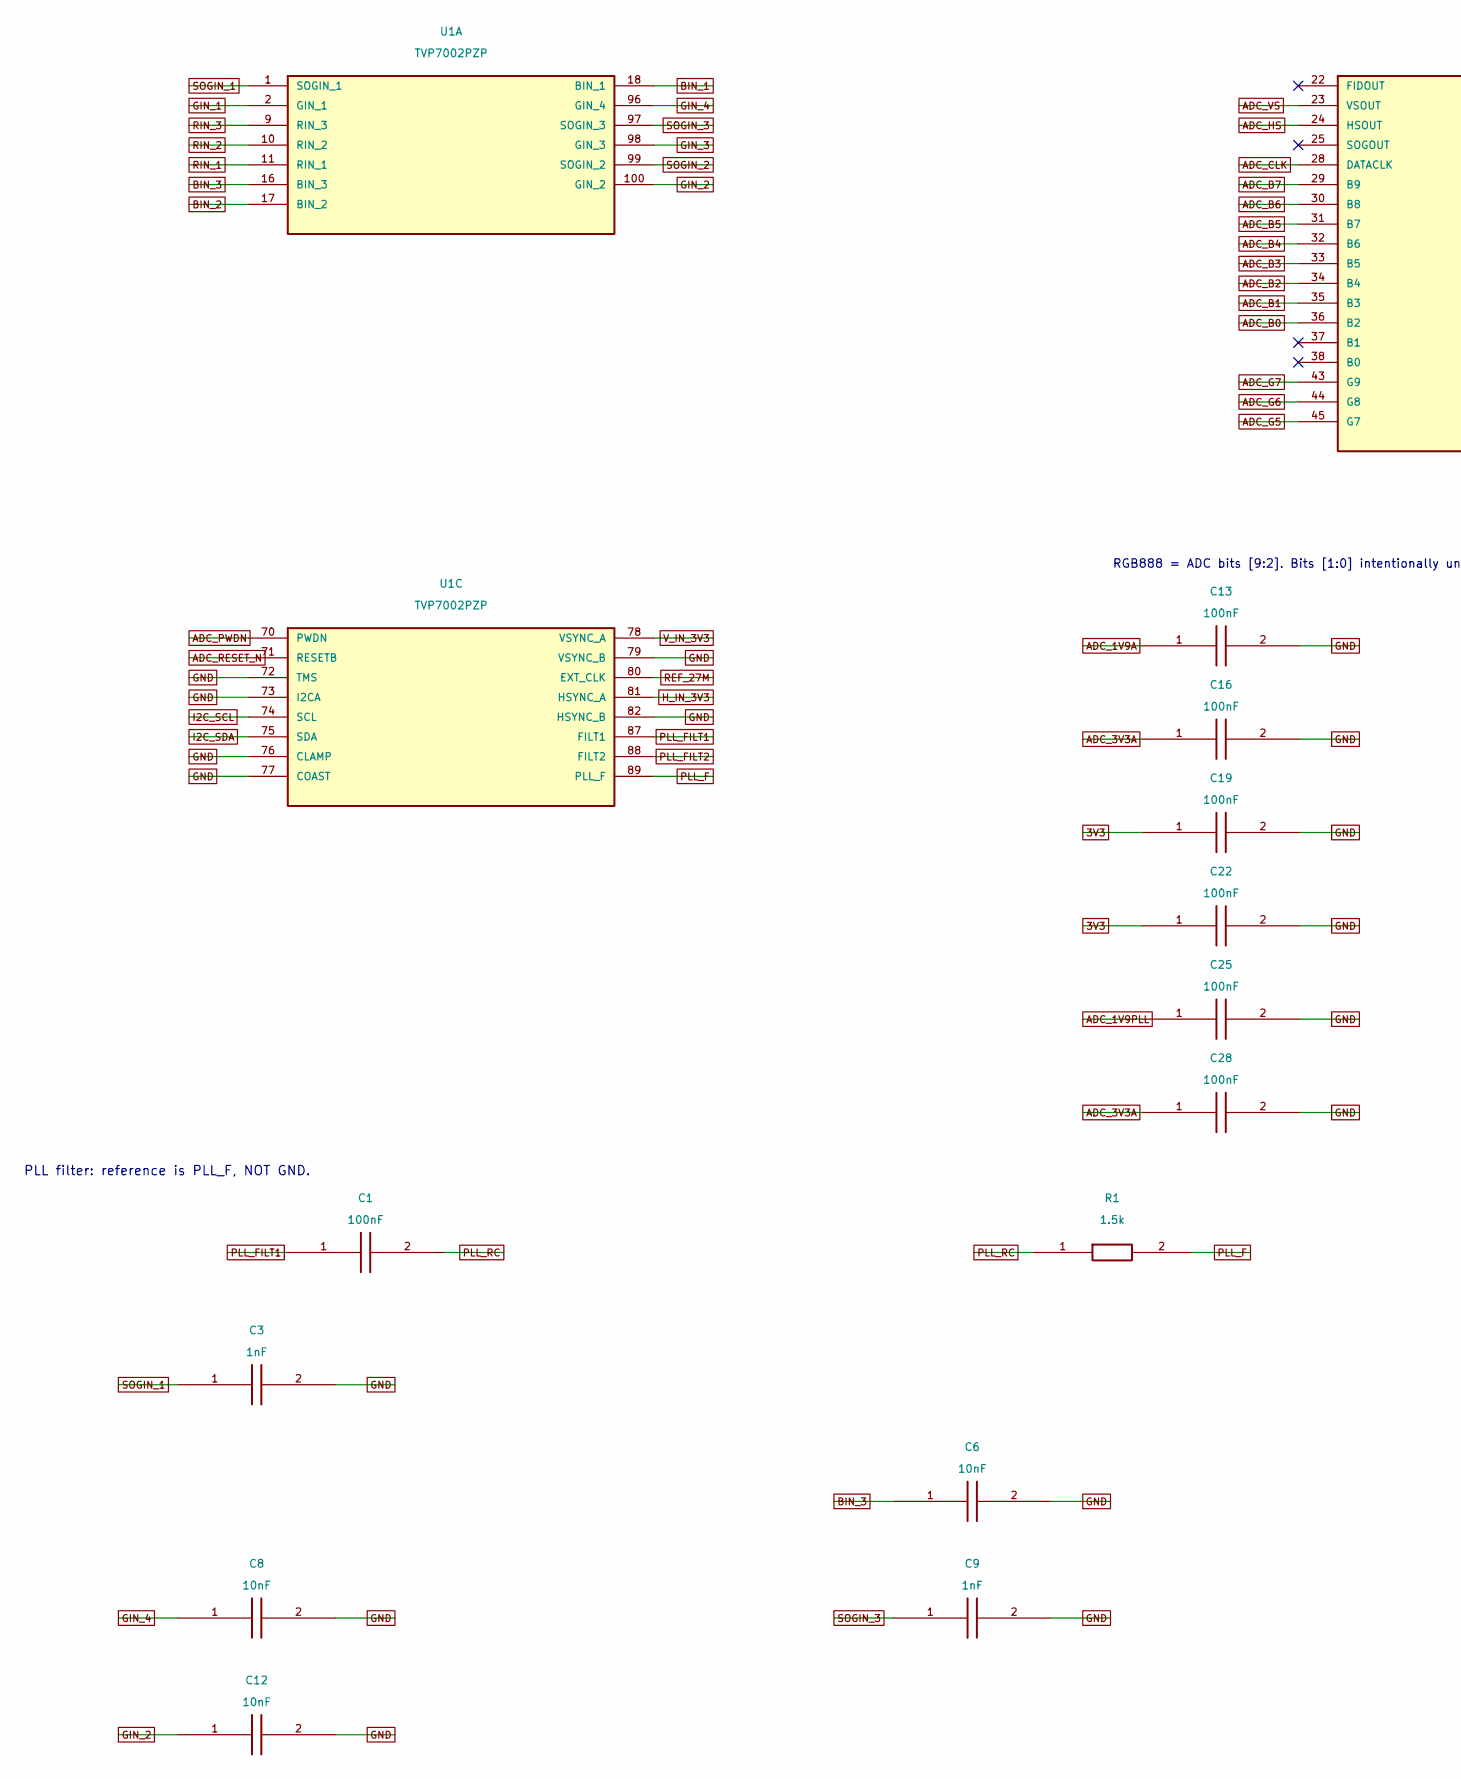
[picture p16: schematic 01_adc.kicad_sch, 01 - RGB digitizer / TVP7002PZP, part in row 1, column 1]

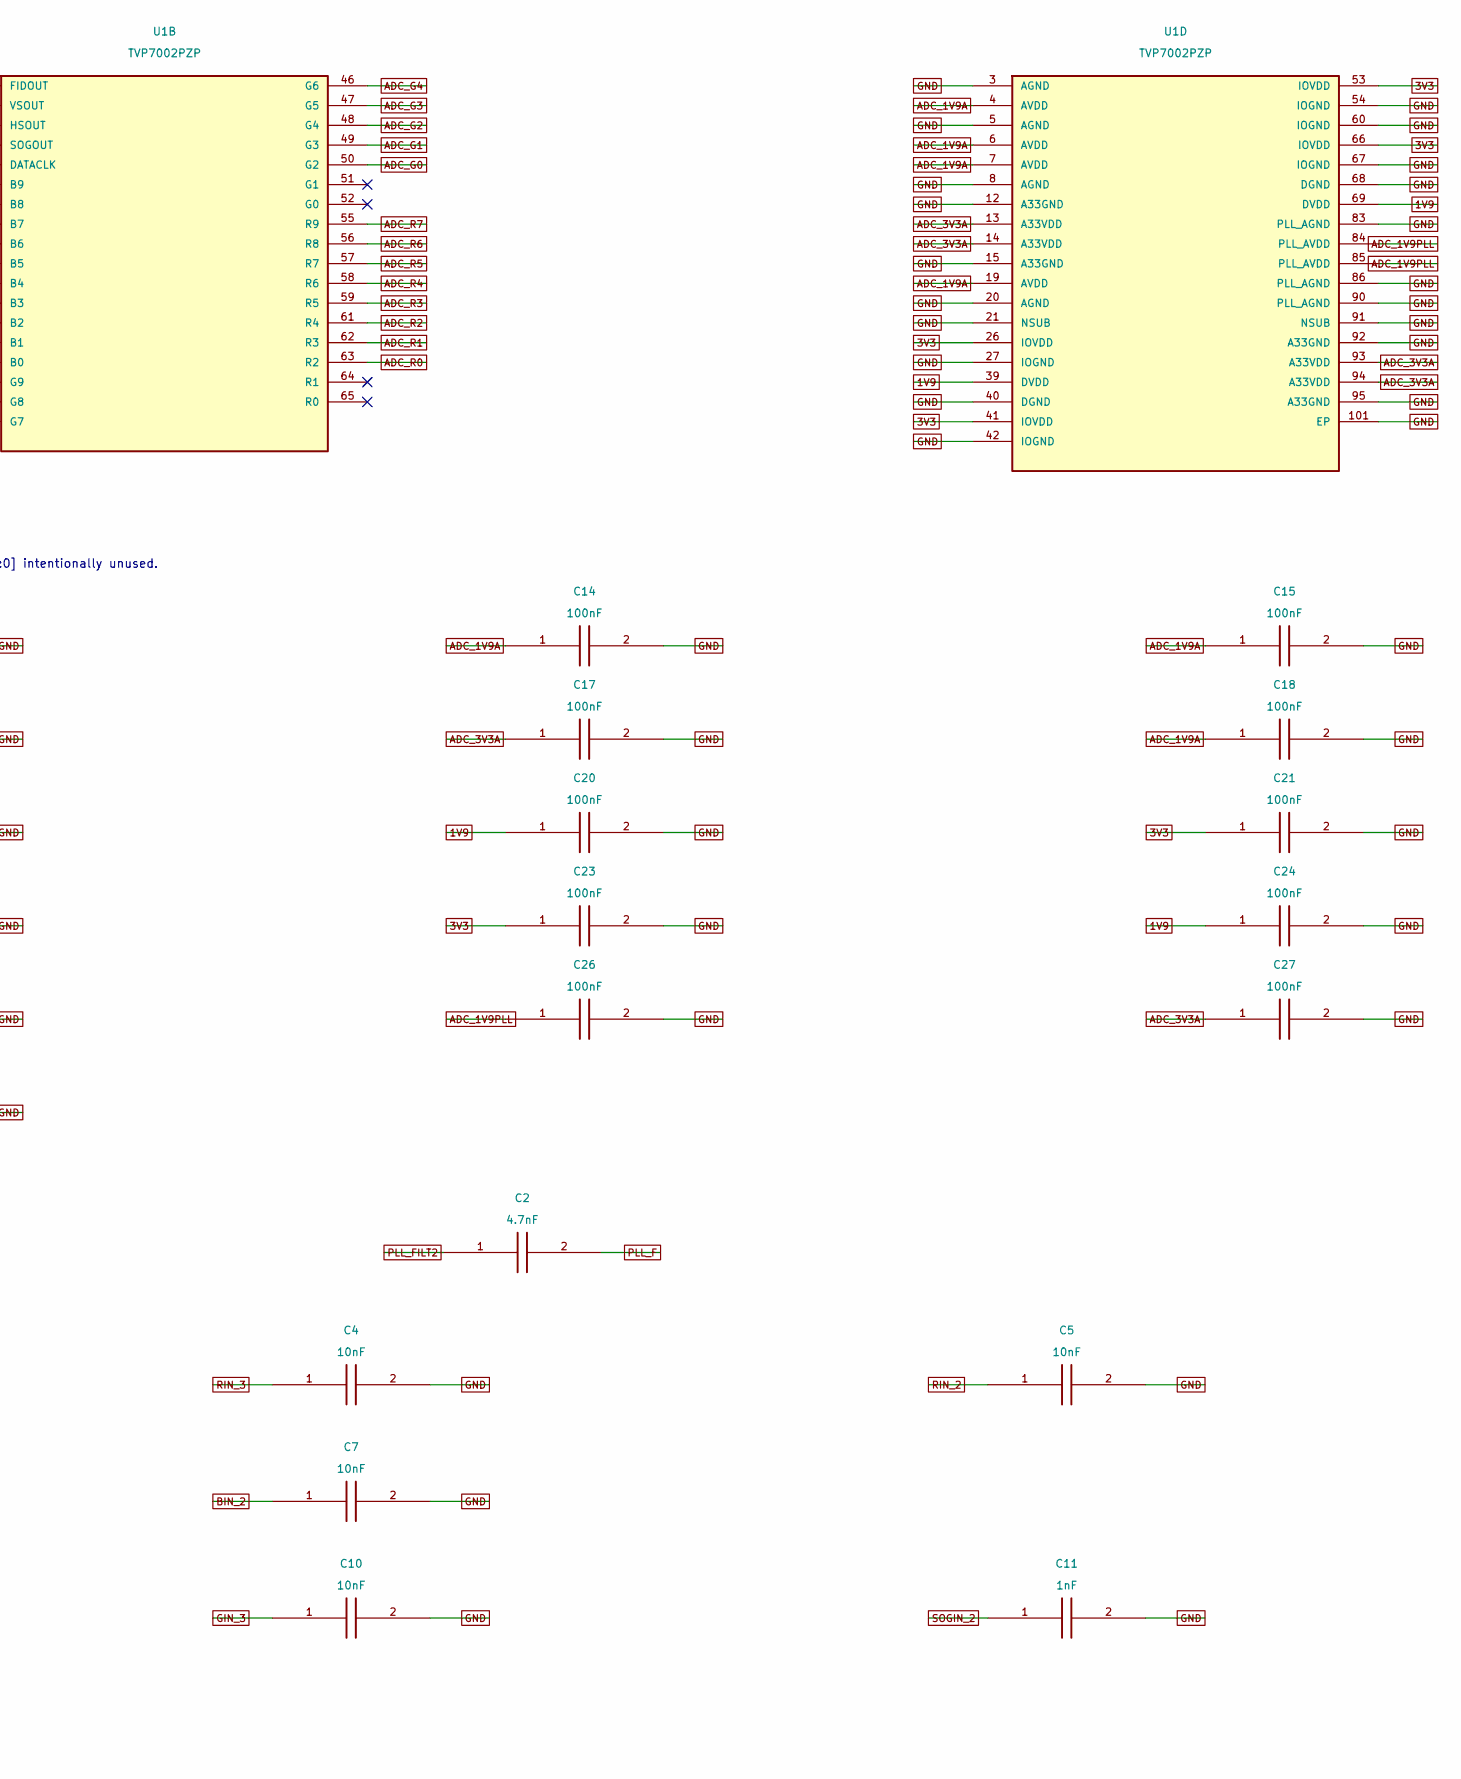
[picture p17: schematic 01_adc.kicad_sch, 01 - RGB digitizer / TVP7002PZP, part in row 1, column 2]

Parts:
C1, C13, C14, C15, C16, C17, C18, C19, C20, C21, C22, C23, C24, C25, C26, C27, C28: 100nF; C_0603_1608Metric; MPN CC0603KRX7R9BB104; LCSC C14663
C2: 4.7nF; C_0603_1608Metric; MPN CC0603JRNPO9BN472; LCSC C576818
C3, C9, C11: 1nF; C_0603_1608Metric; MPN CC0603JRNPO9BN102; LCSC C106246
C4, C5, C6, C7, C8, C10, C12: 10nF; C_0603_1608Metric; MPN GRM1885C1H103JA01D; LCSC C85973
R1: 1.5k; R_0603_1608Metric; MPN 0603WAF1501T5E; LCSC C22843
U1: TVP7002PZP; TQFP-100_TVP7002_14x14_P0.5_EP6.2; MPN TVP7002PZP; LCSC C3824085

Connections:
1V9: C20.1, C24.1, U1.39 (DVDD), U1.69 (DVDD); also elsewhere on the board
3V3: C19.1, C21.1, C22.1, C23.1, U1.26 (IOVDD), U1.41 (IOVDD), U1.53 (IOVDD), U1.66 (IOVDD); also elsewhere on the board
ADC_1V9A: C13.1, C14.1, C15.1, C18.1, U1.4 (AVDD), U1.6 (AVDD), U1.7 (AVDD), U1.19 (AVDD); also elsewhere on the board
ADC_1V9PLL: C25.1, C26.1, U1.84 (PLL_AVDD), U1.85 (PLL_AVDD); also elsewhere on the board
ADC_3V3A: C16.1, C17.1, C27.1, C28.1, U1.13 (A33VDD), U1.14 (A33VDD), U1.93 (A33VDD), U1.94 (A33VDD); also elsewhere on the board
ADC_B0: U1.36 (B2); also elsewhere on the board
ADC_B1: U1.35 (B3); also elsewhere on the board
ADC_B2: U1.34 (B4); also elsewhere on the board
ADC_B3: U1.33 (B5); also elsewhere on the board
ADC_B4: U1.32 (B6); also elsewhere on the board
ADC_B5: U1.31 (B7); also elsewhere on the board
ADC_B6: U1.30 (B8); also elsewhere on the board
ADC_B7: U1.29 (B9); also elsewhere on the board
ADC_CLK: U1.28 (DATACLK); also elsewhere on the board
ADC_G0: U1.50 (G2); also elsewhere on the board
ADC_G1: U1.49 (G3); also elsewhere on the board
ADC_G2: U1.48 (G4); also elsewhere on the board
ADC_G3: U1.47 (G5); also elsewhere on the board
ADC_G4: U1.46 (G6); also elsewhere on the board
ADC_G5: U1.45 (G7); also elsewhere on the board
ADC_G6: U1.44 (G8); also elsewhere on the board
ADC_G7: U1.43 (G9); also elsewhere on the board
ADC_HS: U1.24 (HSOUT); also elsewhere on the board
ADC_PWDN: U1.70 (PWDN); also elsewhere on the board
ADC_R0: U1.63 (R2); also elsewhere on the board
ADC_R1: U1.62 (R3); also elsewhere on the board
ADC_R2: U1.61 (R4); also elsewhere on the board
ADC_R3: U1.59 (R5); also elsewhere on the board
ADC_R4: U1.58 (R6); also elsewhere on the board
ADC_R5: U1.57 (R7); also elsewhere on the board
ADC_R6: U1.56 (R8); also elsewhere on the board
ADC_R7: U1.55 (R9); also elsewhere on the board
ADC_RESET_N: U1.71 (RESETB); also elsewhere on the board
ADC_VS: U1.23 (VSOUT); also elsewhere on the board
BIN_1: U1.18 (BIN_1); also elsewhere on the board
BIN_2: C7.1, U1.17 (BIN_2)
BIN_3: C6.1, U1.16 (BIN_3)
GIN_1: U1.2 (GIN_1); also elsewhere on the board
GIN_2: C12.1, U1.100 (GIN_2)
GIN_3: C10.1, U1.98 (GIN_3)
GIN_4: C8.1, U1.96 (GIN_4)
GND: C3.2, C4.2, C5.2, C6.2, C7.2, C8.2, C9.2, C10.2, C11.2, C12.2, C13.2, C14.2, C15.2, C16.2, C17.2, C18.2, C19.2, C20.2, C21.2, C22.2, C23.2, C24.2, C25.2, C26.2, C27.2, C28.2, U1.3 (AGND), U1.5 (AGND), U1.8 (AGND), U1.12 (A33GND), U1.15 (A33GND), U1.20 (AGND), U1.21 (NSUB), U1.27 (IOGND), U1.40 (DGND), U1.42 (IOGND), U1.54 (IOGND), U1.60 (IOGND), U1.67 (IOGND), U1.68 (DGND), U1.72 (TMS), U1.73 (I2CA), U1.76 (CLAMP), U1.77 (COAST), U1.79 (VSYNC_B), U1.82 (HSYNC_B), U1.83 (PLL_AGND), U1.86 (PLL_AGND), U1.90 (PLL_AGND), U1.91 (NSUB), U1.92 (A33GND), U1.95 (A33GND), U1.101 (EP); also elsewhere on the board
H_IN_3V3: U1.81 (HSYNC_A); also elsewhere on the board
I2C_SCL: U1.74 (SCL); also elsewhere on the board
I2C_SDA: U1.75 (SDA); also elsewhere on the board
PLL_F: C2.2, R1.2, U1.89 (PLL_F)
PLL_FILT1: C1.1, U1.87 (FILT1)
PLL_FILT2: C2.1, U1.88 (FILT2)
PLL_RC: C1.2, R1.1
REF_27M: U1.80 (EXT_CLK); also elsewhere on the board
RIN_1: U1.11 (RIN_1); also elsewhere on the board
RIN_2: C5.1, U1.10 (RIN_2)
RIN_3: C4.1, U1.9 (RIN_3)
SOGIN_1: C3.1, U1.1 (SOGIN_1)
SOGIN_2: C11.1, U1.99 (SOGIN_2)
SOGIN_3: C9.1, U1.97 (SOGIN_3)
V_IN_3V3: U1.78 (VSYNC_A); also elsewhere on the board

Notes on the sheet:
RGB888 = ADC bits [9:2]. Bits [1:0] intentionally unused.
PLL filter: reference is PLL_F, NOT GND.

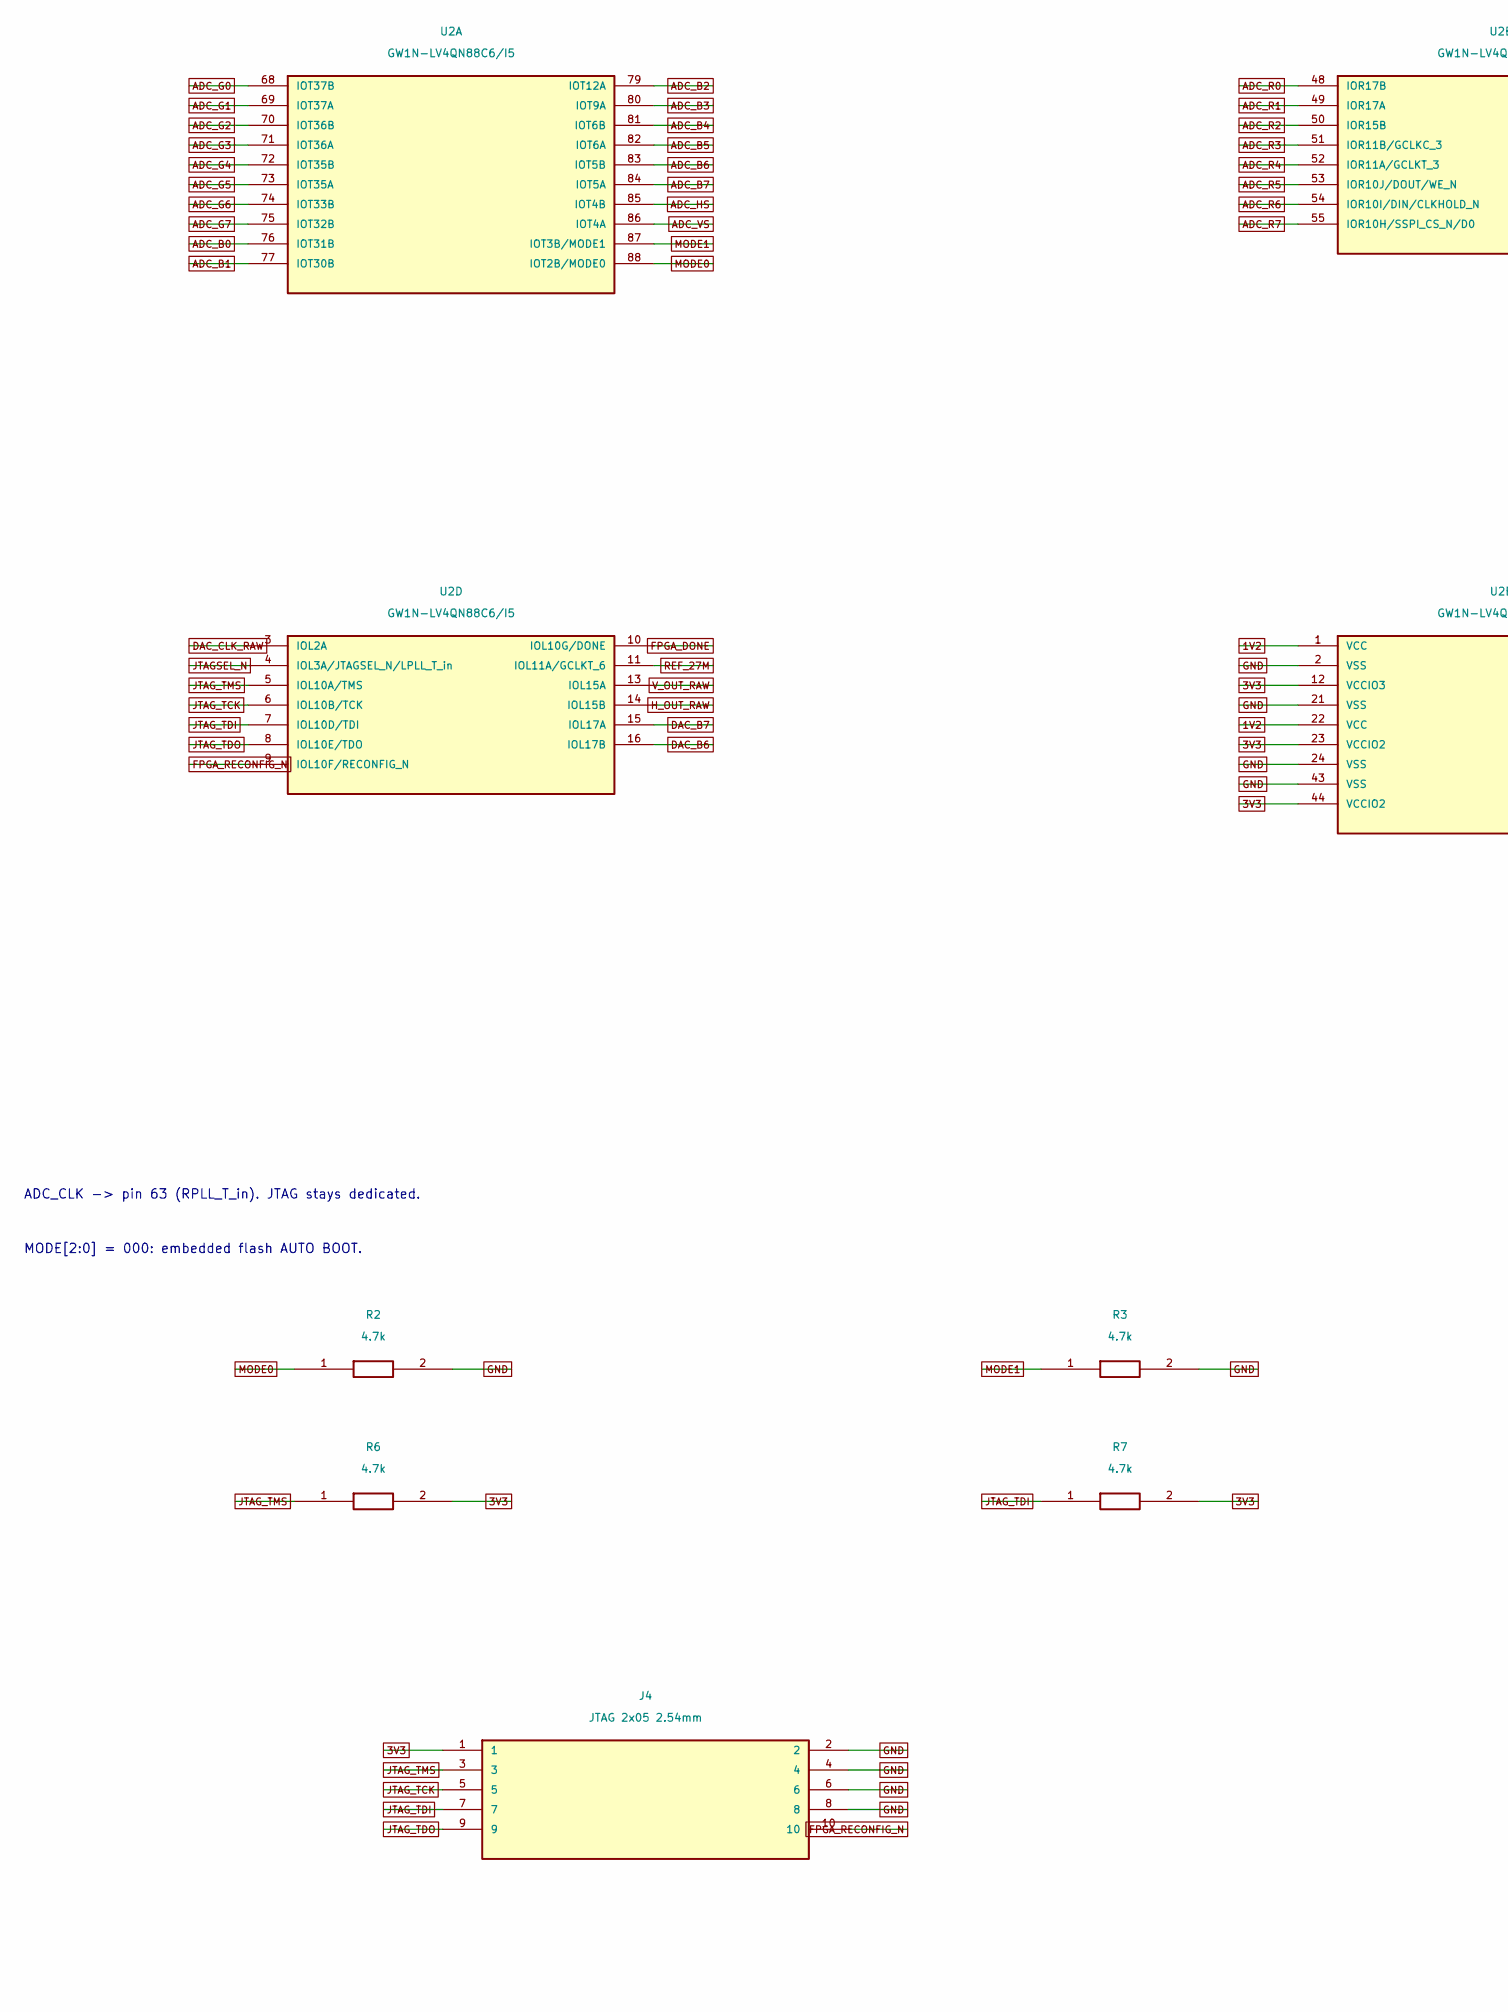
[picture p18: schematic 02_fpga.kicad_sch, 02 - Line memory FPGA / GOWIN GW1N-4 QN88, part in row 1, column 1]

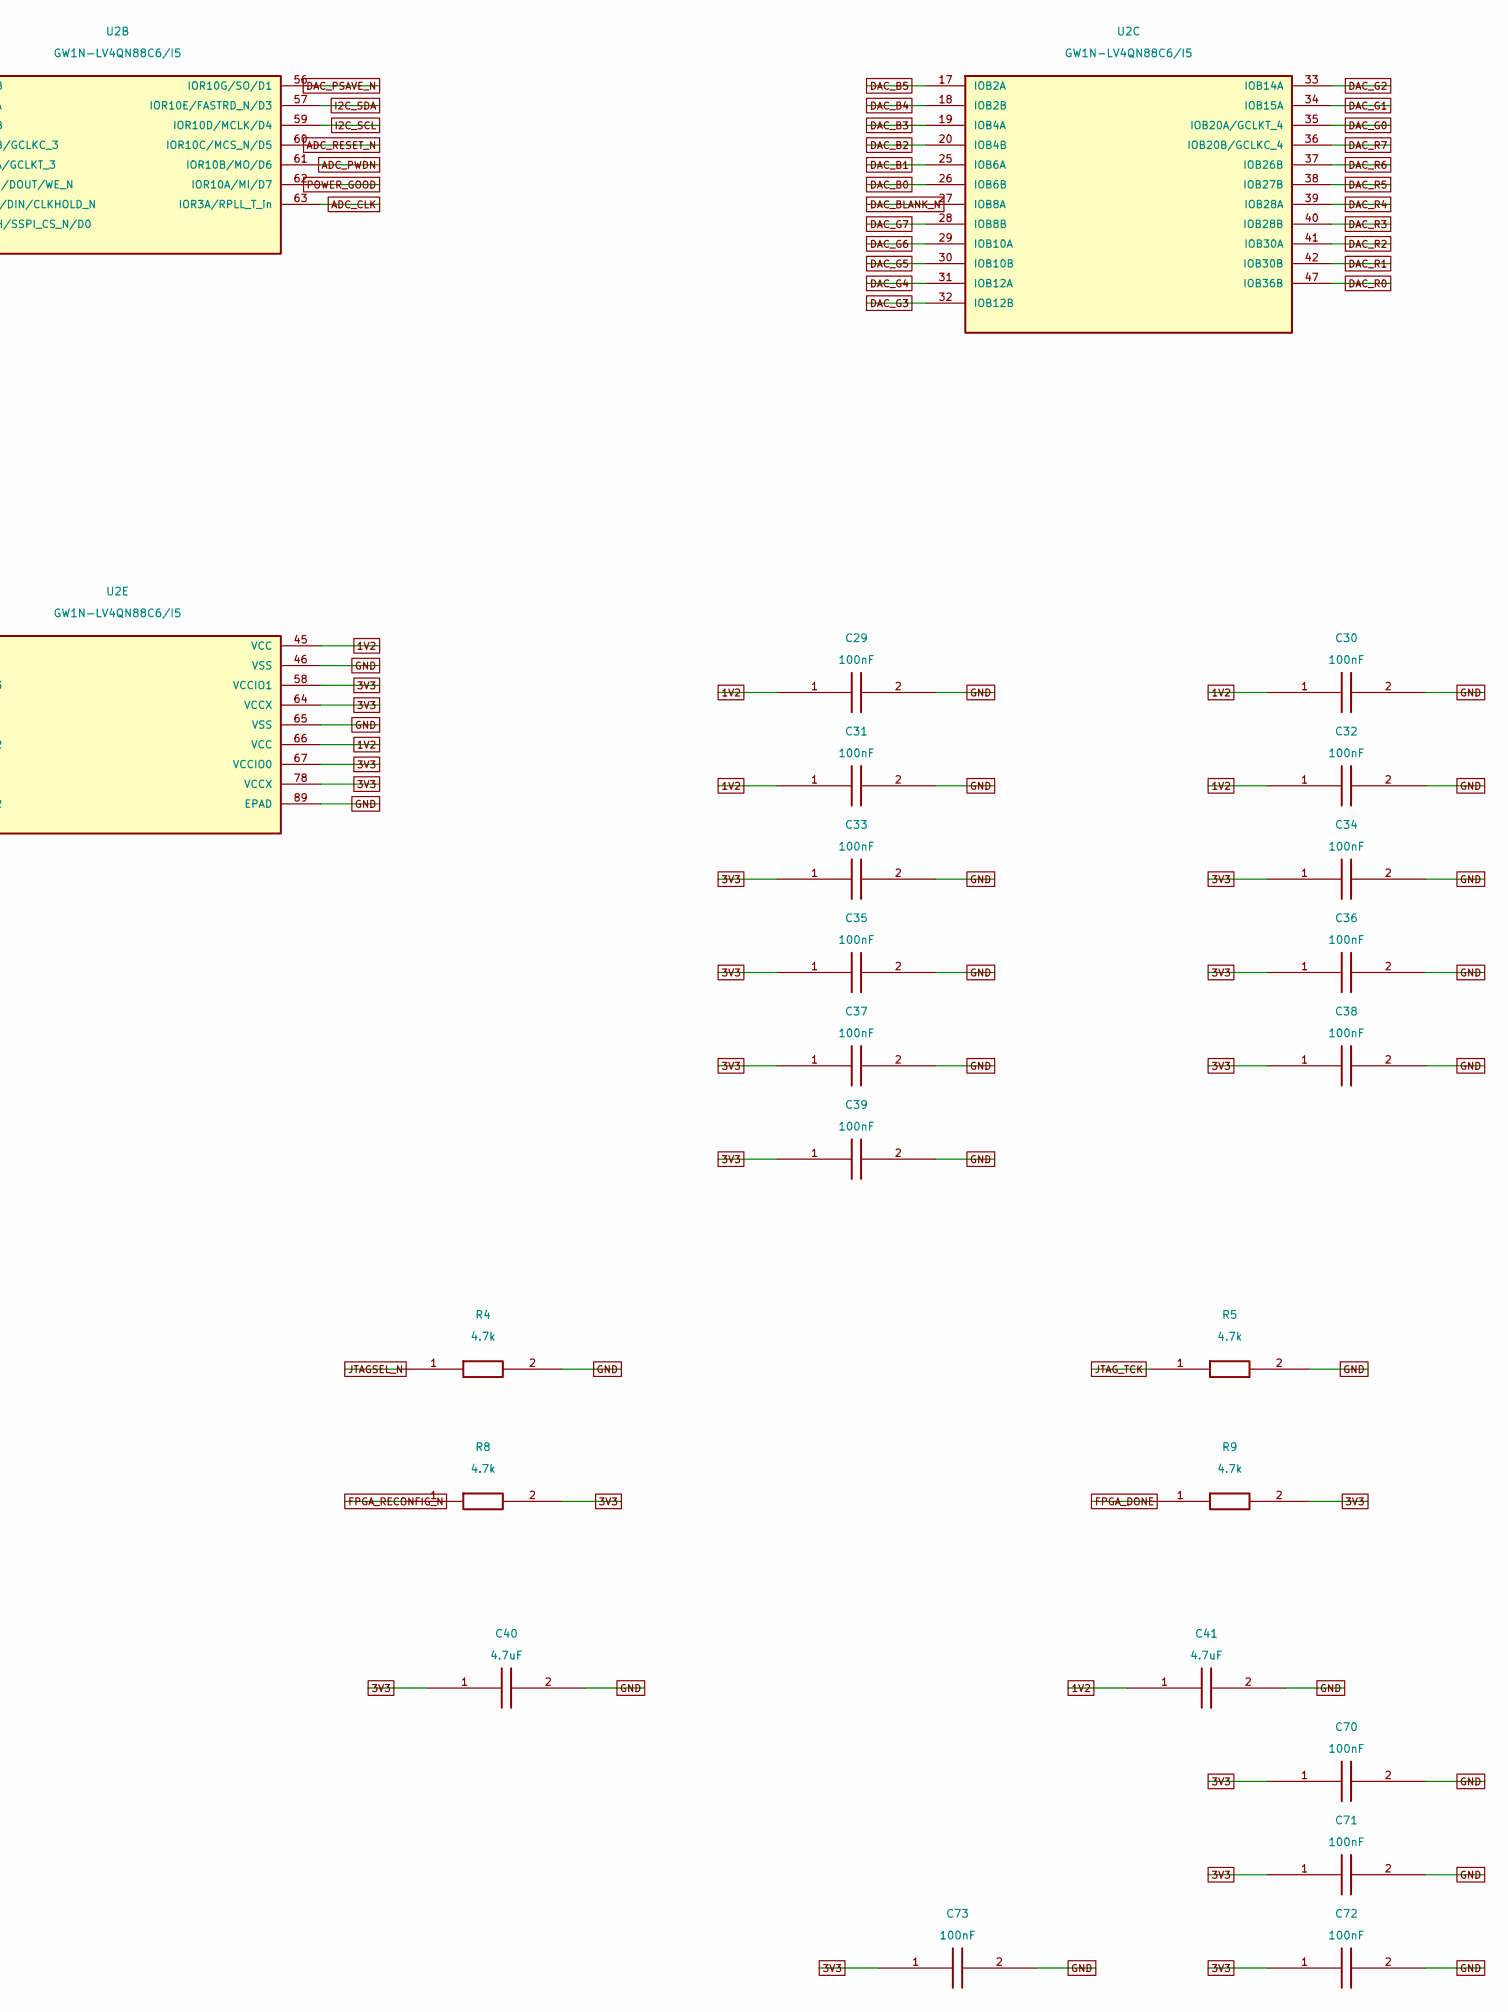
[picture p19: schematic 02_fpga.kicad_sch, 02 - Line memory FPGA / GOWIN GW1N-4 QN88, part in row 1, column 2]

Parts:
C29, C30, C31, C32, C33, C34, C35, C36, C37, C38, C39: 100nF; C_0603_1608Metric; MPN CC0603KRX7R9BB104; LCSC C14663
C40, C41: 4.7uF; C_0805_2012Metric; MPN CL21A475KAQNNNE; LCSC C1779
C70, C71, C72, C73: 100nF; C_0402_1005Metric; MPN CL05B104KO5NNNC; LCSC C1525
J4: JTAG 2x05 2.54mm; PinHeader_2x05_P2.54mm_Vertical_SMD; MPN HX PZ2.54-2x5P TP; LCSC C32713285
R2, R3, R4, R5, R6, R7, R8, R9: 4.7k; R_0603_1608Metric; MPN 0603WAF4701T5E; LCSC C23162
U2: GW1N-LV4QN88C6/I5; QFN-88_GW1N4_10x10_P0.4_EP6.8; MPN GW1N-LV4QN88C6/I5; LCSC C31900351

Connections:
1V2: C29.1, C30.1, C31.1, C32.1, C41.1, U2.1 (VCC), U2.22 (VCC), U2.45 (VCC), U2.66 (VCC); also elsewhere on the board
3V3: C33.1, C34.1, C35.1, C36.1, C37.1, C38.1, C39.1, C40.1, C70.1, C71.1, C72.1, C73.1, J4.1, R6.2, R7.2, R8.2, R9.2, U2.12 (VCCIO3), U2.23 (VCCIO2), U2.44 (VCCIO2), U2.58 (VCCIO1), U2.64 (VCCX), U2.67 (VCCIO0), U2.78 (VCCX); also elsewhere on the board
ADC_B0: U2.76 (IOT31B); also elsewhere on the board
ADC_B1: U2.77 (IOT30B); also elsewhere on the board
ADC_B2: U2.79 (IOT12A); also elsewhere on the board
ADC_B3: U2.80 (IOT9A); also elsewhere on the board
ADC_B4: U2.81 (IOT6B); also elsewhere on the board
ADC_B5: U2.82 (IOT6A); also elsewhere on the board
ADC_B6: U2.83 (IOT5B); also elsewhere on the board
ADC_B7: U2.84 (IOT5A); also elsewhere on the board
ADC_CLK: U2.63 (IOR3A/RPLL_T_in); also elsewhere on the board
ADC_G0: U2.68 (IOT37B); also elsewhere on the board
ADC_G1: U2.69 (IOT37A); also elsewhere on the board
ADC_G2: U2.70 (IOT36B); also elsewhere on the board
ADC_G3: U2.71 (IOT36A); also elsewhere on the board
ADC_G4: U2.72 (IOT35B); also elsewhere on the board
ADC_G5: U2.73 (IOT35A); also elsewhere on the board
ADC_G6: U2.74 (IOT33B); also elsewhere on the board
ADC_G7: U2.75 (IOT32B); also elsewhere on the board
ADC_HS: U2.85 (IOT4B); also elsewhere on the board
ADC_PWDN: U2.61 (IOR10B/MO/D6); also elsewhere on the board
ADC_R0: U2.48 (IOR17B); also elsewhere on the board
ADC_R1: U2.49 (IOR17A); also elsewhere on the board
ADC_R2: U2.50 (IOR15B); also elsewhere on the board
ADC_R3: U2.51 (IOR11B/GCLKC_3); also elsewhere on the board
ADC_R4: U2.52 (IOR11A/GCLKT_3); also elsewhere on the board
ADC_R5: U2.53 (IOR10J/DOUT/WE_N); also elsewhere on the board
ADC_R6: U2.54 (IOR10I/DIN/CLKHOLD_N); also elsewhere on the board
ADC_R7: U2.55 (IOR10H/SSPI_CS_N/D0); also elsewhere on the board
ADC_RESET_N: U2.60 (IOR10C/MCS_N/D5); also elsewhere on the board
ADC_VS: U2.86 (IOT4A); also elsewhere on the board
DAC_B0: U2.26 (IOB6B); also elsewhere on the board
DAC_B1: U2.25 (IOB6A); also elsewhere on the board
DAC_B2: U2.20 (IOB4B); also elsewhere on the board
DAC_B3: U2.19 (IOB4A); also elsewhere on the board
DAC_B4: U2.18 (IOB2B); also elsewhere on the board
DAC_B5: U2.17 (IOB2A); also elsewhere on the board
DAC_B6: U2.16 (IOL17B); also elsewhere on the board
DAC_B7: U2.15 (IOL17A); also elsewhere on the board
DAC_BLANK_N: U2.27 (IOB8A); also elsewhere on the board
DAC_CLK_RAW: U2.3 (IOL2A); also elsewhere on the board
DAC_G0: U2.35 (IOB20A/GCLKT_4); also elsewhere on the board
DAC_G1: U2.34 (IOB15A); also elsewhere on the board
DAC_G2: U2.33 (IOB14A); also elsewhere on the board
DAC_G3: U2.32 (IOB12B); also elsewhere on the board
DAC_G4: U2.31 (IOB12A); also elsewhere on the board
DAC_G5: U2.30 (IOB10B); also elsewhere on the board
DAC_G6: U2.29 (IOB10A); also elsewhere on the board
DAC_G7: U2.28 (IOB8B); also elsewhere on the board
DAC_PSAVE_N: U2.56 (IOR10G/SO/D1); also elsewhere on the board
DAC_R0: U2.47 (IOB36B); also elsewhere on the board
DAC_R1: U2.42 (IOB30B); also elsewhere on the board
DAC_R2: U2.41 (IOB30A); also elsewhere on the board
DAC_R3: U2.40 (IOB28B); also elsewhere on the board
DAC_R4: U2.39 (IOB28A); also elsewhere on the board
DAC_R5: U2.38 (IOB27B); also elsewhere on the board
DAC_R6: U2.37 (IOB26B); also elsewhere on the board
DAC_R7: U2.36 (IOB20B/GCLKC_4); also elsewhere on the board
FPGA_DONE: R9.1, U2.10 (IOL10G/DONE)
FPGA_RECONFIG_N: J4.10, R8.1, U2.9 (IOL10F/RECONFIG_N)
GND: C29.2, C30.2, C31.2, C32.2, C33.2, C34.2, C35.2, C36.2, C37.2, C38.2, C39.2, C40.2, C41.2, C70.2, C71.2, C72.2, C73.2, J4.2, J4.4, J4.6, J4.8, R2.2, R3.2, R4.2, R5.2, U2.2 (VSS), U2.21 (VSS), U2.24 (VSS), U2.43 (VSS), U2.46 (VSS), U2.65 (VSS), U2.89 (EPAD); also elsewhere on the board
H_OUT_RAW: U2.14 (IOL15B); also elsewhere on the board
I2C_SCL: U2.59 (IOR10D/MCLK/D4); also elsewhere on the board
I2C_SDA: U2.57 (IOR10E/FASTRD_N/D3); also elsewhere on the board
JTAGSEL_N: R4.1, U2.4 (IOL3A/JTAGSEL_N/LPLL_T_in)
JTAG_TCK: J4.5, R5.1, U2.6 (IOL10B/TCK)
JTAG_TDI: J4.7, R7.1, U2.7 (IOL10D/TDI)
JTAG_TDO: J4.9, U2.8 (IOL10E/TDO)
JTAG_TMS: J4.3, R6.1, U2.5 (IOL10A/TMS)
MODE0: R2.1, U2.88 (IOT2B/MODE0)
MODE1: R3.1, U2.87 (IOT3B/MODE1)
POWER_GOOD: U2.62 (IOR10A/MI/D7); also elsewhere on the board
REF_27M: U2.11 (IOL11A/GCLKT_6); also elsewhere on the board
V_OUT_RAW: U2.13 (IOL15A); also elsewhere on the board

Notes on the sheet:
ADC_CLK -> pin 63 (RPLL_T_in). JTAG stays dedicated.
MODE[2:0] = 000: embedded flash AUTO BOOT.
