110-kenichi/A1200LineDoubler/outputs/amiga_scandoubler/hardware/amiga_scandoubler_v030wip.kicad_pcb

## KiCad design outputs/amiga_scandoubler/hardware/amiga_scandoubler_v030wip.kicad_pcb (continued)

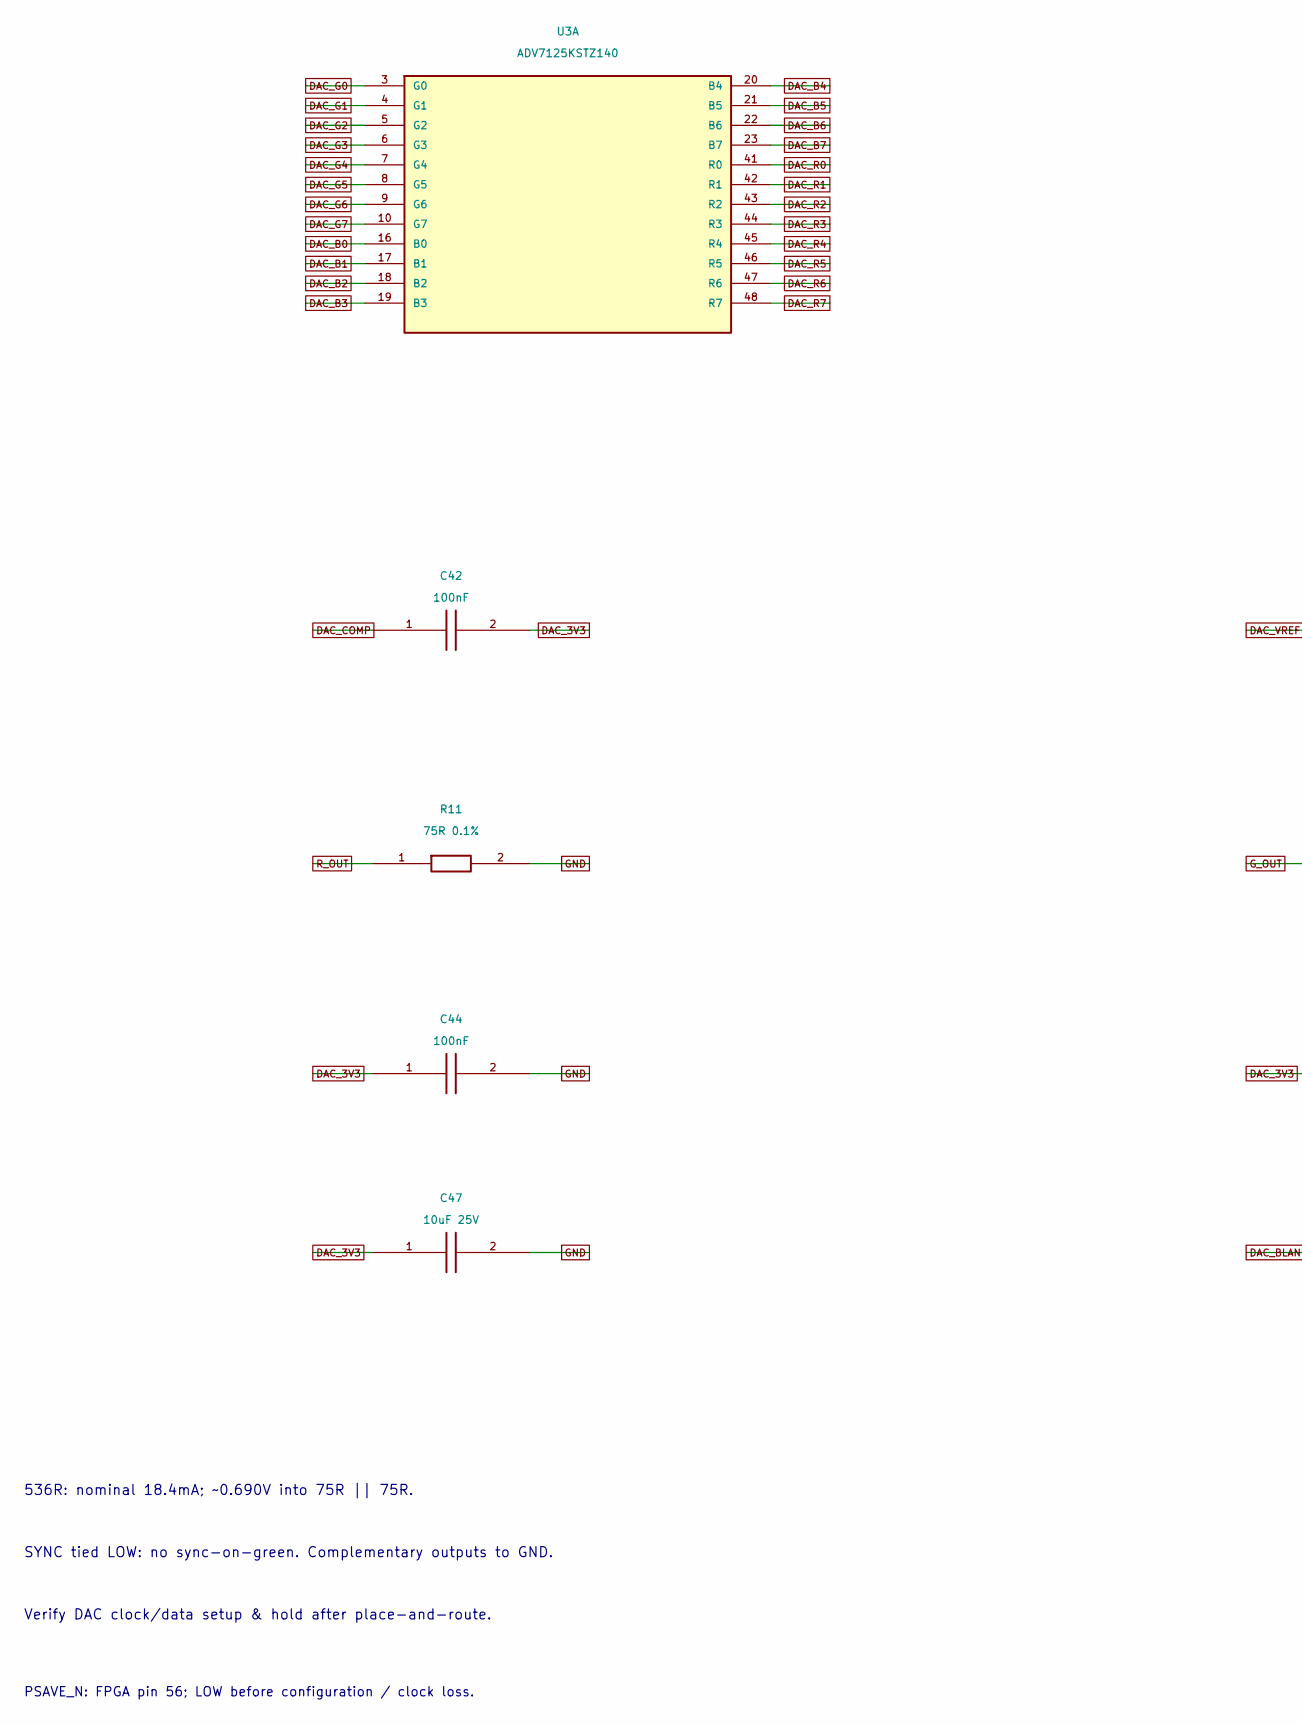
[picture p20: schematic 03_dac.kicad_sch, 03 - RGB DAC / ADV7125KSTZ140, part in row 1, column 1]

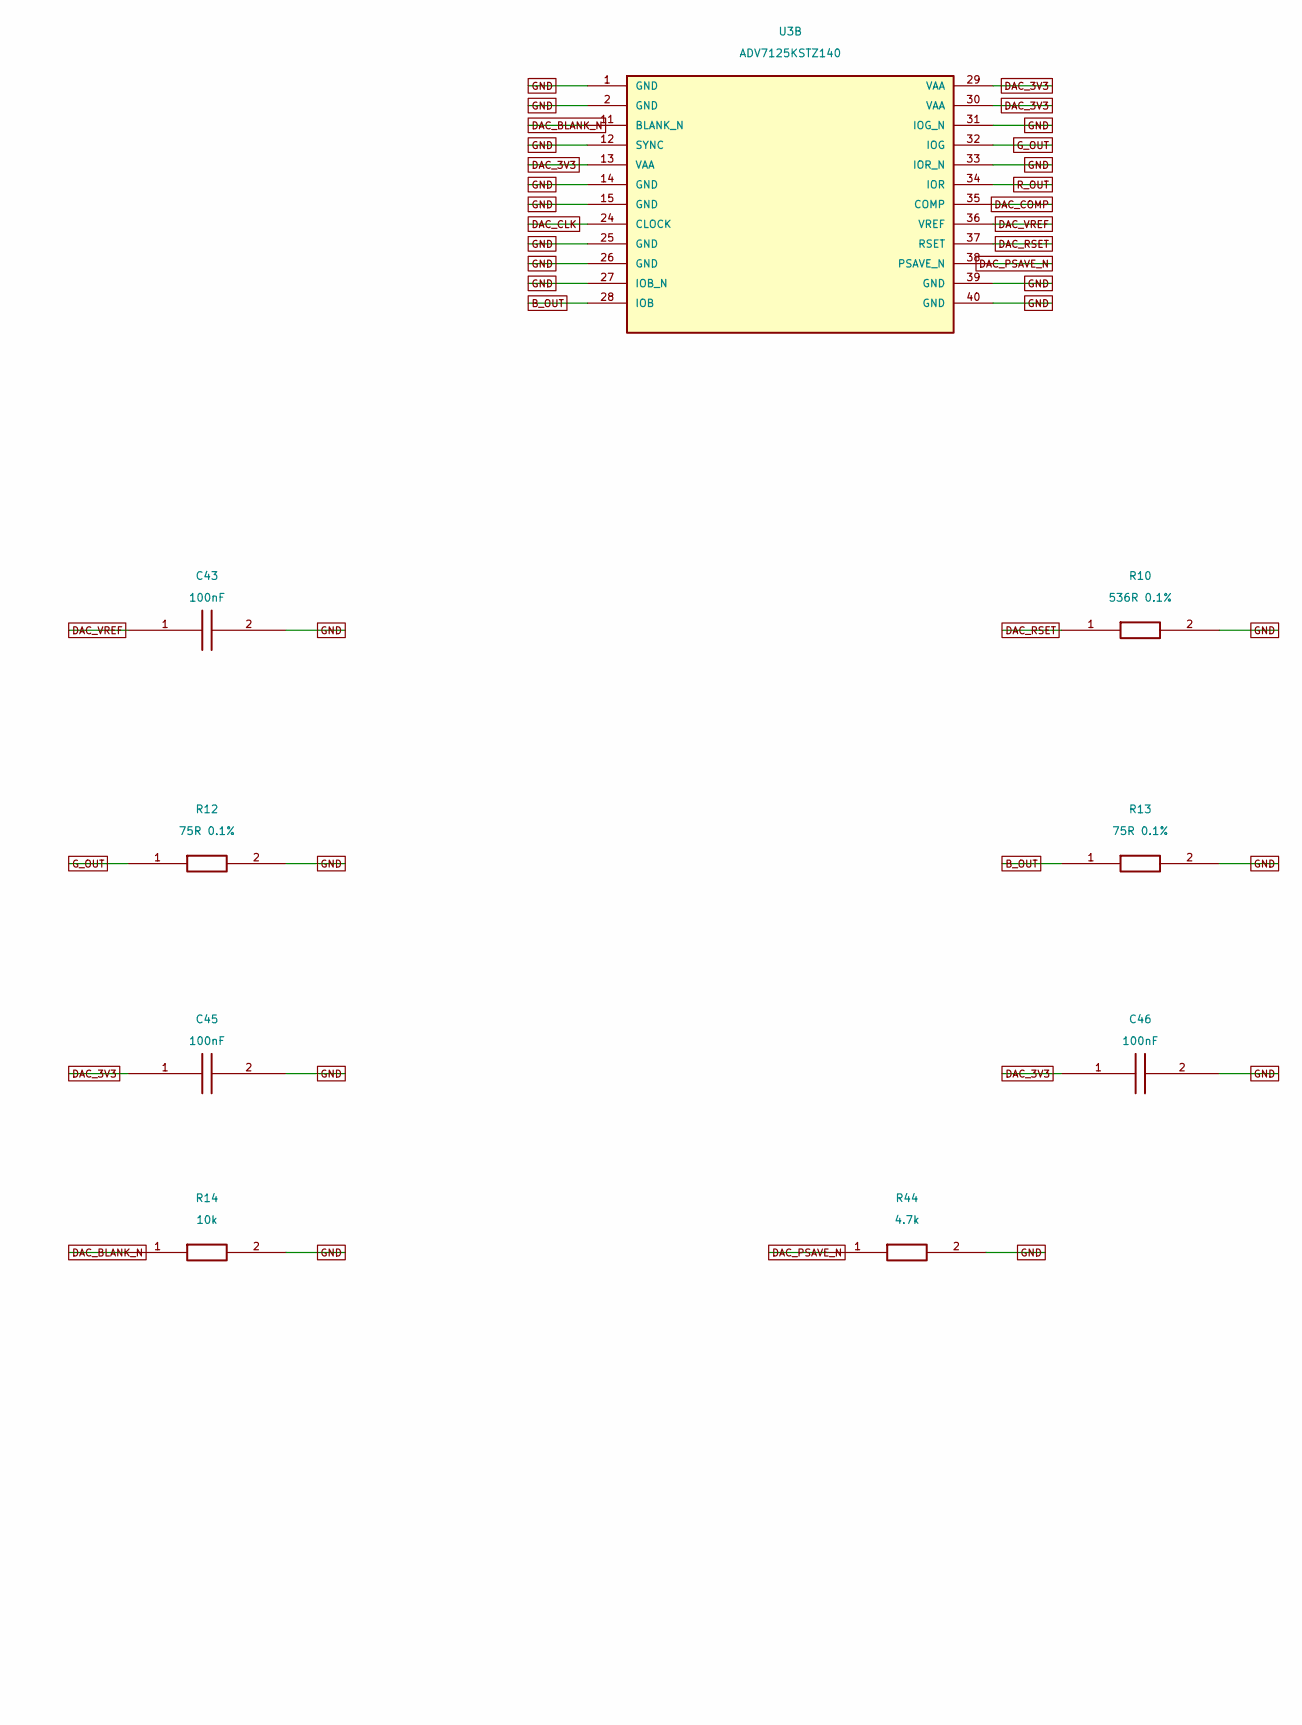
[picture p21: schematic 03_dac.kicad_sch, 03 - RGB DAC / ADV7125KSTZ140, part in row 1, column 2]

Parts:
C42: 100nF; C_0402_1005Metric; MPN CL05B104KO5NNNC; LCSC C1525
C43, C44, C45, C46: 100nF; C_0603_1608Metric; MPN CC0603KRX7R9BB104; LCSC C14663
C47: 10uF 25V; C_0805_2012Metric; MPN CL21A106KAYNNNE; LCSC C15850
R10: 536R 0.1%; R_0603_1608Metric; MPN RT0603BRD07536RL; LCSC C861466
R11, R12, R13: 75R 0.1%; R_0603_1608Metric; MPN AR03BTCX0750; LCSC C319466
R14: 10k; R_0603_1608Metric; MPN 0603WAF1002T5E; LCSC C25804
R44: 4.7k; R_0603_1608Metric; MPN 0603WAF4701T5E; LCSC C23162
U3: ADV7125KSTZ140; LQFP-48_7x7mm_P0.5mm; MPN ADV7125KSTZ140; LCSC C9668

Connections:
B_OUT: R13.1, U3.28 (IOB); also elsewhere on the board
DAC_3V3: C42.2, C44.1, C45.1, C46.1, C47.1, U3.13 (VAA), U3.29 (VAA), U3.30 (VAA); also elsewhere on the board
DAC_B0: U3.16 (B0); also elsewhere on the board
DAC_B1: U3.17 (B1); also elsewhere on the board
DAC_B2: U3.18 (B2); also elsewhere on the board
DAC_B3: U3.19 (B3); also elsewhere on the board
DAC_B4: U3.20 (B4); also elsewhere on the board
DAC_B5: U3.21 (B5); also elsewhere on the board
DAC_B6: U3.22 (B6); also elsewhere on the board
DAC_B7: U3.23 (B7); also elsewhere on the board
DAC_BLANK_N: R14.1, U3.11 (BLANK_N); also elsewhere on the board
DAC_CLK: U3.24 (CLOCK); also elsewhere on the board
DAC_COMP: C42.1, U3.35 (COMP)
DAC_G0: U3.3 (G0); also elsewhere on the board
DAC_G1: U3.4 (G1); also elsewhere on the board
DAC_G2: U3.5 (G2); also elsewhere on the board
DAC_G3: U3.6 (G3); also elsewhere on the board
DAC_G4: U3.7 (G4); also elsewhere on the board
DAC_G5: U3.8 (G5); also elsewhere on the board
DAC_G6: U3.9 (G6); also elsewhere on the board
DAC_G7: U3.10 (G7); also elsewhere on the board
DAC_PSAVE_N: R44.1, U3.38 (PSAVE_N); also elsewhere on the board
DAC_R0: U3.41 (R0); also elsewhere on the board
DAC_R1: U3.42 (R1); also elsewhere on the board
DAC_R2: U3.43 (R2); also elsewhere on the board
DAC_R3: U3.44 (R3); also elsewhere on the board
DAC_R4: U3.45 (R4); also elsewhere on the board
DAC_R5: U3.46 (R5); also elsewhere on the board
DAC_R6: U3.47 (R6); also elsewhere on the board
DAC_R7: U3.48 (R7); also elsewhere on the board
DAC_RSET: R10.1, U3.37 (RSET)
DAC_VREF: C43.1, U3.36 (VREF)
GND: C43.2, C44.2, C45.2, C46.2, C47.2, R10.2, R11.2, R12.2, R13.2, R14.2, R44.2, U3.1 (GND), U3.2 (GND), U3.12 (SYNC), U3.14 (GND), U3.15 (GND), U3.25 (GND), U3.26 (GND), U3.27 (IOB_N), U3.31 (IOG_N), U3.33 (IOR_N), U3.39 (GND), U3.40 (GND); also elsewhere on the board
G_OUT: R12.1, U3.32 (IOG); also elsewhere on the board
R_OUT: R11.1, U3.34 (IOR); also elsewhere on the board

Notes on the sheet:
536R: nominal 18.4mA; ~0.690V into 75R || 75R.
SYNC tied LOW: no sync-on-green. Complementary outputs to GND.
Verify DAC clock/data setup & hold after place-and-route.
PSAVE_N: FPGA pin 56; LOW before configuration / clock loss.

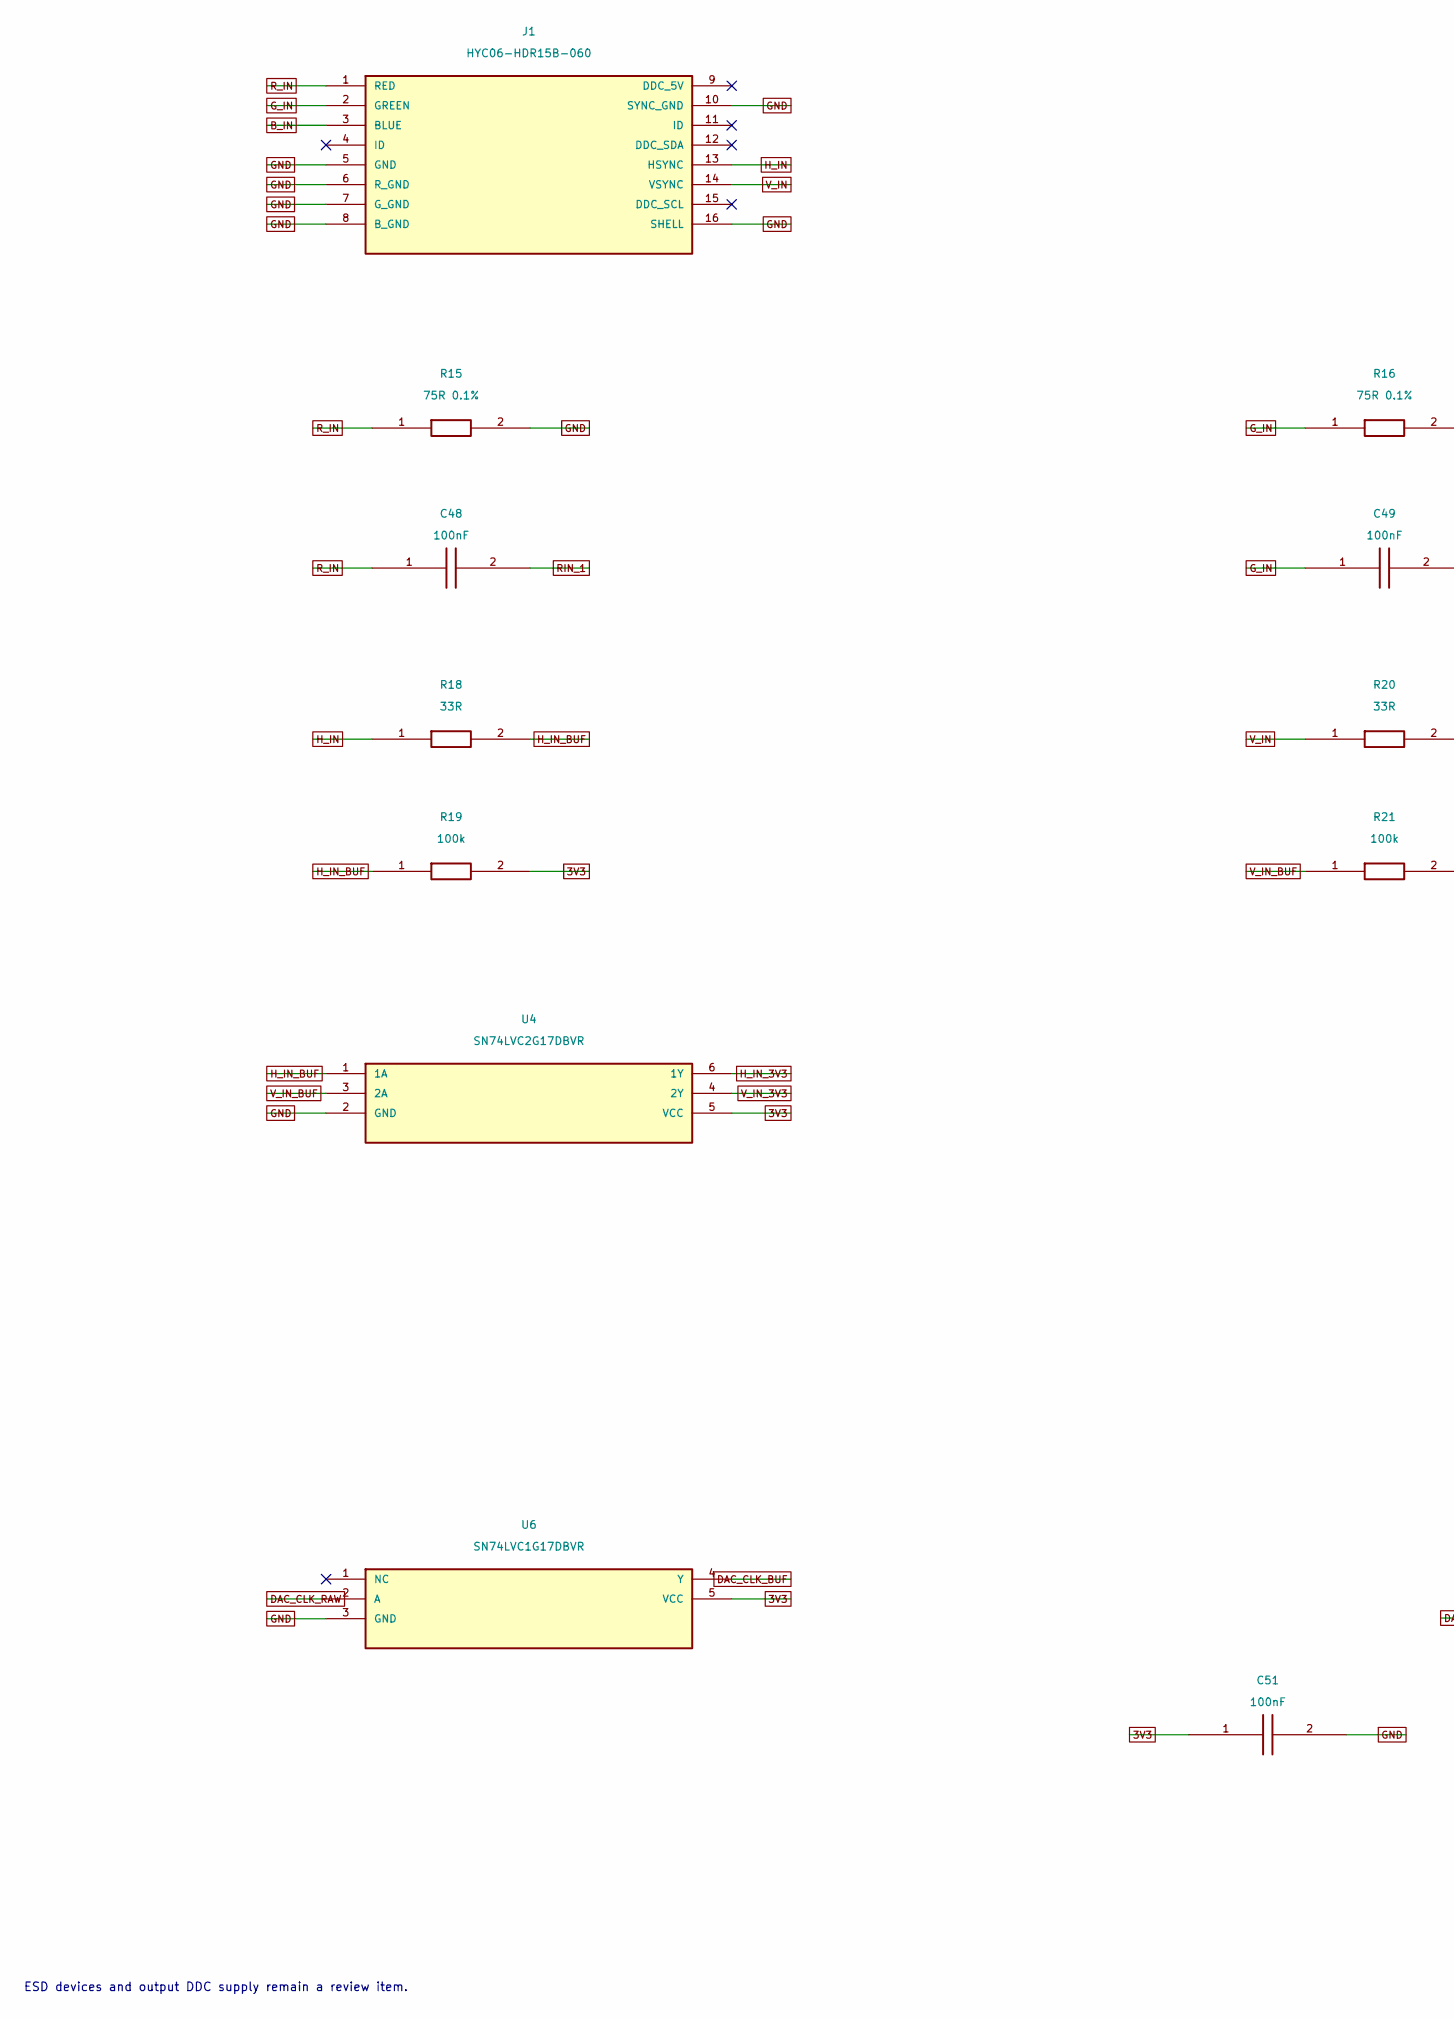
[picture p22: schematic 04_connectors.kicad_sch, 04 - DE-15 inputs/outputs and H/V level conversion, part in row 1, column 1]

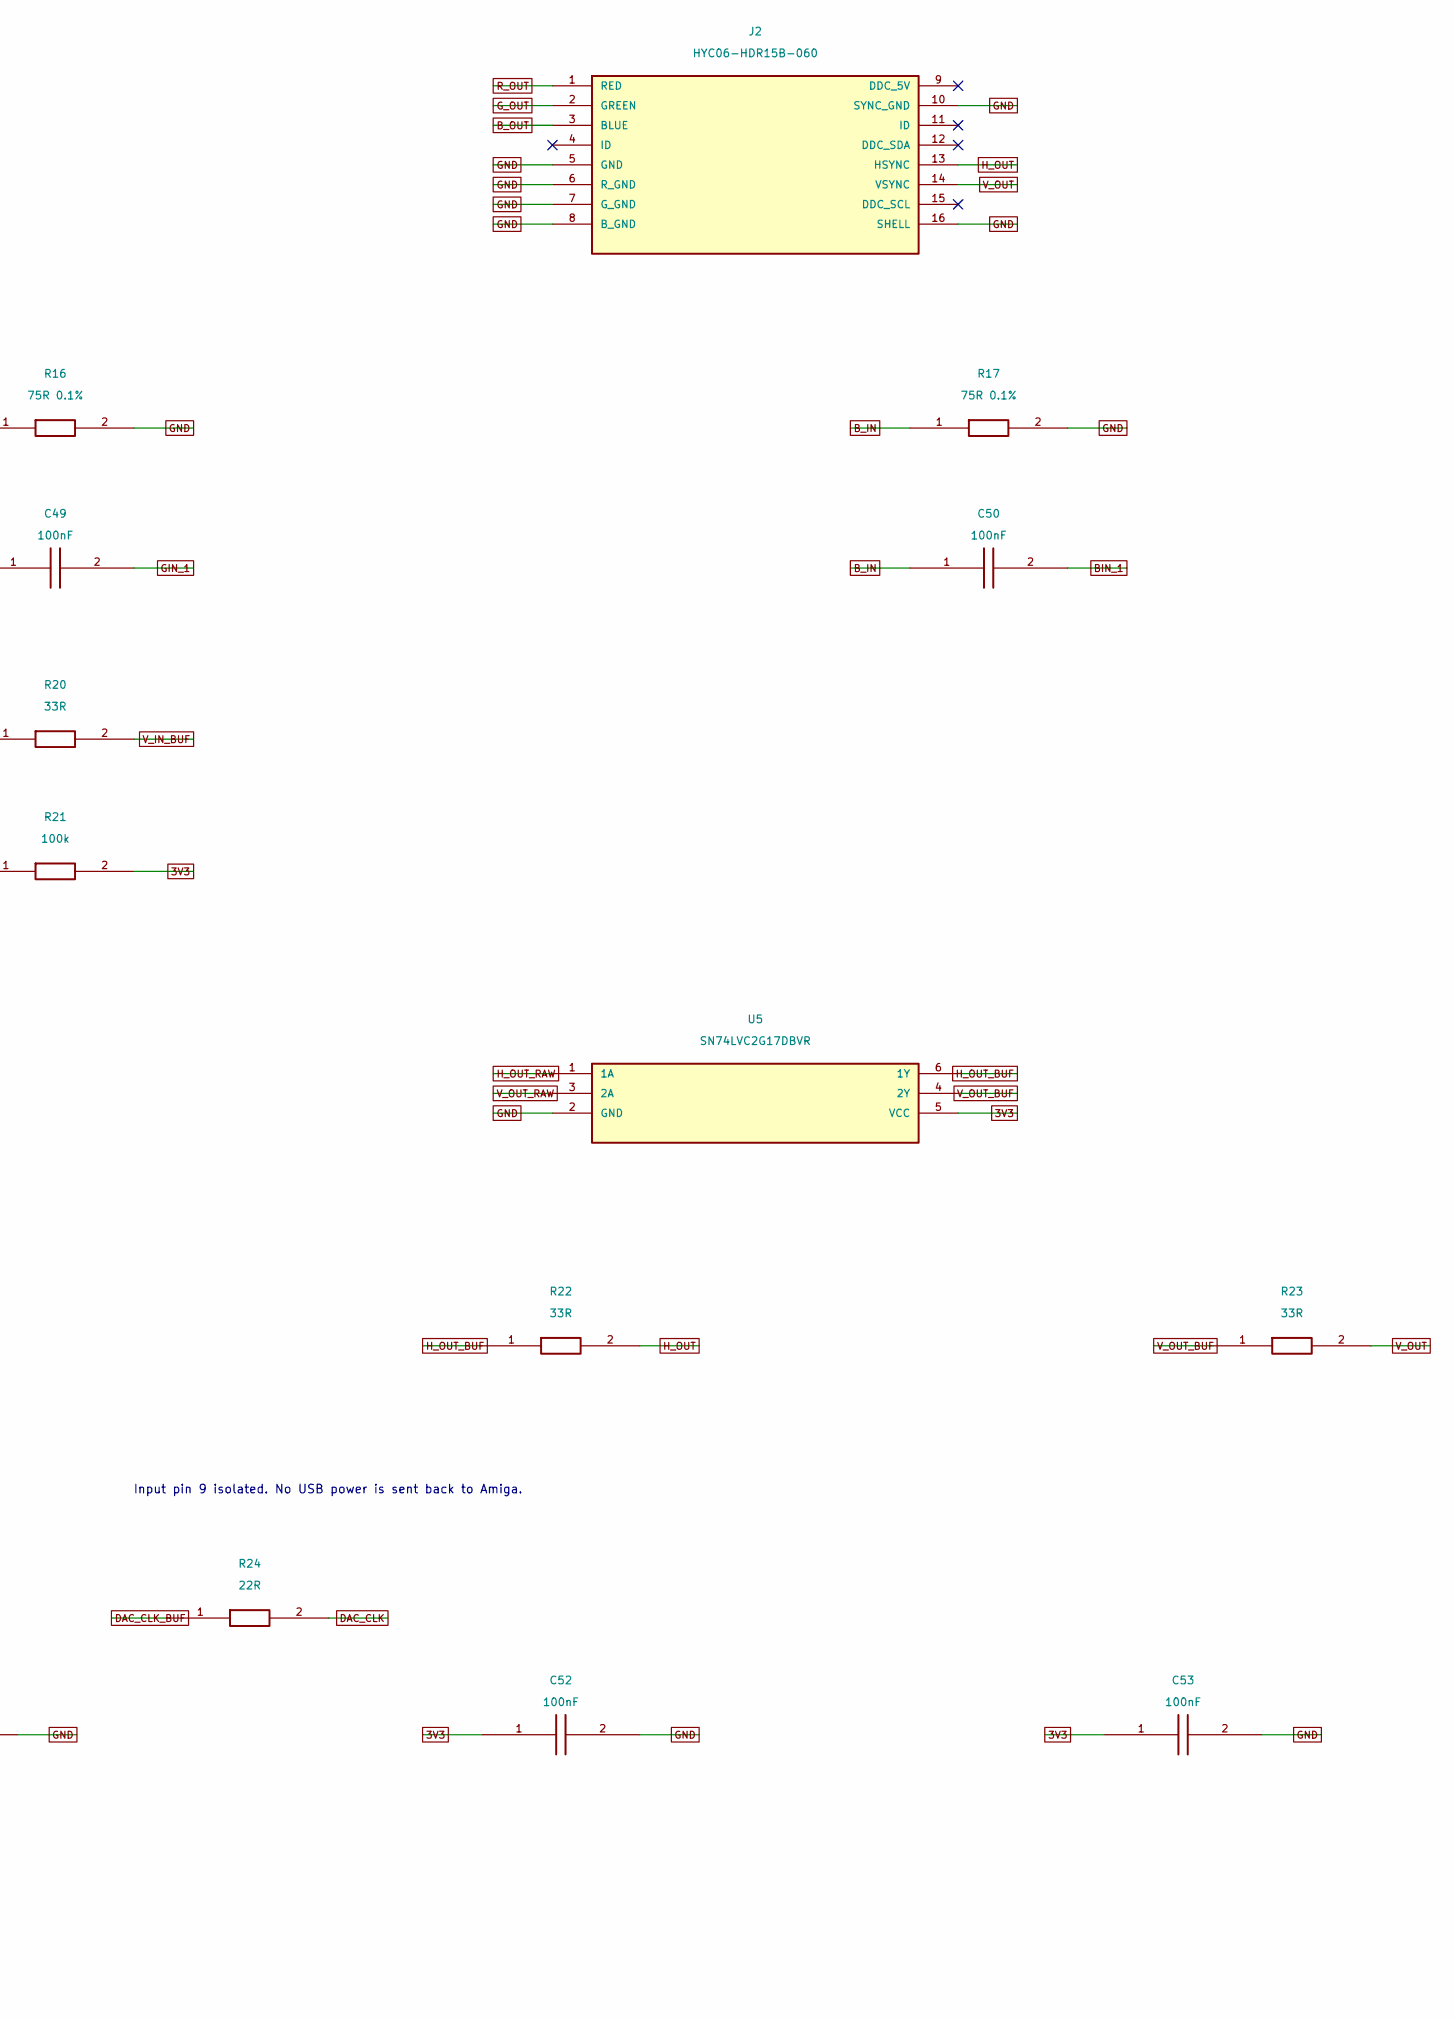
[picture p23: schematic 04_connectors.kicad_sch, 04 - DE-15 inputs/outputs and H/V level conversion, part in row 1, column 2]

Parts:
C48, C49, C50, C51, C52, C53: 100nF; C_0603_1608Metric; MPN CC0603KRX7R9BB104; LCSC C14663
J1, J2: HYC06-HDR15B-060; DE15_HOAUC_HYC06-HDR15B-060; MPN HYC06-HDR15B-060; LCSC C711364
R15, R16, R17: 75R 0.1%; R_0603_1608Metric; MPN AR03BTCX0750; LCSC C319466
R18, R20, R22, R23: 33R; R_0603_1608Metric; MPN 0603WAF330JT5E; LCSC C23140
R19, R21: 100k; R_0603_1608Metric; MPN 0603WAF1003T5E; LCSC C25803
R24: 22R; R_0603_1608Metric; MPN 0603WAF220JT5E; LCSC C23345
U4, U5: SN74LVC2G17DBVR; SOT-23-6; MPN SN74LVC2G17DBVR; LCSC C19829674
U6: SN74LVC1G17DBVR; SOT-23-5; MPN SN74LVC1G17DBVR; LCSC C7836

Connections:
3V3: C51.1, C52.1, C53.1, R19.2, R21.2, U4.5 (VCC), U5.5 (VCC), U6.5 (VCC); also elsewhere on the board
BIN_1: C50.2; also elsewhere on the board
B_IN: C50.1, J1.3 (BLUE), R17.1
B_OUT: J2.3 (BLUE); also elsewhere on the board
DAC_CLK: R24.2; also elsewhere on the board
DAC_CLK_BUF: R24.1, U6.4 (Y)
DAC_CLK_RAW: U6.2 (A); also elsewhere on the board
GIN_1: C49.2; also elsewhere on the board
GND: C51.2, C52.2, C53.2, J1.5 (GND), J1.6 (R_GND), J1.7 (G_GND), J1.8 (B_GND), J1.10 (SYNC_GND), J1.16 (SHELL), J2.5 (GND), J2.6 (R_GND), J2.7 (G_GND), J2.8 (B_GND), J2.10 (SYNC_GND), J2.16 (SHELL), R15.2, R16.2, R17.2, U4.2 (GND), U5.2 (GND), U6.3 (GND); also elsewhere on the board
G_IN: C49.1, J1.2 (GREEN), R16.1
G_OUT: J2.2 (GREEN); also elsewhere on the board
H_IN: J1.13 (HSYNC), R18.1
H_IN_3V3: U4.6 (1Y); also elsewhere on the board
H_IN_BUF: R18.2, R19.1, U4.1 (1A)
H_OUT: J2.13 (HSYNC), R22.2
H_OUT_BUF: R22.1, U5.6 (1Y)
H_OUT_RAW: U5.1 (1A); also elsewhere on the board
RIN_1: C48.2; also elsewhere on the board
R_IN: C48.1, J1.1 (RED), R15.1
R_OUT: J2.1 (RED); also elsewhere on the board
V_IN: J1.14 (VSYNC), R20.1
V_IN_3V3: U4.4 (2Y); also elsewhere on the board
V_IN_BUF: R20.2, R21.1, U4.3 (2A)
V_OUT: J2.14 (VSYNC), R23.2
V_OUT_BUF: R23.1, U5.4 (2Y)
V_OUT_RAW: U5.3 (2A); also elsewhere on the board

Notes on the sheet:
Input pin 9 isolated. No USB power is sent back to Amiga.
ESD devices and output DDC supply remain a review item.

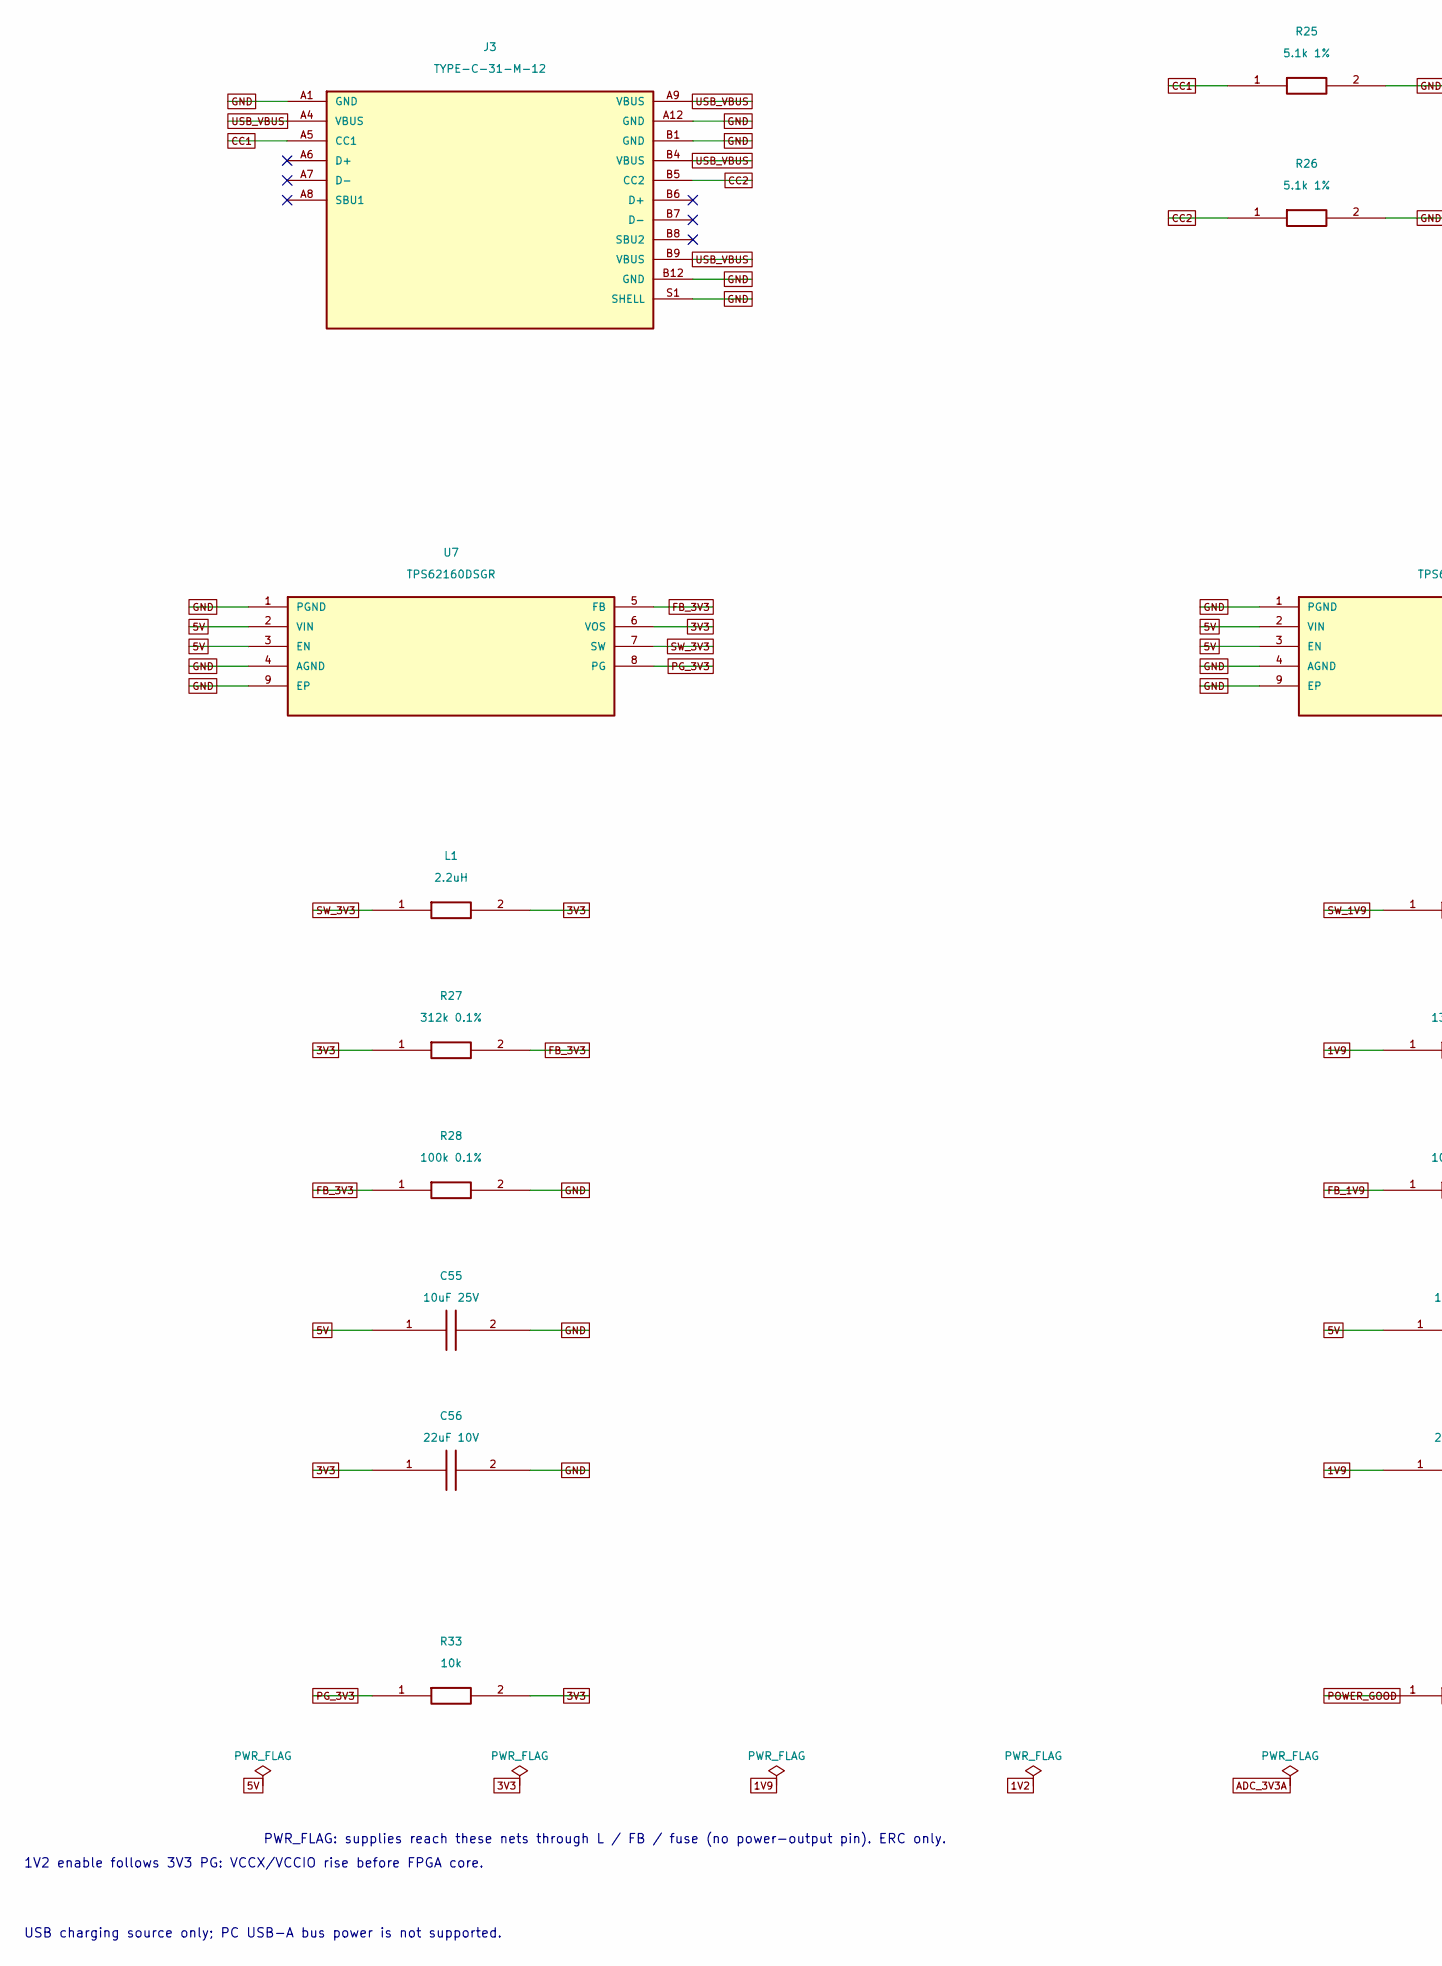
[picture p24: schematic 05_power.kicad_sch, 05 - USB 5V input and 3.3V / 1.9V / 1.2V supplies, part in row 1, column 1]

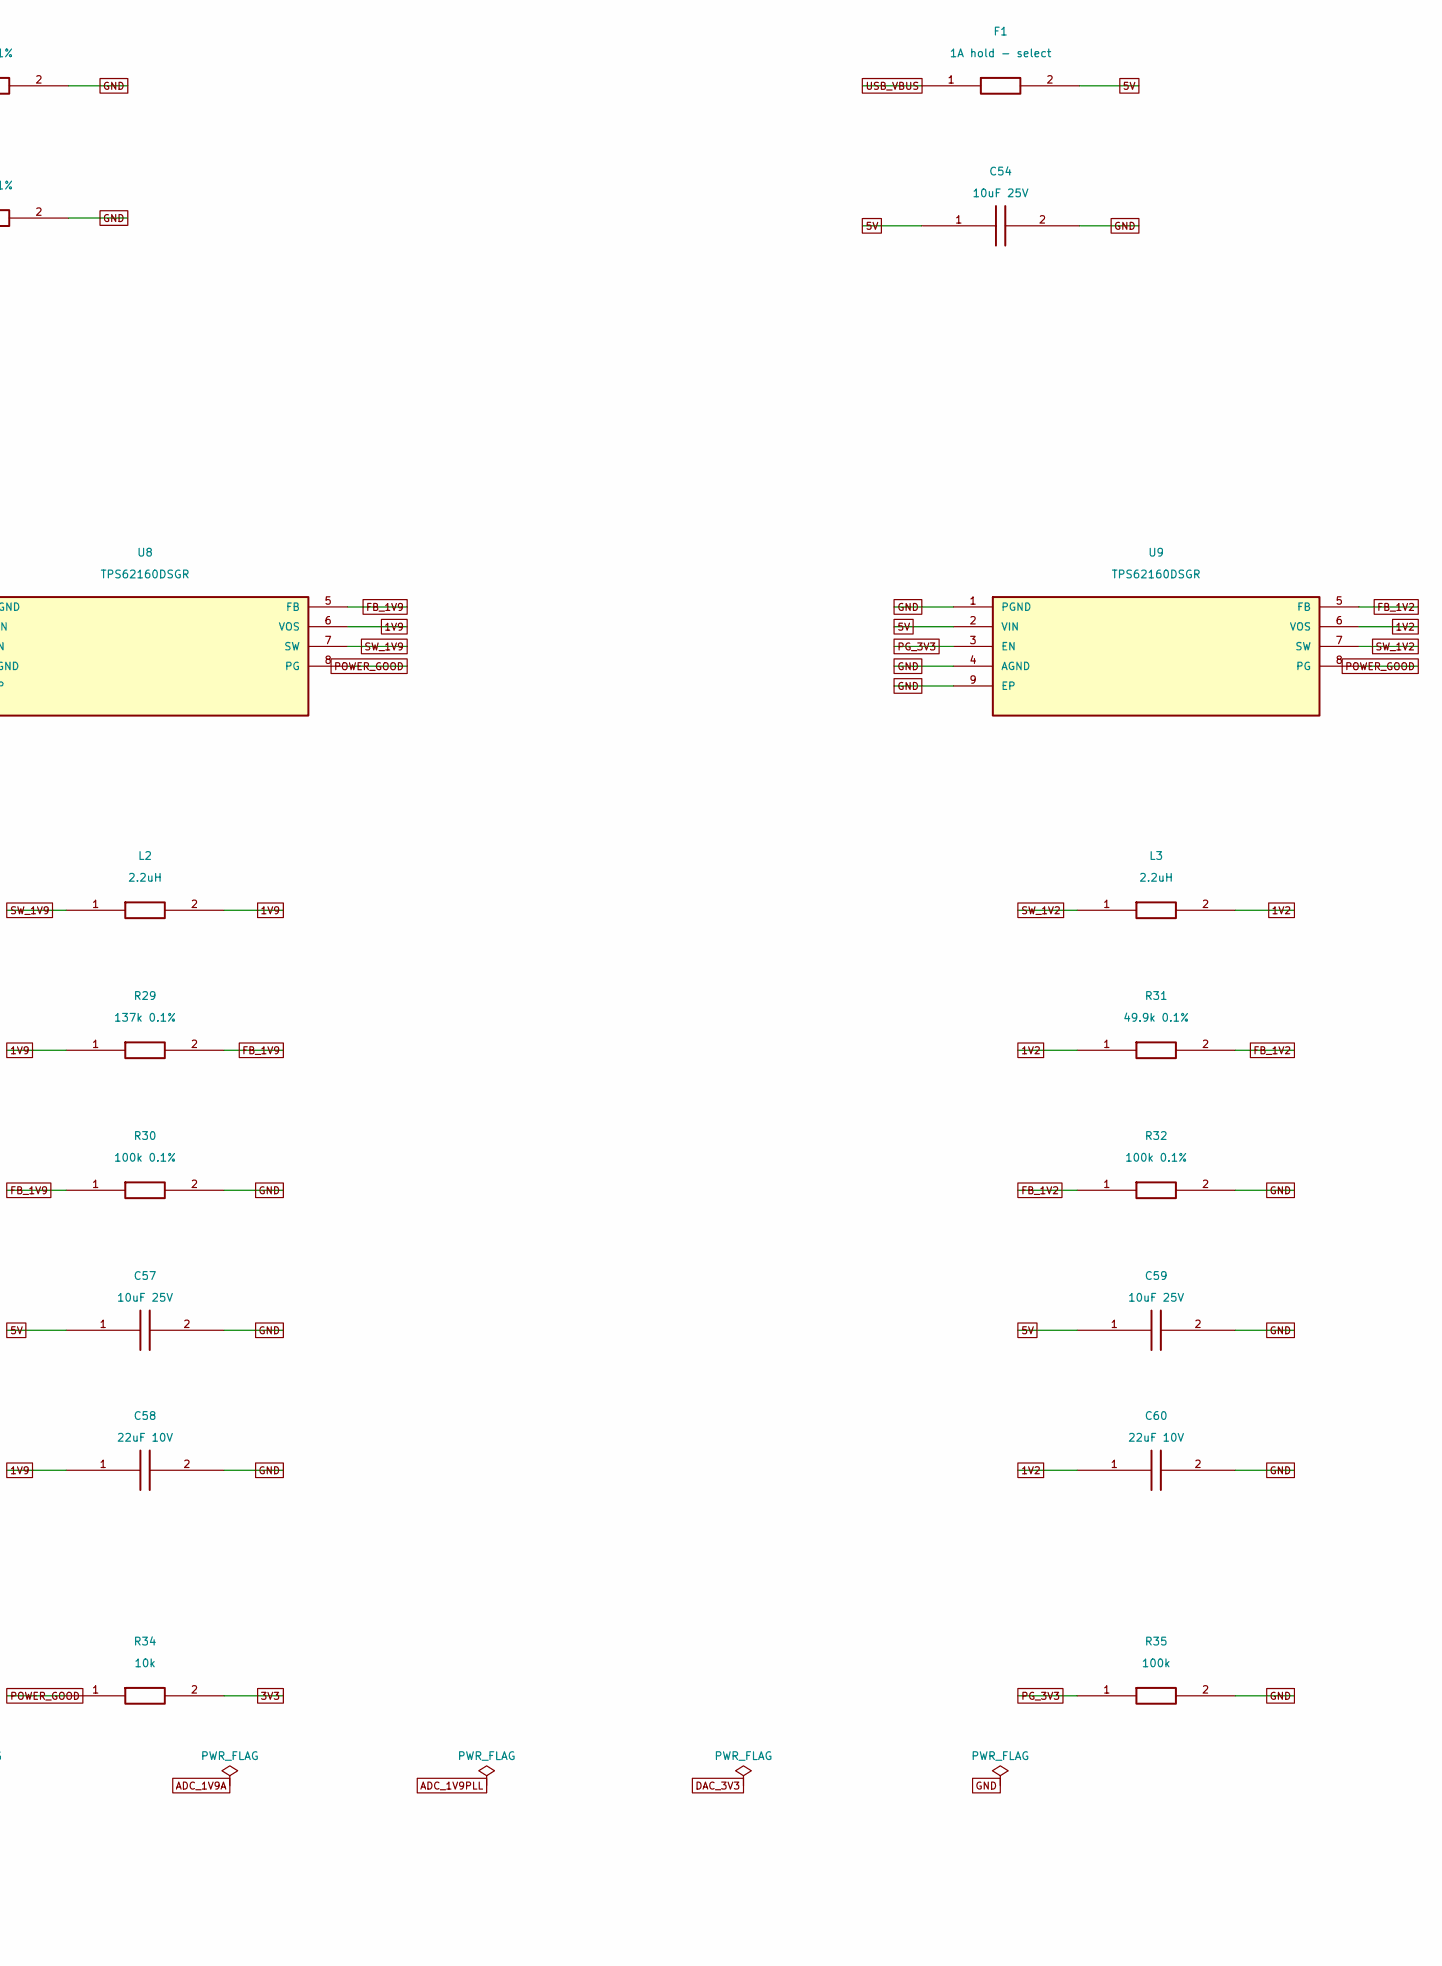
[picture p25: schematic 05_power.kicad_sch, 05 - USB 5V input and 3.3V / 1.9V / 1.2V supplies, part in row 1, column 2]

Parts:
C54, C55, C57, C59: 10uF 25V; C_0805_2012Metric; MPN CL21A106KAYNNNE; LCSC C15850
C56, C58, C60: 22uF 10V; C_0805_2012Metric; MPN CL21A226MAQNNNE; LCSC C45783
F1: 1A hold - select; Fuse_1206_3216Metric; MPN SMD1206B110TFT; LCSC C269119
J3: TYPE-C-31-M-12; USB_C_Receptacle_HRO_TYPE-C-31-M-12_Slot0.8; MPN TYPE-C-31-M-12; LCSC C165948
L1, L2, L3: 2.2uH; L_TDK_VLS4012CX; MPN NRS4018T2R2MDGJ; LCSC C92959
R25, R26: 5.1k 1%; R_0603_1608Metric; MPN 0603WAF5101T5E; LCSC C23186
R27: 312k 0.1%; R_0603_1608Metric; MPN RT0603BRD07312KL; LCSC C861315
R28, R30, R32: 100k 0.1%; R_0603_1608Metric; MPN RT0603BRD07100KL; LCSC C122538
R29: 137k 0.1%; R_0603_1608Metric; MPN RT0603BRD07137KL; LCSC C861114
R31: 49.9k 0.1%; R_0603_1608Metric; MPN RT0603BRD0749K9L; LCSC C705780
R33, R34: 10k; R_0603_1608Metric; MPN 0603WAF1002T5E; LCSC C25804
R35: 100k; R_0603_1608Metric; MPN 0603WAF1003T5E; LCSC C25803
U7, U8, U9: TPS62160DSGR; WSON-8-1EP_2x2mm_P0.5mm_EP0.9x1.6mm; MPN TPS62160DSGR; LCSC C324077

Connections:
1V2: C60.1, L3.2, R31.1, U9.6 (VOS); also elsewhere on the board
1V9: C58.1, L2.2, R29.1, U8.6 (VOS); also elsewhere on the board
3V3: C56.1, L1.2, R27.1, R33.2, R34.2, U7.6 (VOS); also elsewhere on the board
5V: C54.1, C55.1, C57.1, C59.1, F1.2, U7.2 (VIN), U7.3 (EN), U8.2 (VIN), U8.3 (EN), U9.2 (VIN)
CC1: J3.A5 (CC1), R25.1
CC2: J3.B5 (CC2), R26.1
FB_1V2: R31.2, R32.1, U9.5 (FB)
FB_1V9: R29.2, R30.1, U8.5 (FB)
FB_3V3: R27.2, R28.1, U7.5 (FB)
GND: C54.2, C55.2, C56.2, C57.2, C58.2, C59.2, C60.2, J3.A1 (GND), J3.A12 (GND), J3.B1 (GND), J3.B12 (GND), J3.S1 (SHELL), R25.2, R26.2, R28.2, R30.2, R32.2, R35.2, U7.1 (PGND), U7.4 (AGND), U7.9 (EP), U8.1 (PGND), U8.4 (AGND), U8.9 (EP), U9.1 (PGND), U9.4 (AGND), U9.9 (EP); also elsewhere on the board
PG_3V3: R33.1, R35.1, U7.8 (PG), U9.3 (EN)
POWER_GOOD: R34.1, U8.8 (PG), U9.8 (PG); also elsewhere on the board
SW_1V2: L3.1, U9.7 (SW)
SW_1V9: L2.1, U8.7 (SW)
SW_3V3: L1.1, U7.7 (SW)
USB_VBUS: F1.1, J3.A4 (VBUS), J3.A9 (VBUS), J3.B4 (VBUS), J3.B9 (VBUS)

Notes on the sheet:
1V2 enable follows 3V3 PG: VCCX/VCCIO rise before FPGA core.
USB charging source only; PC USB-A bus power is not supported.
PWR_FLAG: supplies reach these nets through L / FB / fuse (no power-output pin). ERC only.
