110-kenichi/A1200LineDoubler/outputs/amiga_scandoubler/hardware/amiga_scandoubler_v030wip.kicad_pcb

## KiCad design outputs/amiga_scandoubler/hardware/amiga_scandoubler_v030wip.kicad_pcb (continued)

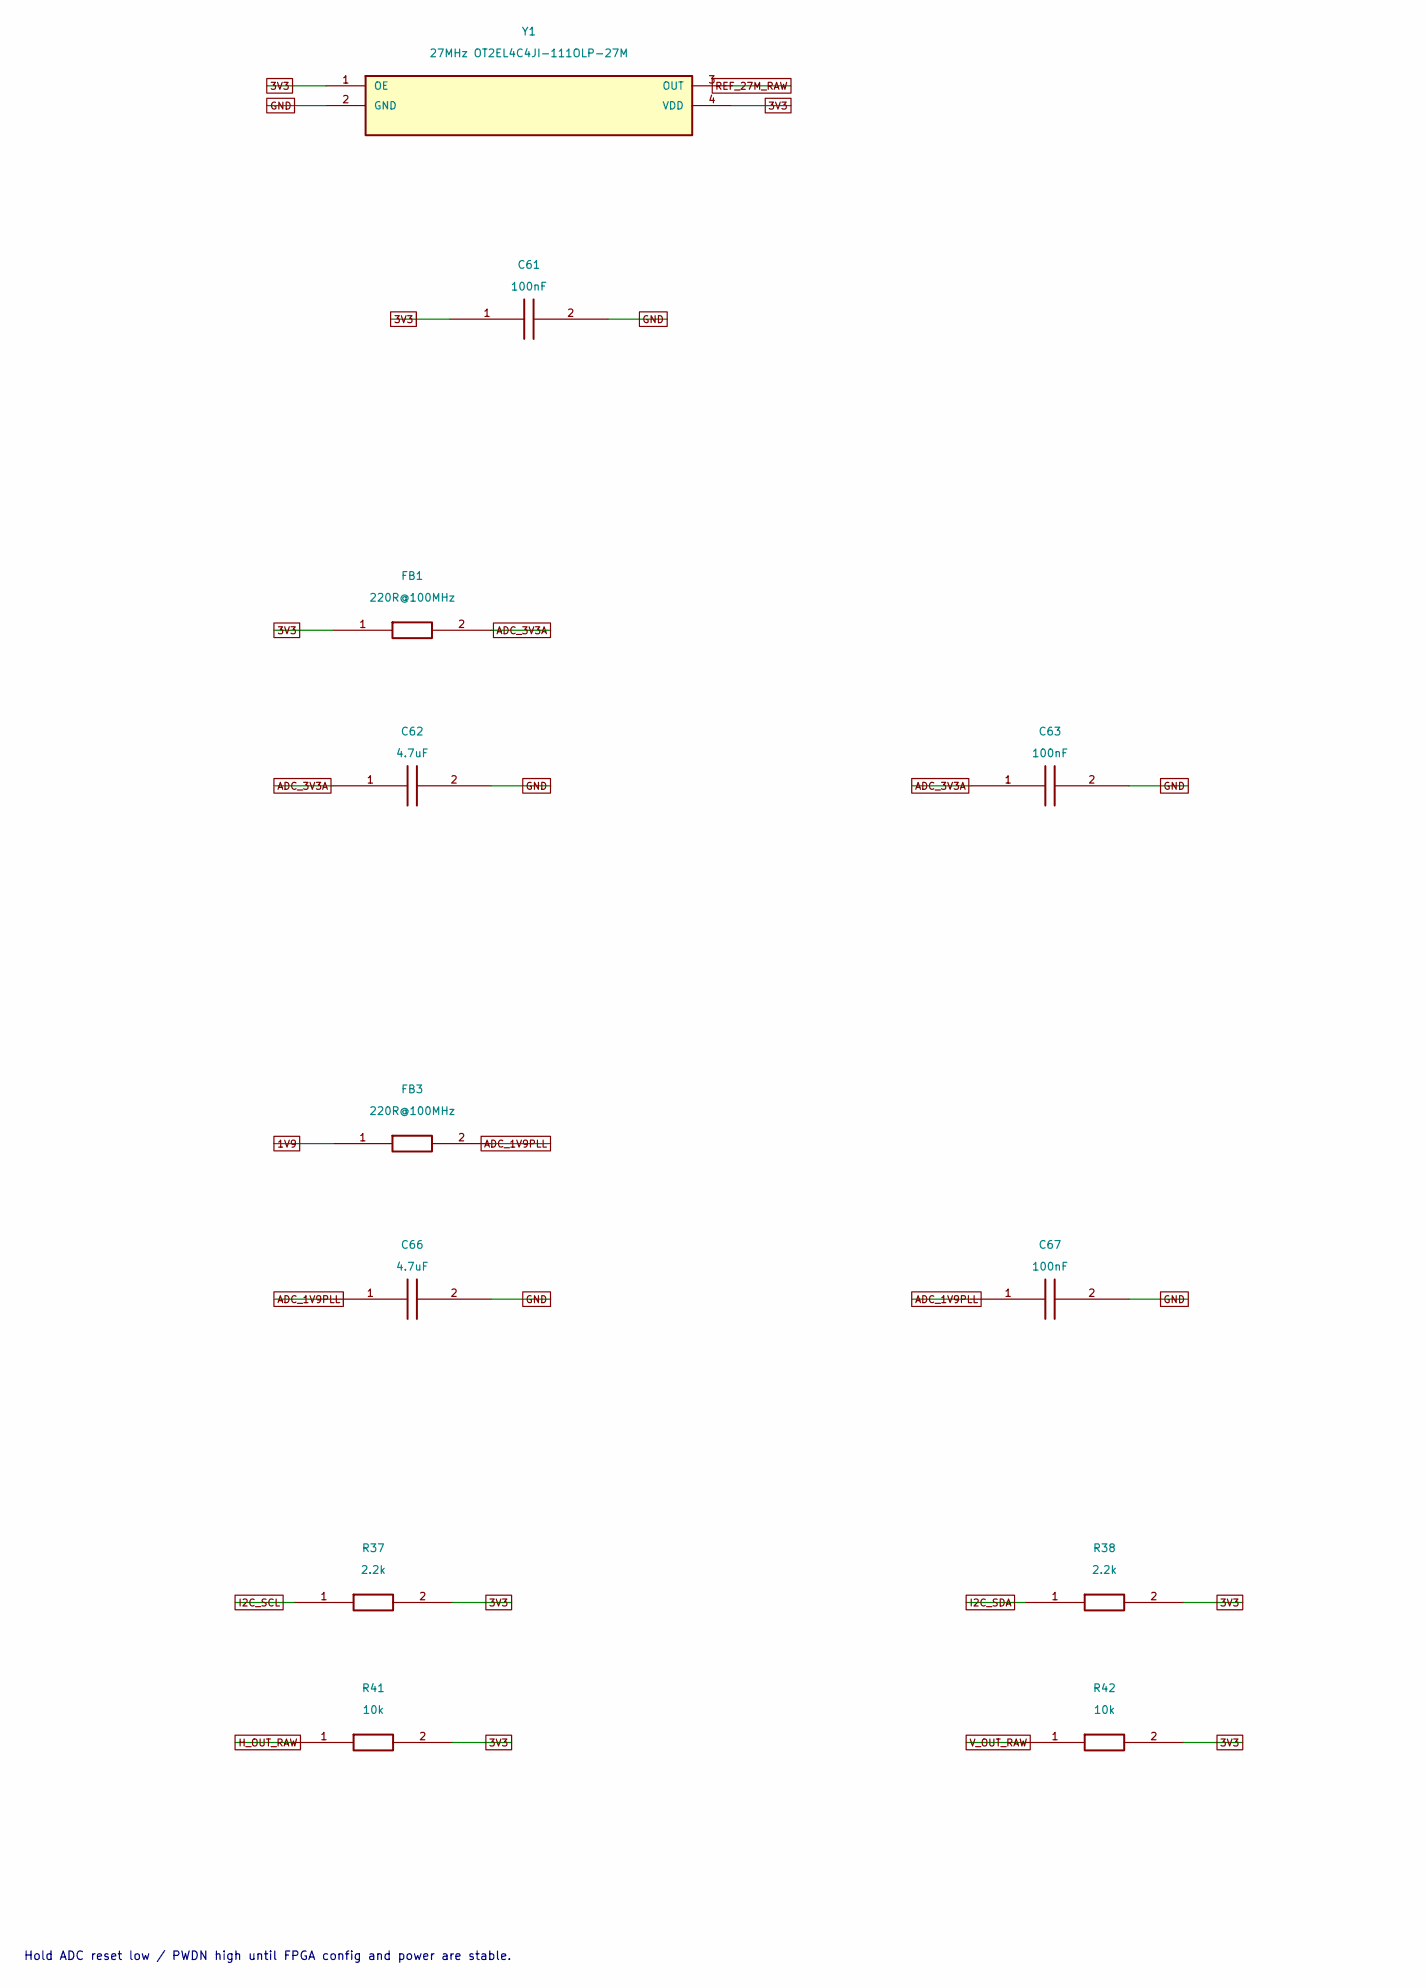
[picture p26: schematic 06_support.kicad_sch, 06 - Reference clock, analog rail filtering and startup bias, part in row 1, column 1]

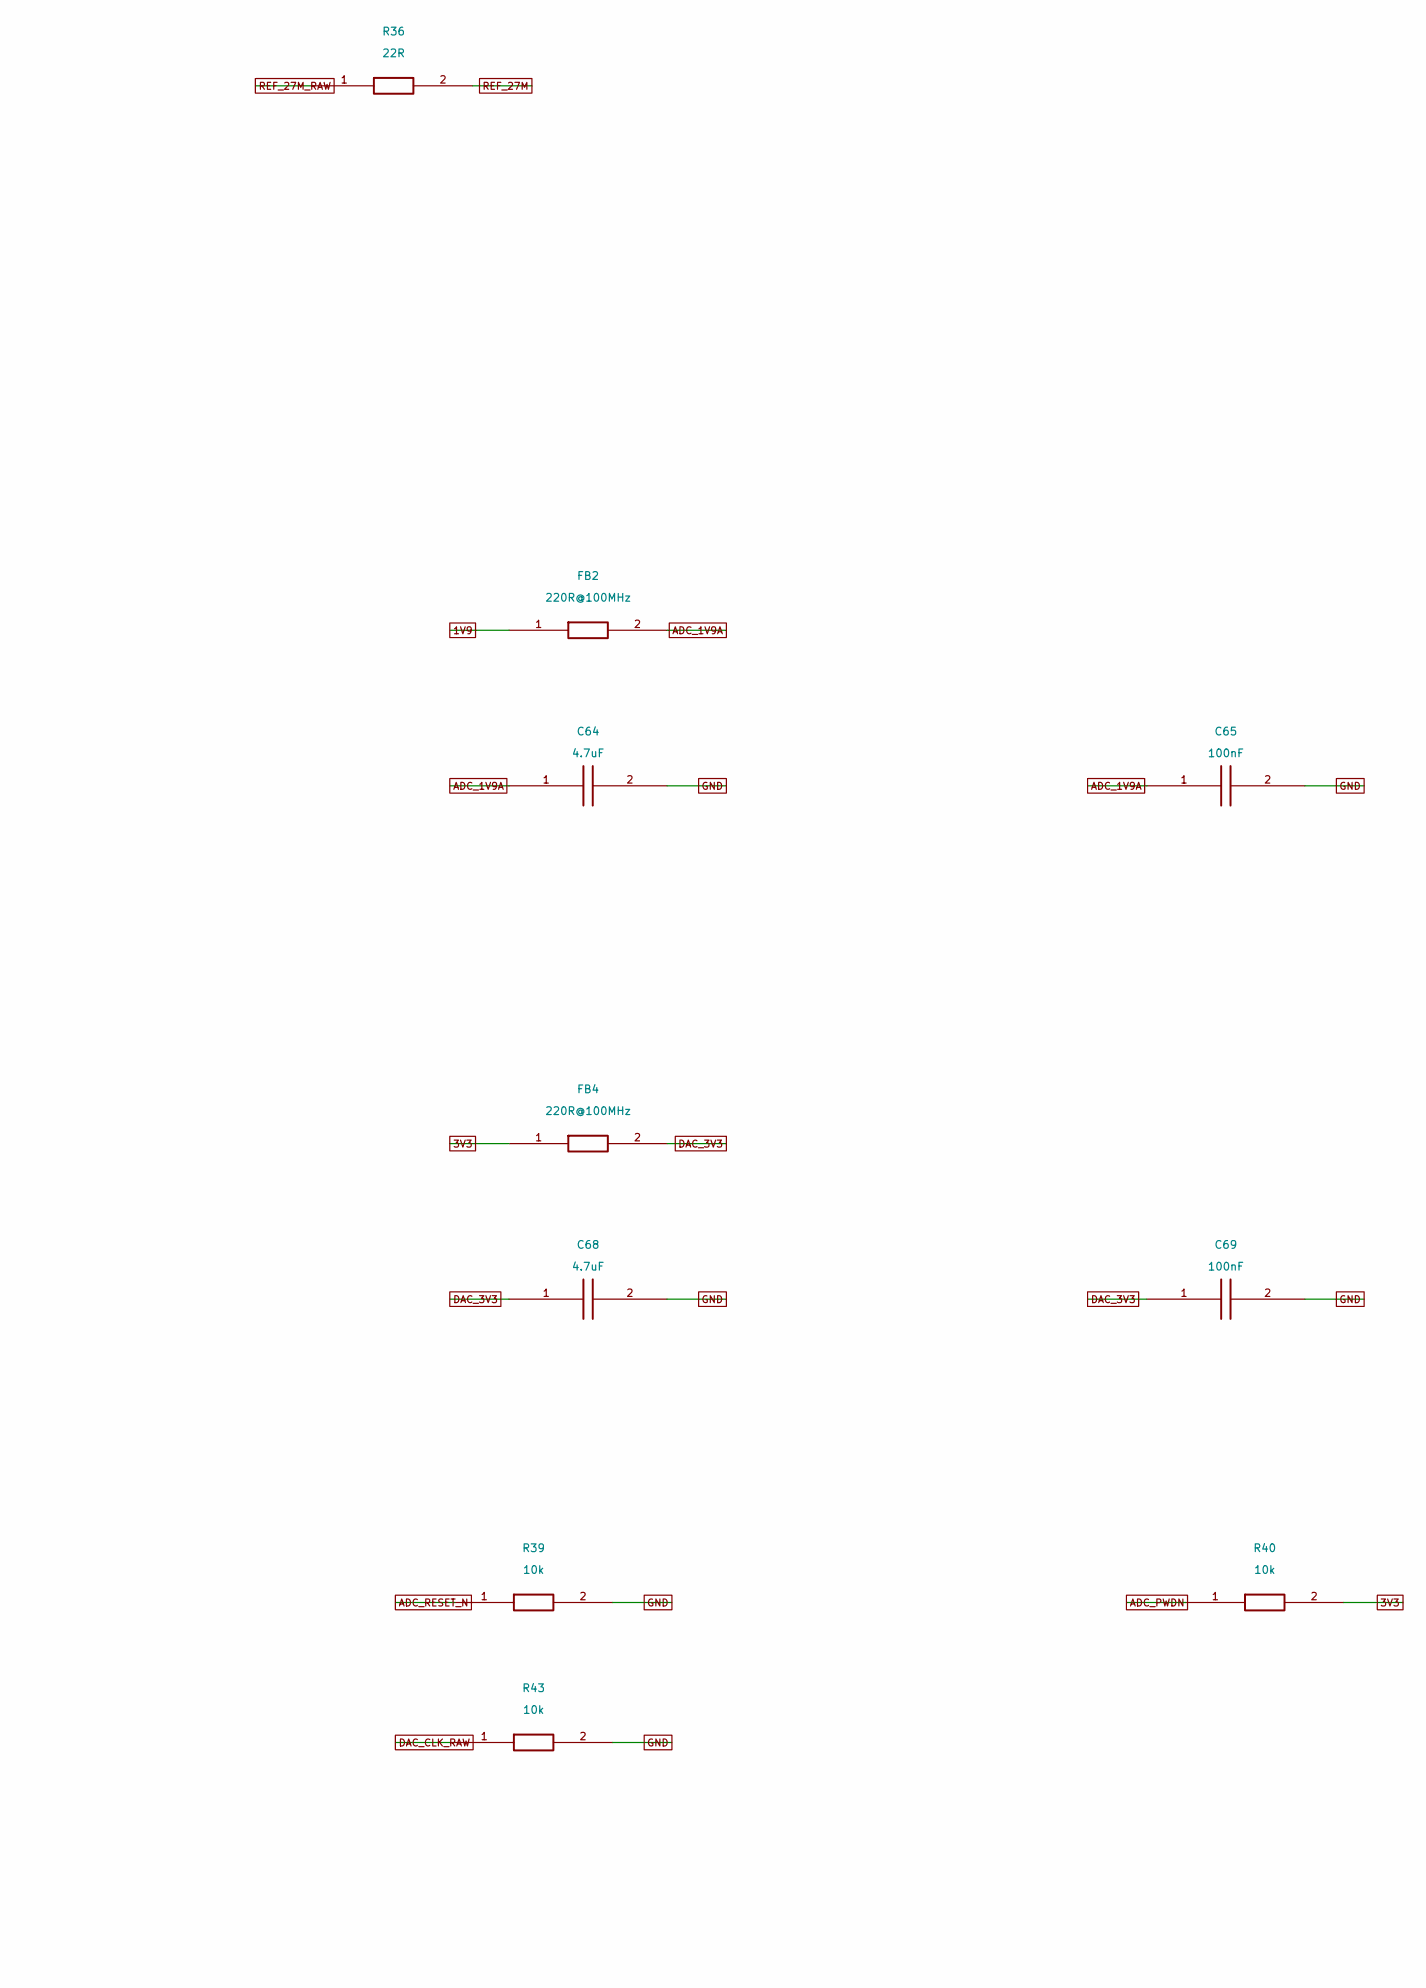
[picture p27: schematic 06_support.kicad_sch, 06 - Reference clock, analog rail filtering and startup bias, part in row 1, column 2]

Parts:
C61, C63, C65, C67, C69: 100nF; C_0603_1608Metric; MPN CC0603KRX7R9BB104; LCSC C14663
C62, C64, C66, C68: 4.7uF; C_0805_2012Metric; MPN CL21A475KAQNNNE; LCSC C1779
FB1, FB2, FB3, FB4: 220R@100MHz; L_0603_1608Metric; MPN HCB1608KF-221T20; LCSC C304314
R36: 22R; R_0603_1608Metric; MPN 0603WAF220JT5E; LCSC C23345
R37, R38: 2.2k; R_0402_1005Metric; MPN 0402WGF2201TCE; LCSC C25879
R39, R40: 10k; R_0402_1005Metric; MPN 0402WGF1002TCE; LCSC C25744
R41, R42, R43: 10k; R_0603_1608Metric; MPN 0603WAF1002T5E; LCSC C25804
Y1: 27MHz OT2EL4C4JI-111OLP-27M; OSC_ECS-3225MVLC_3.2x2.5; MPN OT2EL4C4JI-111OLP-27M; LCSC C5203549

Connections:
1V9: FB2.1, FB3.1; also elsewhere on the board
3V3: C61.1, FB1.1, FB4.1, R37.2, R38.2, R40.2, R41.2, R42.2, Y1.1 (OE), Y1.4 (VDD); also elsewhere on the board
ADC_1V9A: C64.1, C65.1, FB2.2; also elsewhere on the board
ADC_1V9PLL: C66.1, C67.1, FB3.2; also elsewhere on the board
ADC_3V3A: C62.1, C63.1, FB1.2; also elsewhere on the board
ADC_PWDN: R40.1; also elsewhere on the board
ADC_RESET_N: R39.1; also elsewhere on the board
DAC_3V3: C68.1, C69.1, FB4.2; also elsewhere on the board
DAC_CLK_RAW: R43.1; also elsewhere on the board
GND: C61.2, C62.2, C63.2, C64.2, C65.2, C66.2, C67.2, C68.2, C69.2, R39.2, R43.2, Y1.2 (GND); also elsewhere on the board
H_OUT_RAW: R41.1; also elsewhere on the board
I2C_SCL: R37.1; also elsewhere on the board
I2C_SDA: R38.1; also elsewhere on the board
REF_27M: R36.2; also elsewhere on the board
REF_27M_RAW: R36.1, Y1.3 (OUT)
V_OUT_RAW: R42.1; also elsewhere on the board

Notes on the sheet:
Hold ADC reset low / PWDN high until FPGA config and power are stable.

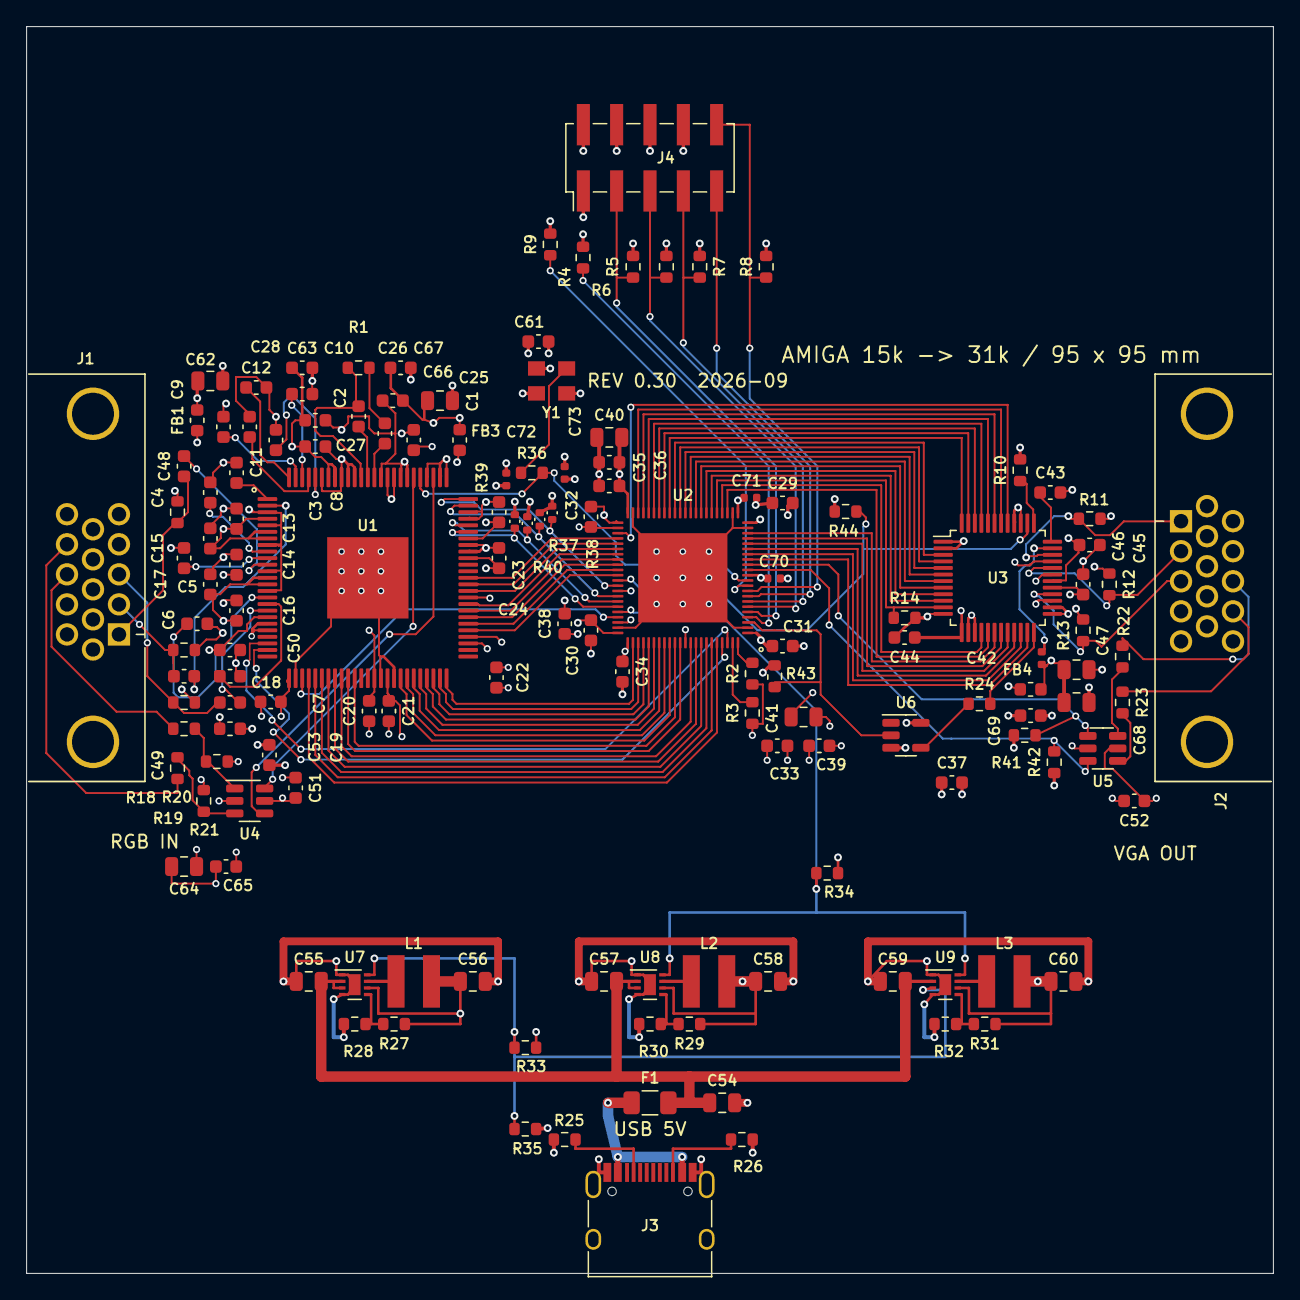
[picture p28: board amiga_scandoubler_v030wip.kicad_pcb from above]

Board: 4 copper layers, 95.0 x 95.0 mm, 139 parts (0 on the bottom side), 129 nets.
