110-kenichi/A1200LineDoubler/(commit log)

2026-09-28 Import A1200 Line Doubler project
    [01_adc.kicad_sch, 02_fpga.kicad_sch, 03_dac.kicad_sch, 04_connectors.kicad_sch, 05_power.kicad_sch, 06_support.kicad_sch, amiga_scandoubler.kicad_sch, amiga_scandoubler_analog.kicad_pcb]
2026-09-28 v030wip: KiCad 7.0.11 で読み込み・ゾーン再充填・DRC 確認
    - amiga_scandoubler_v030wip.kicad_pcb を KiCad 7 pcbnew で開き、
    In1(GND)/In2(3V3) ゾーンを再充填して KiCad 7 形式(20221018)で保存
    - KiCad 7 DRC 結果 v030wip_drc_k7.txt を追加
    エラー(短絡/クリアランス等)0、未接続 112(KiCad 10 版と同数・同一箇所)
    - KiCad 7 API 対応の監査スクリプト audit_sync_in_k7.py を追加
    既知課題どおり C34(3V3/GND 孤立)で FAIL することを確認
    Claude-Session: https://claude.ai/code/session_019f929sAJ7LRnJRRFvA6g9F
    [amiga_scandoubler_v030wip.kicad_pcb]
2026-09-28 v030wip: C34(U2 3V3 パスコン)の孤立を解消
    - C34 を (37,30) から U2 左下角 (45.4,49.15, 270°) へ移動
    - pad1(3V3) を U2.67 の既存 3V3 ビアへ接続、pad2(GND) に GND ビアを追加
    - U2 左の制御線予約領域と B.Cu 通路は回避
    - KiCad 7 DRC: エラー 0、未接続 112→110 (3V3/GND 各 -1 のみ)
    - 電源監査: 電源 75・GND 80 件 PASS。残る FAIL は U2 再ピン由来(課題5/9)
    - CLAUDE.md と revision_0.30wip.md を更新、配置スクリプトを追加
    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
    [amiga_scandoubler_v030wip.kicad_pcb]
2026-09-28 revision_0.30wip.md: 欠落したファイル名を修正
    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
2026-09-28 v030wip: 課題2 U2 左の制御線(SDA/SCL/RESET/PWDN)の本線を配線
    - U1 内周ビア → B.Cu → U2 前面ビアで 4 本を接続(交差なし、各ビア2個)
    x=35 のビア列の隙間を上帯 SDA/SCL、下帯 RESET/PWDN で通過
    - ADC_CLK の B.Cu 終点を (43.95,45.0) へ移し U2.60/61 の引き出し通路を確保
    - U2.64 3V3 を内周ビアへ、U2.65 GND スタブを短縮
    - KiCad 7 DRC: エラー 0、未接続 110→106(4ネット各 -1)。導通確認済み
    - 電源監査: 電源 75・GND 80 PASS
    - プルアップ R37–R40 は 0603 では収まらず未接続(判断待ち)
    - KiCad 7 用編集ヘルパ pcbk7.py、配置探索 pullsearch.py、再現スクリプトを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
    [amiga_scandoubler_v030wip.kicad_pcb]
2026-09-28 v030wip: R37–R40 を 0402 化してプルアップ／プルダウンを接続(課題2完了)
    - 0603 では空き領域に収まらないため、利用者判断で R_0402_1005Metric に変更
    - 4 本を縦置き 0.95mm ピッチで配置し、信号ビアを各 B.Cu 配線上へ
    - 3V3/GND は面へのビア(R37 は R38 の 3V3 ビアを共用)
    - 回路図・ネットリスト・circuit_manifest のフットプリント欄を更新
    - KiCad 7 DRC: エラー 0、未接続 106→98。導通確認済み、電源監査 PASS
    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
    [06_support.kicad_sch, amiga_scandoubler_v030wip.kicad_pcb]
2026-09-28 CLAUDE.md: 課題2 完了(R37–R40 0402 化)を反映
    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
2026-09-28 v030wip: 課題3 POWER_GOOD(U2.62)を既存の南側配線へ接続
    - U2.62 → 内周ビア (46.04,44.45) → B.Cu で EP 下 y=44.65 を東へ
    → 45° で南東 → x=59.075 を南下 → 既存ビア (60.175,65.7)
    - y=41 の通路は課題4(PSAVE)用に予約して回避
    - KiCad 7 DRC: エラー 0、未接続 98→97(POWER_GOOD のみ)
    - U8.8/U9.8/R34.1 との導通確認、電源監査 PASS
    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
    [amiga_scandoubler_v030wip.kicad_pcb]
2026-09-28 v030wip: 課題4 DAC_PSAVE_N(U2.56)を R44・U3.38 へ接続
    - U2.56 → 内周ビア → B.Cu で EP 下 y=41 → 1V2 壁の北端を回って R44.1
    - R44 → B.Cu y=39.85 → U3 本体下のビア → U3.38(パッド内側から)
    - KiCad 7 DRC: エラー 0、未接続 97→95(DAC_PSAVE_N のみ)
    - 導通確認、電源監査 PASS。DAC バス(課題6)への影響を記録
    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
    [amiga_scandoubler_v030wip.kicad_pcb]
2026-09-28 v030wip: 課題5の準備 — 1V2 右リンクを In2 へ、PSAVE を南回りへ変更
    - 1V2 の右側 B.Cu 壁(58,37.225)↔(58,45.225)を同形状で In2.Cu へ移動
    - DAC_PSAVE_N の U2→R44 区間を y=42.75 → 南東 → y=46 → 北東の経路に変更
    (JTAG を B.Cu で北上させる通路 x 55.4–60 を確保するため)
    - KiCad 7 DRC: エラー 0、未接続 95 で変化なし。導通確認、電源監査 PASS
    - 右辺の現状分析を CLAUDE.md に記録
    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
    [amiga_scandoubler_v030wip.kicad_pcb]
2026-09-28 v030wip: 課題5 U2 右辺の JTAG 系・設定ピン(4–10番)を J4 とプルアップへ接続
    - 利用者判断で C37/C31/R4/R9 を移動し、右辺正面に引き出し用の場所を確保
    - pin4–9 は 0.55mm 階段状ビア、pin10 は内側ビアから B.Cu で北上
    - 7 本を y=33.5 で北西へ曲げ、J4 の列位置で F.Cu に上がって J4 へ(交差なし)
    - 1V2 右リンクを In2 x=55.0 へ、pin12/pin2/pin1 の電源接続を付け替え
    - KiCad 7 DRC: エラー 0、未接続 95→78。導通 24 組確認、電源監査 PASS
    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
    [amiga_scandoubler_v030wip.kicad_pcb]
2026-09-28 v0.31 DAC 再ピン: U2→U3 を交差なしにするピン割当へ変更
    - 出力用 28 ピン(3,13-20,25-42,47)を U3 の周回順に合わせて再割当
    R0=47, R1-7=42-36, G0-7=35-28, BLANK=27, B0/1=26/25, B2-7=20-15,
    H_OUT=14, V_OUT=13, DAC_CLK=3
    - constraints/amiga_board_top_v031dac.cst を追加し amiga_board_top.cst を更新
    - 基板の U2 パッドネットを書き換え(DRC エラー 0、未接続 78 で変化なし)
    - YoWASP yosys/nextpnr で P&R: 1816/2048 とも全クロック PASS、phase180 検査 PASS
    DAC 出力の抽出遅延(推定)は最大 3.93/4.25ns(半周期 8.81ns に対し余裕)
    - 結果とログを work/v031dac/fpga/ に保存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
    [amiga_scandoubler_v030wip.kicad_pcb]
2026-09-28 v030wip: 課題5完了 — H/V_OUT_RAW と DAC_CLK_RAW を v0.31 ピンで配線
    - V(pin13)/H(pin14) は F.Cu → ビア → B.Cu で南東へ、既存の U5 行き B.Cu に合流
    - DAC_CLK(pin3) は F.Cu のみで U6.2 へ、R43 へ分岐
    - 課題6の B バス/G・BLANK の予定通路を空けるため、旧 R41/R42 付近の部分配線を撤去
    - R41/R42 を U5 手前へ、R14 を通路間の隙間へ、C37 を南側へ移動
    - KiCad 7 DRC: エラー 0、未接続 78→73。導通 11 組確認、電源監査 PASS
    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
    [amiga_scandoubler_v030wip.kicad_pcb]
2026-09-28 v030wip: 課題6 手順1 — REF_27M を EP 下 y=41 経由に付け替え
    - U2 上辺の下(B.Cu y=38.3)と左上角を通っていた REF_27M を撤去
    - ビア (40.2,34) → 左辺パッド列の下 → EP 下 y=41 → 内周ビア (53.96,41.9) → U2.11
    - DAC バスの扇形のため U2 上辺の下と左上角の B.Cu を空けた
    - KiCad 7 DRC: エラー 0、未接続 73 で変化なし。導通確認、電源監査 PASS
    - 導通確認ツール tools/conn.py を追加
    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
    [amiga_scandoubler_v030wip.kicad_pcb]
2026-09-28 Issue 6: route the DAC bus fan-out (R/G/B, BLANK) U2 -> U3
    - Reconnect the power pins at U2's top corners so the fan can pass (d6_corner_*).
    - Route all 24 DAC data lines plus BLANK on F.Cu with no crossings. Only R0 uses vias (2).
    - Route DAC_CLK U3 -> R24 -> U6.
    - Move R10, R14, R24, R44, C29, C35, C36, C40 and C44.
    - Change C42 (COMP) to 0402 so it fits clear of U3's courtyard. The schematic, netlist and manifest are updated to match.
    - DRC errors 0. Unconnected items 73 -> 44 (all DAC nets complete). 54 connectivity pairs checked. The power audit is unchanged.
    Claude-Session: https://claude.ai/code/session_019f929sAJ7LRnJRRFvA6g9F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
    [03_dac.kicad_sch, amiga_scandoubler_v030wip.kicad_pcb]
2026-09-29 Issue 7: connect the remaining power and ground pads
    - Add a short F.Cu stub and a plane via to each of the 28 island GND/3V3 pads. Positions were found by tools/viastub.py and are saved in scripts/p7_viastub_plan.json.
    - Link J1.10 to J1.5. Place vias on the J2.7/J2.8 pads, which are enclosed by other routing.
    - Connect the island pads of ADC_3V3A (C62/C63), ADC_1V9PLL (C66/C67) and DAC_3V3 (C68/C69).
    - DRC errors 0. Unconnected items 44 -> 7 (only the analog inputs remain). Both planes remain in one piece. The power audit is unchanged.
    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
    [amiga_scandoubler_v030wip.kicad_pcb]
2026-09-29 Issue 8: route the last analog inputs (board fully connected)
    - Open the U1 input pins that other routing had walled in:
    - ADC_1V9A pin7 -> C14 and ADC_3V3A pin13/14 -> C16. The caps stay connected through their vias and In2.
    - The GIN_4, BIN_3 and GIN_1 routes.
    - The In2 ADC_1V9A and ADC_3V3A lines.
    - RIN_1-3 escape through vias west of pins 9-11. The rest were routed with router7 and saved in p8_routes.json.
    - The In2 3V3 zone now always removes isolated fill islands.
    - DRC errors 0. Unconnected items 7 -> 0. 28 connectivity pairs checked. The power audit is unchanged.
    Claude-Session: https://claude.ai/code/session_019f929sAJ7L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
    [amiga_scandoubler_v030wip.kicad_pcb]
2026-09-29 Issue 9: sync design documents with the v0.31 U2 pin assignment
    - Use the board's U2 pad nets (= amiga_board_top.cst, v031dac) as the reference.
    - Rename the 57 U2 pin labels in 02_fpga.kicad_sch.
    - Update the netlist, circuit_manifest, fpga_pin_assignment, board_port_map and sync_out_progress (H/V_OUT_RAW now on pins 14/13).
    - Checks: a netlist exported from the schematic matches the board on all 587 nodes, and all cst ports exist in the RTL top.
    - audit_sync_in_k7.py now passes with no failures.
    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
    [02_fpga.kicad_sch]
2026-09-29 Review v0.30wip routing and run the RTL simulations
    - Run all 12 sim/run_*.py scripts under Icarus Verilog 12: 82 PASS, 0 failures. Logs are in work/v031dac/sim.
    - Estimate DAC/ADC timing with board lengths. Check reference-plane gaps and decoupling distances.
    - Findings: U2 pins 12/23 (3V3) have no nearby decoupling cap (11.6 / 9.3 mm). GIN_1 crosses the In2 supply lines for 4.9 mm.
    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
2026-09-29 Review fixes: decaps for U2 VCCO pins 12/23; move In2 lines off GIN_1
    - #1: Add C70/C71 (100nF 0402) at 1.5 / 1.1 mm from U2 pins 12/23. Schematic, netlist and manifest updated; the schematic export matches the board on 591 nodes.
    - #2: Re-draw the In2 ADC_3V3A/ADC_1V9A links so they cross GIN_1 instead of running under it (gap 4.9 -> 4.5 mm).
    - #3: Stitching vias dropped. With In1 as the only GND plane they connect to nothing. Decaps near the REF_27M vias remain proposed.
    - DRC errors 0, unconnected 0. The audit passes; its part/pad counts are updated to 137/596.
    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
    [02_fpga.kicad_sch, amiga_scandoubler_v030wip.kicad_pcb]
2026-09-29 Add decaps C72/C73 next to the REF_27M layer-change vias
    - Placements found by tools/capvia.py (0402, short stubs to new plane vias, no via-in-pad).
    - Via-to-decap distance: 5.2 -> 1.6 mm and 4.3 -> 0.8 mm. The via under U1 (30.4,35.6) has no room and stays at 6.2 mm.
    - Schematic (02_fpga), netlist and manifest updated; the schematic export matches the board on 595 nodes.
    - DRC errors 0, unconnected 0. The audit passes with 139 parts / 600 pad nets.
    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
    [02_fpga.kicad_sch, amiga_scandoubler_v030wip.kicad_pcb]
2026-09-29 Issue 10: silkscreen clean-up, fab outputs and bitstreams
    - Silkscreen:
    - All 139 reference designators set to 0.8/0.15 mm and auto-placed clear of pad openings, silk, texts and the board edge; none hidden.
    - The stale review banner is replaced by the revision text, and the U1/U2 pin-1 markers are moved off their pads.
    - Silk warnings drop from ~220 to 2 (the J3 outline at the board edge).
    - fab/v030wip: Gerbers, drills (PTH/NPTH), position file, JLC BOM/CPL, parts-to-select list, gerbv preview.
    - Drill hits match the board (303 PTH / 6 NPTH).
    - Bitstreams for H_SAMPLES 1816/2048 packed with apycula. They are not verified on hardware.
    - DRC errors 0, unconnected 0. The audit passes.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
    [amiga_scandoubler_v030wip-B_Cu.gbl, amiga_scandoubler_v030wip-B_Mask.gbs, amiga_scandoubler_v030wip-B_Paste.gbp, amiga_scandoubler_v030wip-B_Silkscreen.gbo, amiga_scandoubler_v030wip-Edge_Cuts.gm1, amiga_scandoubler_v030wip-F_Cu.gtl, amiga_scandoubler_v030wip-F_Mask.gts, amiga_scandoubler_v030wip-F_Paste.gtp]
2026-09-29 Add per-line part requirements for LCSC selection
    The requirements are derived from each part's connected rails and signals in circuit_manifest.json: rated voltage, dielectric and resistor tolerance. They are used to pick LCSC parts once jlcpcb.com / lcsc.com are reachable.
    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
    [parts_requirements.csv]
2026-09-29 Select LCSC parts with live JLCPCB stock/price (135 of 139 parts)
    - r11_select.py queries JLCPCB's public component search. It matches package and spec (C/V/dielectric, R/tolerance, 0.1% thin film) and ranks basic > preferred > stock.
    - Results are in fab/v030wip/parts_selection.csv/.json. r11_apply.py writes LCSC/MPN into the manifest, schematic symbols and netlist.
    - Open items:
    - U1 TVP7002: stock 4.
    - J1/J2 CONEC 33DSMT1-E15SNCT: stock 0.
    - Y1 ECS-3225MVLC-270: stock 4. YXC OT2EL4C4JI-111OLP-27M (C5203549) is a datasheet-checked drop-in candidate.
    - Nets unchanged (595 nodes match the board). The audit passes. Nothing ordered.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
    [01_adc.kicad_sch, 02_fpga.kicad_sch, 03_dac.kicad_sch, 04_connectors.kicad_sch, 05_power.kicad_sch, 06_support.kicad_sch, jlc_bom.csv, parts_selection.csv]
2026-09-29 Replace Y1 with YXC OT2EL4C4JI-111OLP-27M; reselect parts for 2 boards
    - Y1: ECS-3225MVLC-270 (LCSC stock 4) -> C5203549, a pin/land-compatible 3225 CMOS oscillator (datasheet checked). Footprint and routing unchanged.
    - Selection re-run for a 2-board build (JLCPCB PCBA minimum is 2). U1 is covered (stock 4). J1/J2 carry C3146802 for Global Sourcing.
    - All 139 parts now have LCSC numbers.
    - Nets still match (595 nodes). DRC errors 0, unconnected 0. The audit passes.
    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
    [04_connectors.kicad_sch, 06_support.kicad_sch, amiga_scandoubler_v030wip.kicad_pcb, jlc_bom.csv, parts_selection.csv, parts_to_select.csv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]
2026-09-29 Add DNP-U1/U2 BOM/CPL variant for hand soldering
    jlc_bom_dnp_U1U2.csv / jlc_cpl_dnp_U1U2.csv exclude U1 (TVP7002) and U2 (GW1N). The README notes the EP soldering and via-fill implications.
    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
    [jlc_bom_dnp_U1U2.csv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]
2026-09-29 Switch hand-solder variant to J1/J2 (DNP at JLC); U1/U2 stay assembled
    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
    [jlc_bom_dnp_J1J2.csv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]
2026-09-29 Replace J1/J2 with THT HYC06-HDR15B-060 (3-row DE-15 female)
    - New footprint DE15_HOAUC_HYC06-HDR15B-060 from the HOAUC drawing
    (rows 3.08/5.06/7.04 mm from edge, 2.29x1.98 pitch, 2x 3.2 mm PTH locks).
    - Board: old CONEC SMD footprints and their fan-out removed (jc_rm.py),
    new parts placed (jc_add.py), 10 signals re-routed with router7 (3 vias),
    covered references re-placed (jc_silk.py).
    - DRC 0 errors / 0 unconnected, audit PASS, schematic netlist matches
    (570 connected nodes), drill hits match.
    - Schematic, netlist, manifest, parts selection (C711364) and all fab
    outputs regenerated; README/revision/CLAUDE.md updated.
    Claud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
    [04_connectors.kicad_sch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]
2026-09-29 Add netlist-based ERC substitute (KiCad 7 CLI has no ERC) and its report
    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
2026-09-29 ERC with KiCad 9 CLI (read-only, unpacked alongside KiCad 7): script and report
    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
2026-09-29 ERC: add PWR_FLAG to 9 supply nets, record U3 IO*_N exclusion; ERC clean after exclusions
    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
    [05_power.kicad_sch]
2026-09-30 Add CPL rotation check sheet (pin-1 positions for polarized parts, unofficial JLC correction hints)
    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
2026-09-30 CPL: verify rotations/offsets against EasyEDA footprints and apply JLC corrections
    - tools/jlc_rotcheck.py: per-part pad match (EasyEDA vs KiCad), rotation R and origin offset
    - r10_fab.py applies fab/v030wip/jlc_rotation_check.json when writing jlc_cpl*.csv
    - U1/U3/U4/U5 +270, U2 180->90, U6 180, J4 90->0, J3 +1.571 mm inward
    - check sheet updated with verified values
    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
    [jlc_cpl.csv, jlc_cpl_dnp_J1J2.csv]
2026-09-30 JLC DFM/order fixes: move vias off pads, widen J3 slots, re-place silk, replace L1-L3, merge C15850 BOM line
    - dfm_vias.py: 31 vias moved (pad gap >= 0.15 mm), via-in-pad removed on C56/C58/C59/C60/C71
    - dfm_fix2.py: C71/C29 +0.4 mm, J3 footprint with 0.8 mm slots, C15850 values unified
    - dfm_silk.py: 50 reference texts re-placed away from pads/holes
    - L1-L3 -> Taiyo Yuden NRS4018T2R2MDGJ (C92959, EasyEDA footprint available)
    - DRC 0 errors / 0 unconnected, audit PASS, ERC clean, fab outputs regenerated
    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
    [03_dac.kicad_sch, 05_power.kicad_sch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]
2026-09-30 WIP dfm_vias.py: keep via->pad stubs, reconnect touched pads, prefer axis moves, fail on zero-length tracks
    Fixes the C59 GND stub collapse found after 41883af (board not regenerated yet).
    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
2026-09-30 Fix C59 GND stub collapse from the DFM via move; square up regulator loops; add pad-connection check
    - dfm_vias.py: via->pad stubs stay, untouched pads get a new track to the moved via, tiny in-via pieces deleted
    - dfm_fix2.py: slanted wide legs squared back to vertical
    - tools/padconn_cmp.py: no pad lost or narrowed its connection vs the pre-DFM board
    - DRC 0/0, audit PASS, netlist/ERC unchanged; fab outputs regenerated
    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
    [amiga_scandoubler_v030wip-B_Cu.gbl, amiga_scandoubler_v030wip-B_Mask.gbs, amiga_scandoubler_v030wip-B_Paste.gbp, amiga_scandoubler_v030wip-B_Silkscreen.gbo, amiga_scandoubler_v030wip-Edge_Cuts.gm1, amiga_scandoubler_v030wip-F_Cu.gtl, amiga_scandoubler_v030wip-F_Mask.gts, amiga_scandoubler_v030wip-F_Paste.gtp]
2026-09-30 Remove tracks running between adjacent IC pins (U1 x11, U3 x3, U5.5); re-route the isolated pins
    - dfm_u1pll.py: U1.85 straight off its tip to the ADC_1V9PLL via (JLC DFM danger 0.05 mm)
    - dfm_gapfix.py: 52 gap segments + 18 dangling pieces removed, 12 pins re-routed with pin gaps blocked
    - tracks in pin gaps 0, DRC 0/0, audit PASS, netlist match, no pad lost/narrowed its connection
    - fab outputs regenerated (BOM/CPL unchanged)
    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
    [amiga_scandoubler_v030wip-B_Cu.gbl, amiga_scandoubler_v030wip-B_Mask.gbs, amiga_scandoubler_v030wip-B_Paste.gbp, amiga_scandoubler_v030wip-B_Silkscreen.gbo, amiga_scandoubler_v030wip-Edge_Cuts.gm1, amiga_scandoubler_v030wip-F_Cu.gtl, amiga_scandoubler_v030wip-F_Mask.gts, amiga_scandoubler_v030wip-F_Paste.gtp]
2026-09-30 Remove overlapping same-net track copies and dead spurs; tidy U1.93/94-C27/C28
    - dfm_dedup.py: 44 overlapping same-net pairs -> 0 (41 copies + 9 dangling pieces, 50 lines),
    only where the net's pad connectivity is unchanged
    - dfm_spur.py: dead spurs removed via biconnected blocks (ADC_1V9PLL In2 ~3 mm hairpin, H_OUT)
    - dfm_tidy.py: U1.93 joins U1.94's corner, C27/C28 fed as a tree from the In2 via,
    leftover ADC_1V9PLL diagonal and H_OUT overshoot removed
    - DRC 0 errors / 0 unconnected / 0 dangling, audit PASS, 570-node netlist match,
    no pad lost or narrowed its connection; fab outputs regenerated (BOM/CPL unchanged)
    Claude-Sessio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
    [amiga_scandoubler_v030wip-B_Cu.gbl, amiga_scandoubler_v030wip-B_Mask.gbs, amiga_scandoubler_v030wip-B_Paste.gbp, amiga_scandoubler_v030wip-B_Silkscreen.gbo, amiga_scandoubler_v030wip-Edge_Cuts.gm1, amiga_scandoubler_v030wip-F_Cu.gtl, amiga_scandoubler_v030wip-F_Mask.gts, amiga_scandoubler_v030wip-F_Paste.gtp]
2026-10-01 Tidy GND between C27 and U1.90-92, spread C21's vias, merge U4.5-C51 parallel lines
    - dfm_tidy2.py: U1.91 straight into the GND via, U1.90 joins U1.91's corner, C27.2 into the via centre;
    C21 3V3 via moved 0.26 -> 0.47 mm from its GND via; U4.5 -> via -> C51 as one line
    - no overlapping vias board-wide; no same-net parallel lines with a gap < 0.15 mm left
    - DRC 0/0, audit PASS, 570-node netlist match, no pad lost/narrowed its connection; fab outputs regenerated
    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
    [amiga_scandoubler_v030wip-B_Cu.gbl, amiga_scandoubler_v030wip-B_Mask.gbs, amiga_scandoubler_v030wip-B_Paste.gbp, amiga_scandoubler_v030wip-B_Silkscreen.gbo, amiga_scandoubler_v030wip-Edge_Cuts.gm1, amiga_scandoubler_v030wip-F_Cu.gtl, amiga_scandoubler_v030wip-F_Mask.gts, amiga_scandoubler_v030wip-F_Paste.gtp]
2026-10-01 Smooth the router's 0.05-grid staircases into long straight / 45-degree runs
    - dfm_planeloop.py: GND/3V3 detours (thin, jogged) that only duplicate the plane removed (R16-C18 arc, U3 GND stub)
    - dfm_smooth.py (+ tools/trackchains.py): chains redrawn by greedy pull-taut with 1-2 octilinear segments,
    clearance 0.2 to other nets, no same-net pads/vias other than the chain's ends; 2 passes, 399 -> 191 segments
    - dfm_tidy3.py: hand fixes where T-junctions pin the chain (U1.77/79 GND, U1.13/14, FB4-C42-C47, U2 corner GND)
    - tools/jogscan.py: short jogs 198 -> 14 (corner chamfers etc. left); pcbedit.remove_segment(dup_ok)
    - DRC 0/0, audit PASS, 570-node netlist match, no pad lost/narrowed its con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
    [amiga_scandoubler_v030wip-B_Cu.gbl, amiga_scandoubler_v030wip-B_Mask.gbs, amiga_scandoubler_v030wip-B_Paste.gbp, amiga_scandoubler_v030wip-B_Silkscreen.gbo, amiga_scandoubler_v030wip-Edge_Cuts.gm1, amiga_scandoubler_v030wip-F_Cu.gtl, amiga_scandoubler_v030wip-F_Mask.gts, amiga_scandoubler_v030wip-F_Paste.gtp]
2026-10-01 Fab notes: EP vias need Epoxy Filled & Capped (POFV), not Plugged; spell out CPL preview checks
    - README / revision / CLAUDE.md: U1/U2 EP vias (9 + 9, GND 0.6/0.3) listed with coordinates; JLC "Plugged"
    is soldermask plugging for vias without mask openings, so via-in-pad needs Epoxy Filled & Capped,
    chosen explicitly on a 4-layer order; open question on JLC's 0.15-0.55 mm range (hole vs land diameter)
    - CPL: the EasyEDA-based corrections still need the JLC placement preview; checks for J3 (1.571 mm
    offset, legs in the 4 slots, 2 locating pins) and U1/U2 pin 1 written out
    - no board or fab-data change
    Claude-Session: https://claud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
2026-10-01 Shrink the 18 U1/U2 exposed-pad vias to 0.5 mm land (0.3 mm drill kept)
    - ep_via05.py: size 0.6 -> 0.5 on the 9 + 9 GND vias inside U1 pad 101 / U2 pad 89, so they sit inside
    JLC's Epoxy Filled & Capped range (0.15-0.55 mm) under either reading of "via diameter"
    - notes: 0.10 mm annular ring may show in JLC DFM; 146 other vias stay at 0.6 mm (check on the order page)
    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
    [amiga_scandoubler_v030wip-B_Cu.gbl, amiga_scandoubler_v030wip-B_Mask.gbs, amiga_scandoubler_v030wip-B_Paste.gbp, amiga_scandoubler_v030wip-B_Silkscreen.gbo, amiga_scandoubler_v030wip-Edge_Cuts.gm1, amiga_scandoubler_v030wip-F_Cu.gtl, amiga_scandoubler_v030wip-F_Mask.gts, amiga_scandoubler_v030wip-F_Paste.gtp]
2026-10-01 Fix corner overhangs: 5V bus drops widened to 0.8 mm, bus overshoot at C59 trimmed, two GND ends seated
    - dfm_corner.py: C55/C57/C59 drops 0.6 -> 0.8 mm to match the y=80 5V bus (its round end no longer sticks
    out at the corners); bus end 67.45 -> 66.95; U3.31 GND lead into the via centre; U1.15 GND vertical
    reaches U1.12's line
    - tools/cornerscan.py: width-change corners and overshooting free ends (1 intended neck left at U2.1)
    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
    [amiga_scandoubler_v030wip-B_Cu.gbl, amiga_scandoubler_v030wip-B_Mask.gbs, amiga_scandoubler_v030wip-B_Paste.gbp, amiga_scandoubler_v030wip-B_Silkscreen.gbo, amiga_scandoubler_v030wip-Edge_Cuts.gm1, amiga_scandoubler_v030wip-F_Cu.gtl, amiga_scandoubler_v030wip-F_Mask.gts, amiga_scandoubler_v030wip-F_Paste.gtp]
2026-10-01 JLC DFM: clear silkscreen off pads and holes, move the C28 lead off C27's mask opening
    - dfm_silk2.py: footprint silk cut back to >= 0.16 mm from pads / >= 0.2 mm from holes (0402 ticks of
    R37-R40, C42, C70-C73; J1/U5/R2/C68/C71 lines over vias), short leftovers moved to F.Fab; U2 pin-1 dot
    moved off the pin-1 via; "REV 0.30 2026-09" moved off the JTAG vias
    - dfm_tidy4.py: ADC_3V3A via -> C28.1 rerouted 0.475 mm clear of C27.1 (was 0.071 mm from its opening)
    - remaining DFM dangers (pad spacing 3, annular ring 1, via to pad 1) reviewed and accepted
    - DRC 0/0, audit PASS, 570-node netlist match, no pad lost/narrowed its connection; fab outputs regenerated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
    [amiga_scandoubler_v030wip-B_Cu.gbl, amiga_scandoubler_v030wip-B_Mask.gbs, amiga_scandoubler_v030wip-B_Paste.gbp, amiga_scandoubler_v030wip-B_Silkscreen.gbo, amiga_scandoubler_v030wip-Edge_Cuts.gm1, amiga_scandoubler_v030wip-F_Cu.gtl, amiga_scandoubler_v030wip-F_Mask.gts, amiga_scandoubler_v030wip-F_Paste.gtp]
